jamesloper/lemontron/README.md

This is the official Lemontron website source code (lemontron.com). It is a static site generated with Jekyll and hosted on GitHub
Pages.
