jamesloper/lemontron/_bom/chassis-fans.md

---
layout: bom
title: 2510 Fan
qty: 2
orders: 1
total: 5.84
description: Chassis Fans
new: false
links: 
  - vendor: AliExpress
    url: https://www.aliexpress.us/item/2251832621295326.html
    note: "24V Ball XH2.54 (2pc)"
  - vendor: Amazon
    url: "https://www.amazon.com/dp/B0BB277V4F?&tag=lemontron-20"
    note: "Blue LED version"
kofi: true
optional: false
category: Electronics
---

Chassis fans cool the electronics.
