jamesloper/lemontron/_posts/2025-01-08-tools-needed.md

---
layout: post
title: Tools needed
description: Affiliate links!
categories: guide
kofi: true
thumbnail: /assets/guide/bed-holder---attach-spine.jpg
permalink: /lemontron/:title/
---

These tools are needed to build the Lemontron. You may already have some of them, but if not, you can buy them
through these Amazon affiliate links!

## Screw Drivers

The Lemontron benefits from deep integration and thus only M3 (2mm Hex Bit) and a few M2.5 are used. I
recommend having a dedicated high quality M3 screwdriver, plus a bit for your drill. Add a countersink bit to clean up
the printed countersinks and to add countersinks to the probe.

<div class="bom-list">
{% include tool-item.html
title = "Drill"
amazon = "B003BEE2LU"
image = "https://m.media-amazon.com/images/I/61DA7ZmQYSL._AC_SL1344_.jpg"
%}
{% include tool-item.html
title = "Driver Bit"
amazon = "B001553HD6"
image = "https://m.media-amazon.com/images/I/516vhCine0L._SS284_.jpg"
%}
{% include tool-item.html
title = "Screw Driver"
amazon = "B00365EYJO"
image = "https://c.media-amazon.com/images/I/41uY2ozOLLL._AC_SX679_.jpg"
%}
{% include tool-item.html
title = "Allen Keys"
amazon = "B083BGVMB8"
image = "https://m.media-amazon.com/images/I/61dimk22KQL._AC_SX679_.jpg"
%}
{% include tool-item.html
title = "Countersink"
amazon = "B00LLGSZGS"
image = "https://m.media-amazon.com/images/I/51H9zNxZ0kL._AC_SL1050_.jpg"
%}
</div>

## 3D Printing Tools

You will need a modern, enclosed 3D printer to print the Lemontron parts. Razors for scraping. A craft knife for tidying
blemishes. Supa glue for the Lemonstruder parts (the "liquid" one not the thick one). And tape for holding down the
pesky wires.

<div class="bom-list">
{% include tool-item.html
title = "Blade"
amazon = "B0BFHB3CXP"
image = "https://m.media-amazon.com/images/I/71CN21bxoXL._SL1500_.jpg"
%}
{% include tool-item.html
title = "Craft Knife"
amazon = "B001A42CTW"
image = "https://c.media-amazon.com/images/I/41fUo+wCOlL._AC_SX679_.jpg"
%}
{% include tool-item.html
title = "Supa Glue"
amazon = "B0D2RP4B82"
image = "https://c.media-amazon.com/images/I/41fqCAwgwsL._SY445_SX342_QL70_FMwebp_.jpg"
%}
{% include tool-item.html
title = "Tape"
amazon = "B07CB6F1BB"
image = "https://m.media-amazon.com/images/I/81uQsI8mtuL._AC_SL1500_.jpg"
%}
</div>

## Electrical Tools

A soldering iron is needed for soldering the edge connector and other wires. For the
motors, you'll need some wire cutters and a crimper. You may try your luck with a soldering iron.

<div class="bom-list">
{% include tool-item.html
title = "Crimper"
amazon = "B078WPT5M1"
image = "https://c.media-amazon.com/images/I/51dedm3GiLL._AC_SL1500_.jpg"
%}
{% include tool-item.html
title = "Wire Strippers"
amazon = "B000XEUPMQ"
image = "https://m.media-amazon.com/images/I/51maEt4e8LL._AC_SX679_.jpg"
%}
{% include tool-item.html
title = "Soldering Iron"
amazon = "B096X6SG13"
image = "/assets/content/pinecil.jpg"
%}
</div>

## Trimming Tools

The motor shafts and X-Axis rail must be shortened. A Dremel with a cutoff wheel is recommended. Flush cutters are also
required, but 3d printers tend to come with those.

<div class="bom-list">
{% include tool-item.html
title = "Dremel"
amazon = "B0D2D28FSV"
image = "https://c.media-amazon.com/images/I/81CnWmPqoML._AC_SX679_.jpg"
%}
{% include tool-item.html
title = "Flush Cutter"
amazon = "B00FZPDG1K"
image = "https://m.media-amazon.com/images/I/41W4+oUpeNL._SX522_.jpg"
%}

</div>
