jamesloper/lemontron/lemontron/index.md

---
layout: post
title: Build a Lemontron
header_title: Lemontron
kofi: true
permalink: /lemontron/
---

{% include youtube-video.html id="n6l3GvkE4QU" %}

Lemontron is a **DIY** project - there are no kits - you must buy the parts online and assemble them.

Watch the video, then follow the build guide below for the most up-to-date instructions.

<div class="paragraph btn-wrapper">
{% include button.html 
icon="looks_one"
title="Download Lemontron" 
link="/lemontron/download/" %}

{% include button.html
icon="looks_two"
title="Order the parts"
link="/lemontron/bom/" %}

{% include button.html
icon="looks_3"
title="Follow the build guide"
link="/lemontron/build-guide/" %}
</div>

## More Guides

{% include guides.html %}

<br/>
All Lemontron content is brand new, so it's subject to changes and fixes, which can be confusing if you are
referencing them. If you have any questions, please reach out to me on Discord.
