jamesloper/lemontron/_posts/2024-12-24-lemontron-open-source-annoucement.md

---
layout: post
title:  "Lemontron open source printer is ready to download"
categories: update
thumbnail: /assets/content/lemontron-printing-a-lemon.jpg
permalink: /news/:title
---

After a year of development, the affordable 3d printer for Australians is finally here, with a build plate that's upside
down, an ultra thin motion system mounted real low, and the flattest tool head you'll ever find.

{% include youtube-video.html id="n6l3GvkE4QU" %}

Lemontron is the newest Positron-style printer, which means it's able to fold up and fit in a box of filament. It is the
most cost-reduced and refined version yet, with a fully 3d printed chassis that you can now print at home, because the
3MF and Fusion 360 project is now available to download!

<div class="btn-wrapper">
{% include button.html title="Build yours" link="/lemontron/" %}
{% include kofi.html %}
</div>
