jamesloper/lemontron/_posts/2024-05-30-lemontron-video-update.md

---
layout: post
title:  "Progress Continues"
categories: update video
thumbnail: https://i.ytimg.com/vi/KzQWi5mGpFI/hqdefault.jpg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
permalink: /news/:title
---

With protective top plates, an integrated extruder and a filament holding solution!

The project is officially now called "Lemontron" to reflect my zest for 3d printing ON THE GO! Exciting times ahead
because the Positron space in general is heating up! Shout out to MihaiDesigns for his video that helped me make an
informed design decision.

{% include youtube-video.html id="KzQWi5mGpFI" %}
