jamesloper/lemontron/_posts/2024-11-11-3rd-prototype.md

---
layout: post
title:  "3rd Prototype"
categories: update video
thumbnail: /assets/posts/2024-11-11.jpg
permalink: /news/:title
---

Development of the Positron 3D printer unibody chassis continues with the 3rd prototype of the Lemontron. Now that it's printing, Lemontron delivers on previous promises and then some!

{% include youtube-video.html id="jw9OEQeSKPE" %}
