jamesloper/lemontron/_posts/2024-03-31-lemontron-intro-video.md

---
layout: post
blog: news
title:  "Lemontron Reveal"
categories: update video
thumbnail: https://i.ytimg.com/vi/JKpA4ocmRE0/hqdefault.jpg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
permalink: /news/:title
---

THE FUTURE IS NOW! @mcfazio4283's "JourneyMaker" design inspired me; Now I'm building a new base for the positron printer with a new UNIBODY design that cuts down on parts! HUGE!!!

{% include youtube-video.html id="JKpA4ocmRE0" %}
