jamesloper/lemontron/assets/about/body.jpg

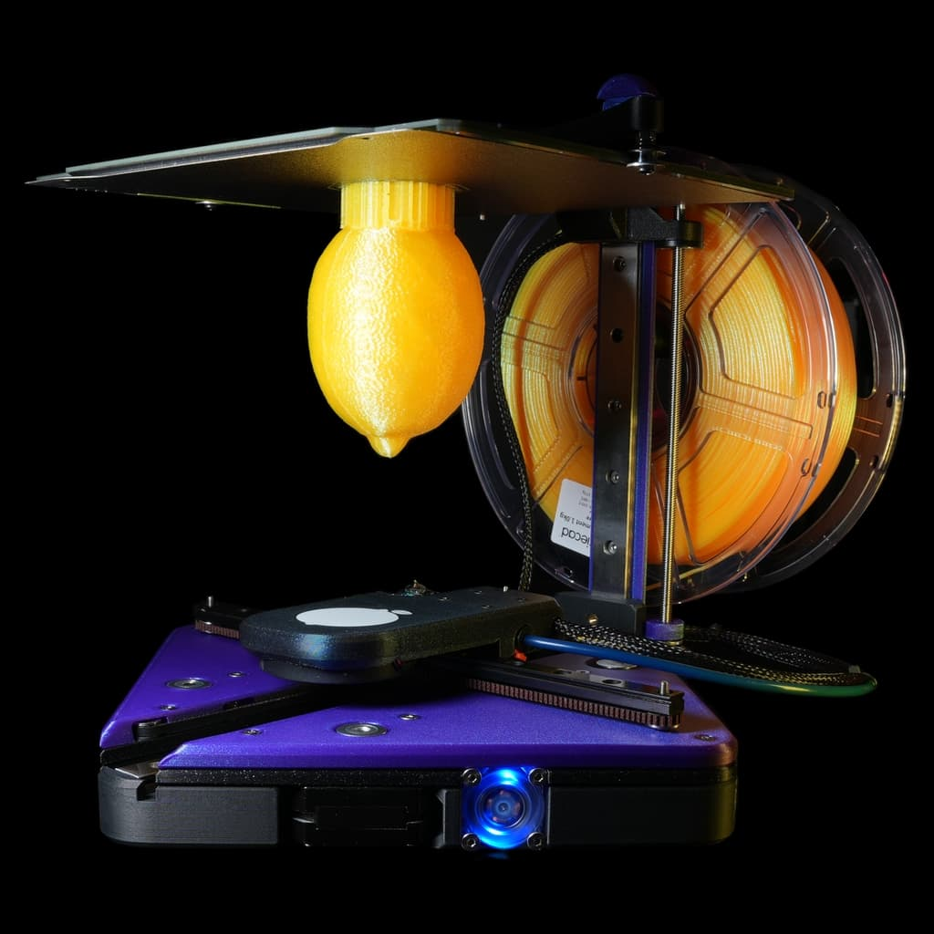
assets/about/body.jpg
