jamesloper/lemontron/assets/about/james.jpg

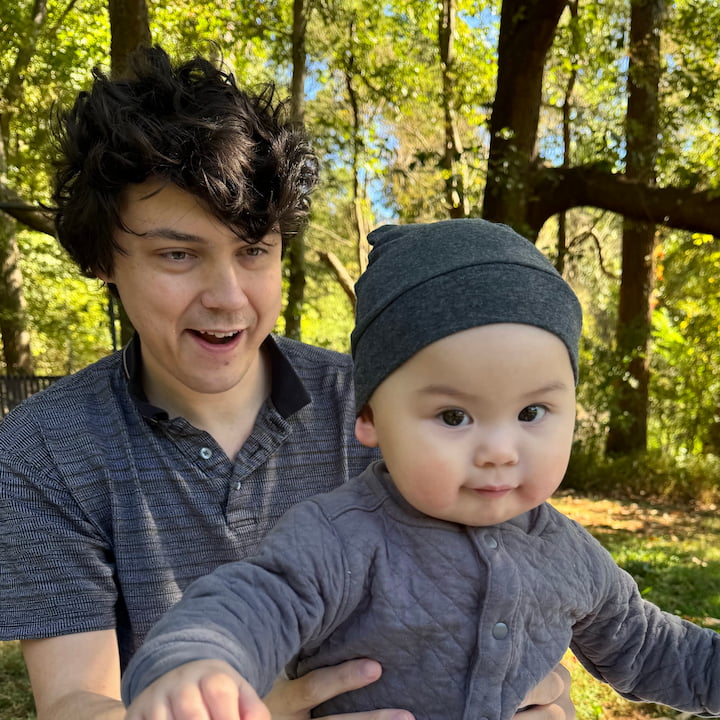
assets/about/james.jpg
