jamesloper/lemontron/assets/about/patreon.png

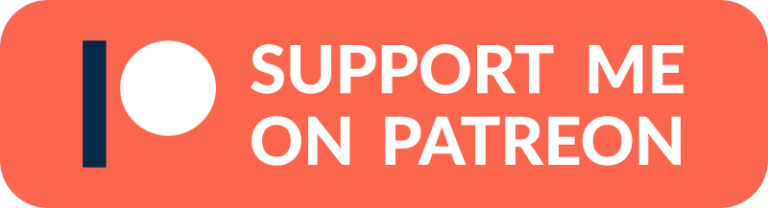
assets/about/patreon.png
