jamesloper/lemontron/assets/bom/chassis-fans.png

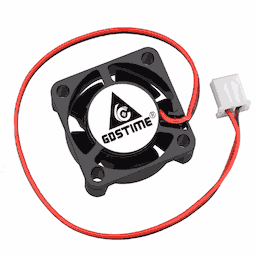
assets/bom/chassis-fans.png
