jamesloper/lemontron/assets/content/crimp.jpg

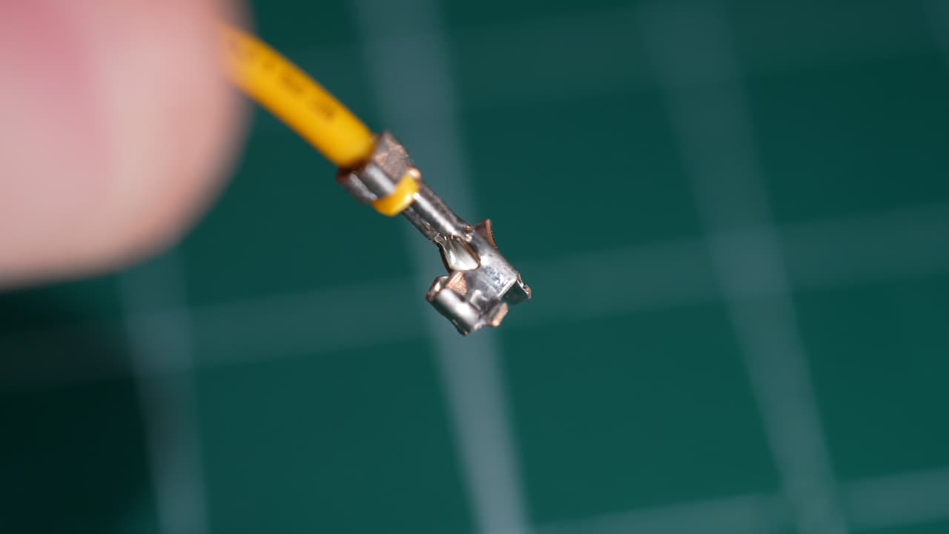
assets/content/crimp.jpg
