jamesloper/lemontron/assets/content/journeymaker.jpg

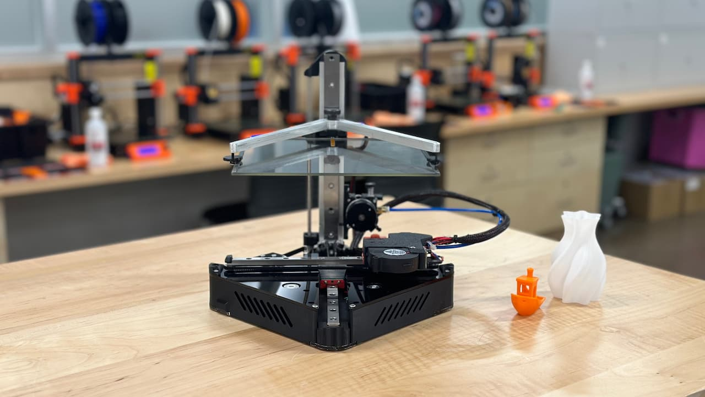
assets/content/journeymaker.jpg
