jamesloper/lemontron/assets/content/pinecil.jpg

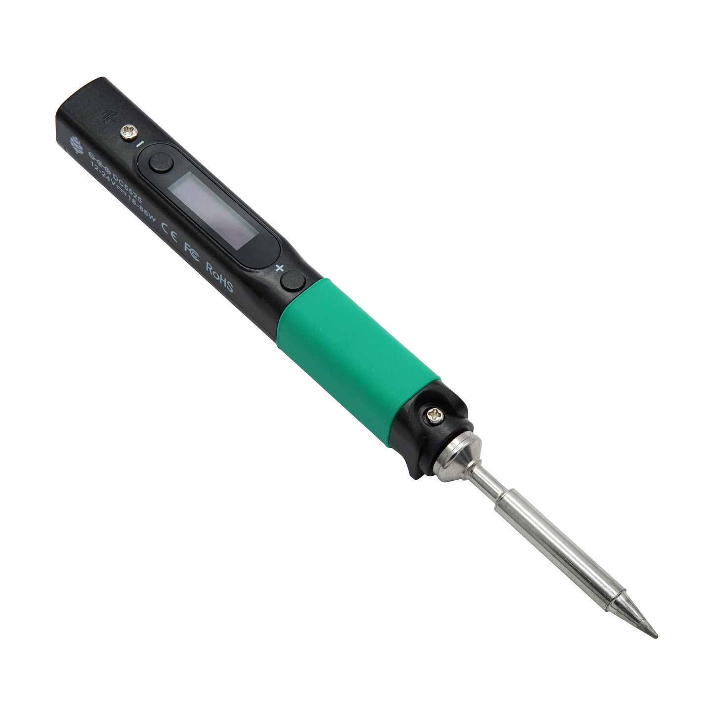
assets/content/pinecil.jpg
