jamesloper/lemontron/assets/guide/chassis---ac-input.jpg

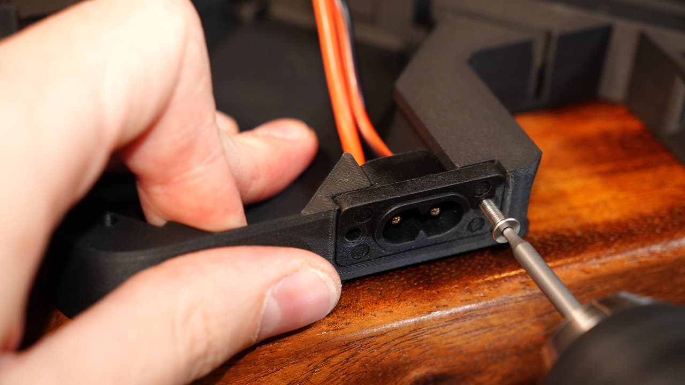
assets/guide/chassis---ac-input.jpg
