jamesloper/lemontron/assets/guide/chassis---attach-z-axis.jpg

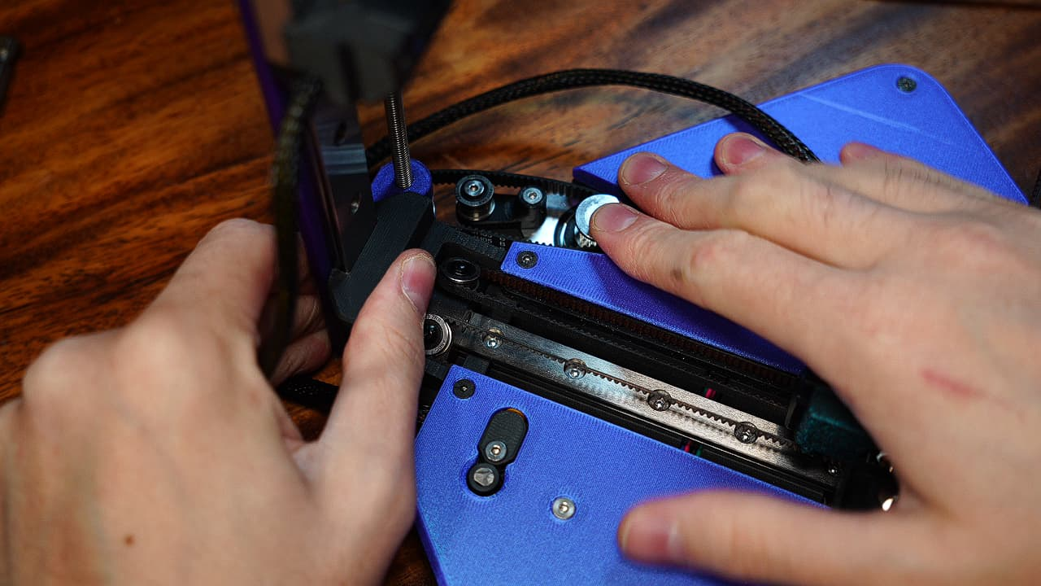
assets/guide/chassis---attach-z-axis.jpg
