jamesloper/lemontron/assets/guide/chassis---attach-z-idler.jpg

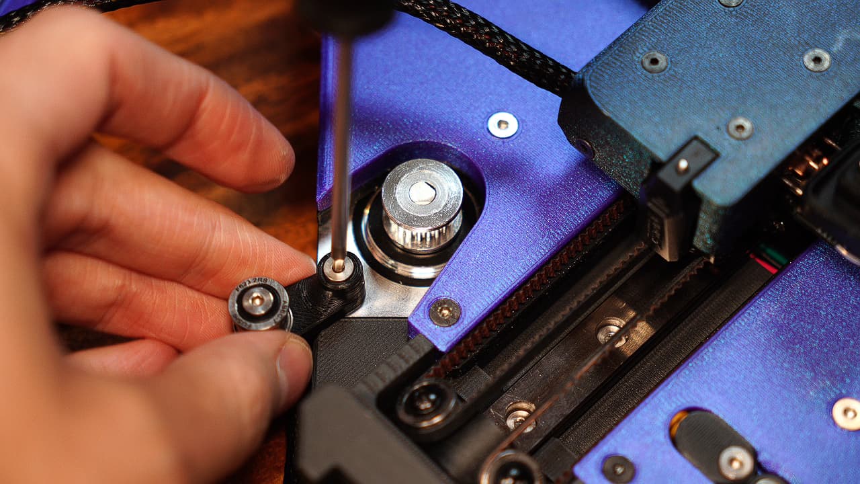
assets/guide/chassis---attach-z-idler.jpg
