jamesloper/lemontron/assets/guide/chassis---bonus-screw.jpg

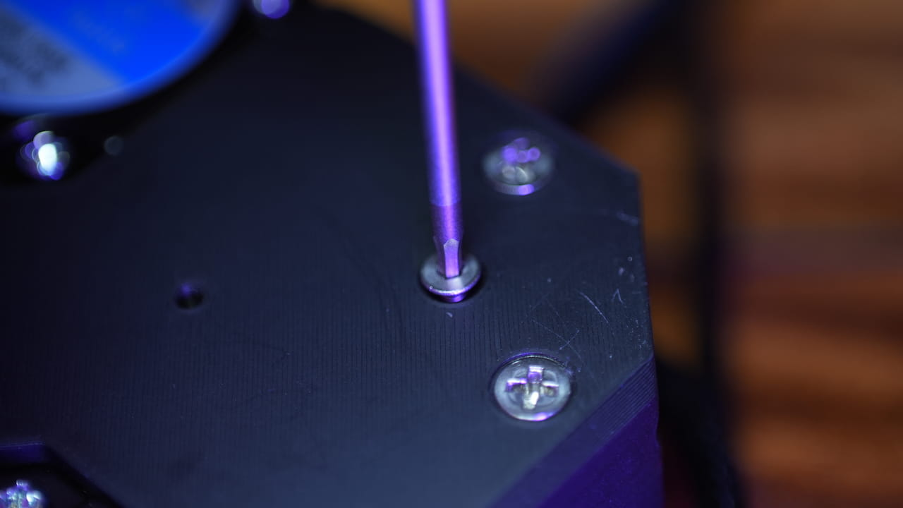
assets/guide/chassis---bonus-screw.jpg
