jamesloper/lemontron/assets/guide/chassis---clean-up-inserts.jpg

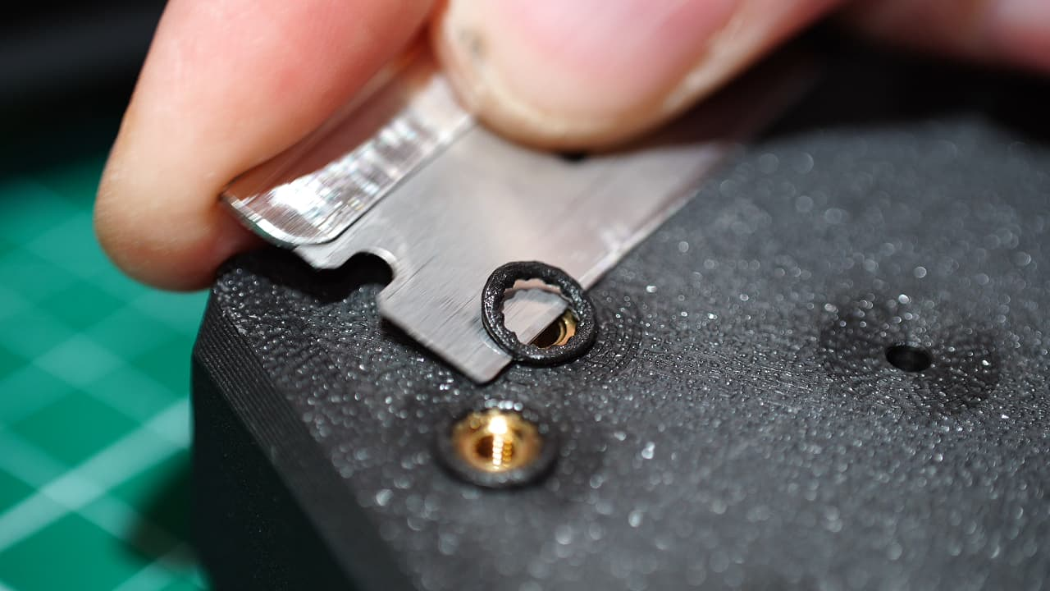
assets/guide/chassis---clean-up-inserts.jpg
