jamesloper/lemontron/assets/guide/chassis---connect-raspberry-pi.jpg

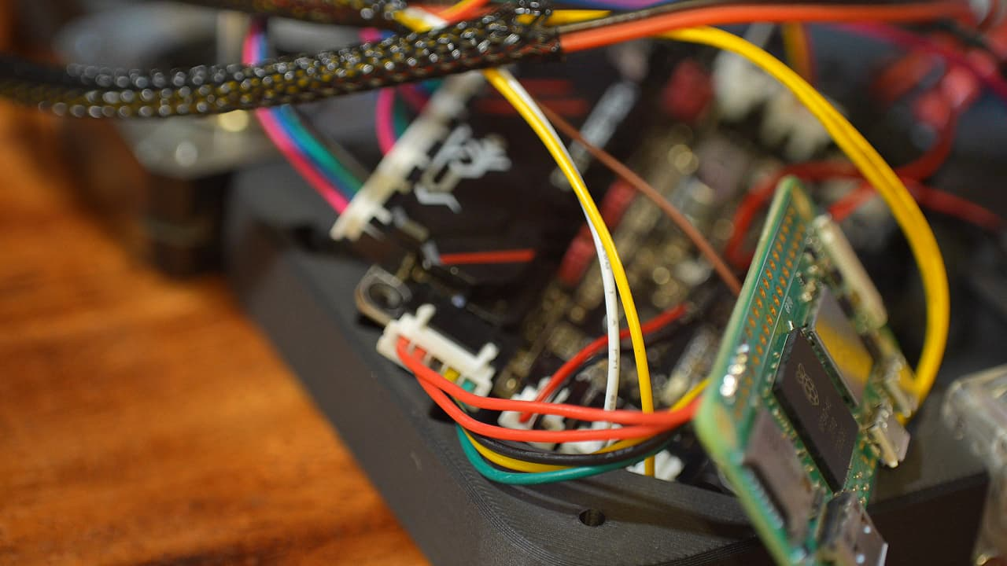
assets/guide/chassis---connect-raspberry-pi.jpg
