jamesloper/lemontron/assets/guide/chassis---fans.jpg

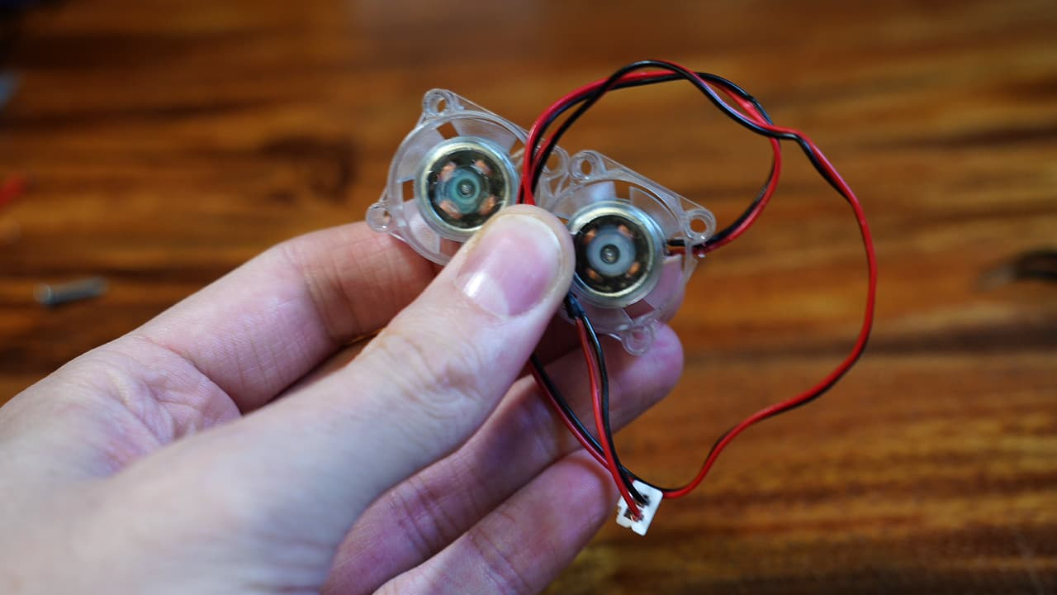
assets/guide/chassis---fans.jpg
