jamesloper/lemontron/assets/guide/chassis---fasten-rail.jpg

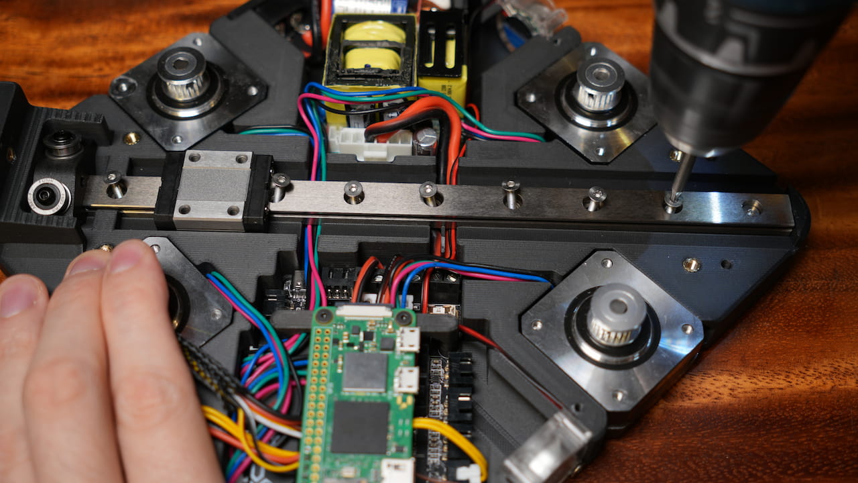
assets/guide/chassis---fasten-rail.jpg
