jamesloper/lemontron/assets/guide/chassis---insert-left-fan.jpg

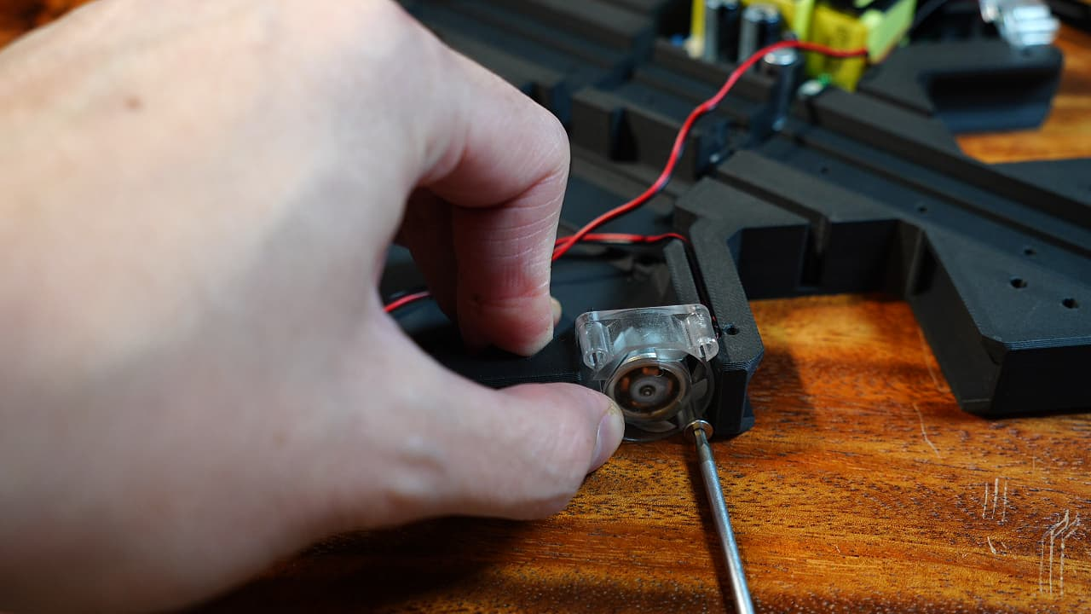
assets/guide/chassis---insert-left-fan.jpg
