jamesloper/lemontron/assets/guide/chassis---insert-motors.jpg

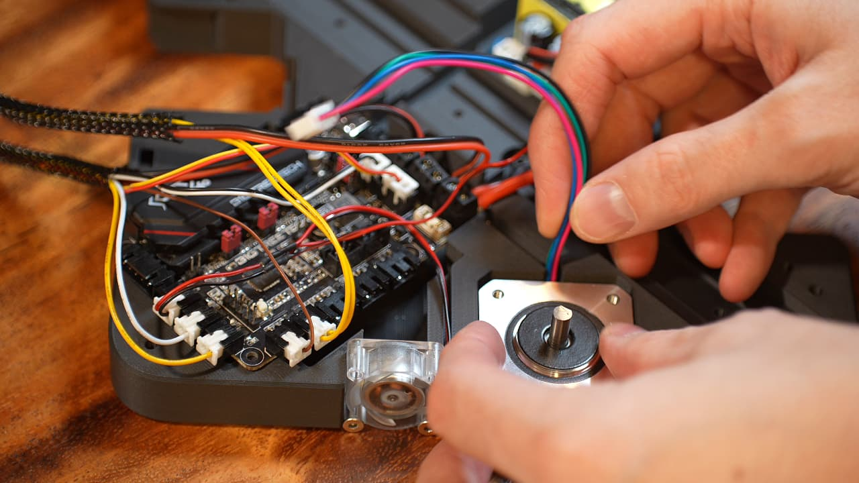
assets/guide/chassis---insert-motors.jpg
