jamesloper/lemontron/assets/guide/chassis---insert-right-fan.jpg

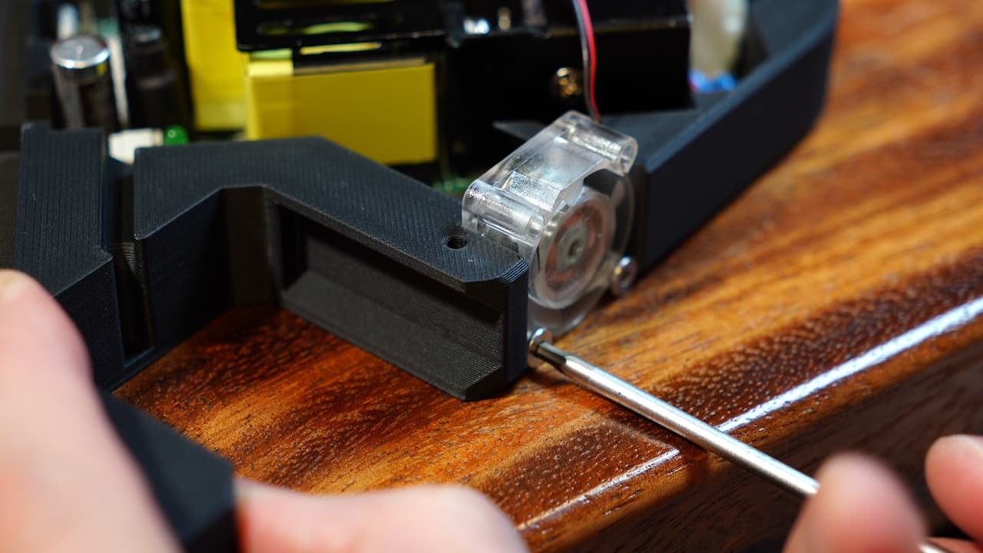
assets/guide/chassis---insert-right-fan.jpg
