jamesloper/lemontron/assets/guide/chassis---left---finish-fan-screws.jpg

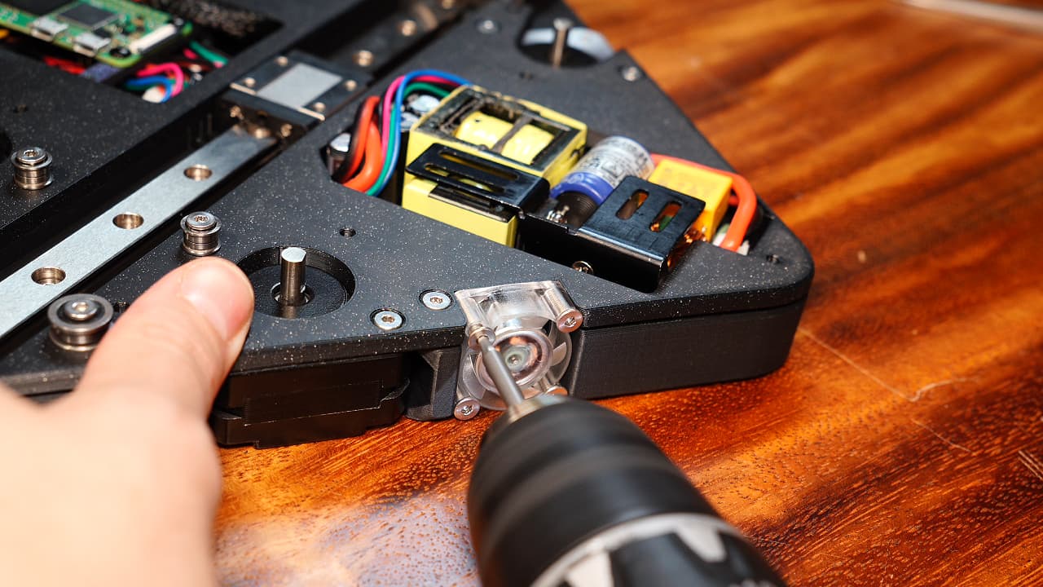
assets/guide/chassis---left---finish-fan-screws.jpg
