jamesloper/lemontron/assets/guide/chassis---plug-in-bed-heater.jpg

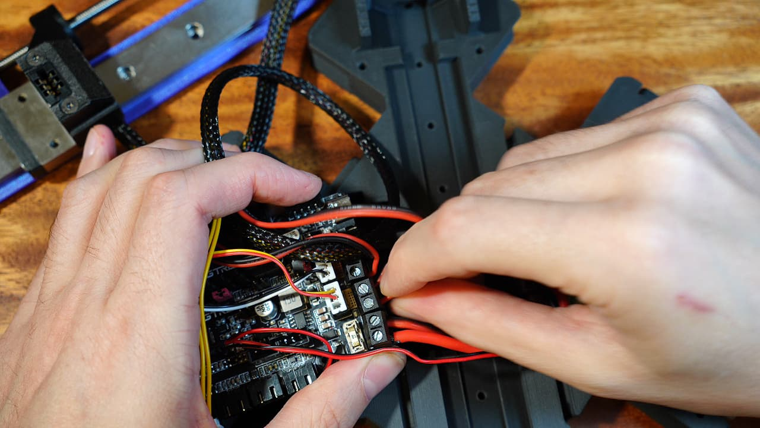
assets/guide/chassis---plug-in-bed-heater.jpg
