jamesloper/lemontron/assets/guide/chassis---plug-in-bed-thermistor.jpg

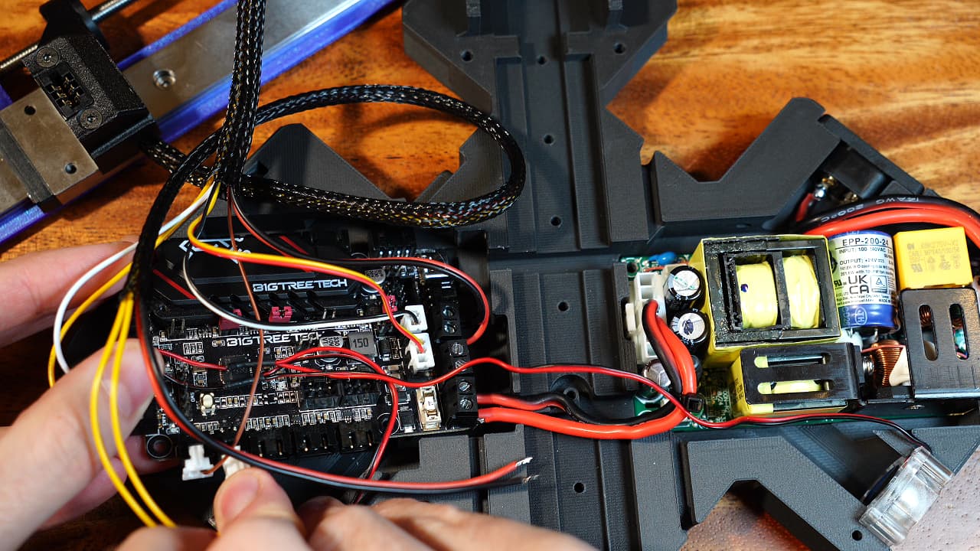
assets/guide/chassis---plug-in-bed-thermistor.jpg
