jamesloper/lemontron/assets/guide/chassis---plug-in-fans.jpg

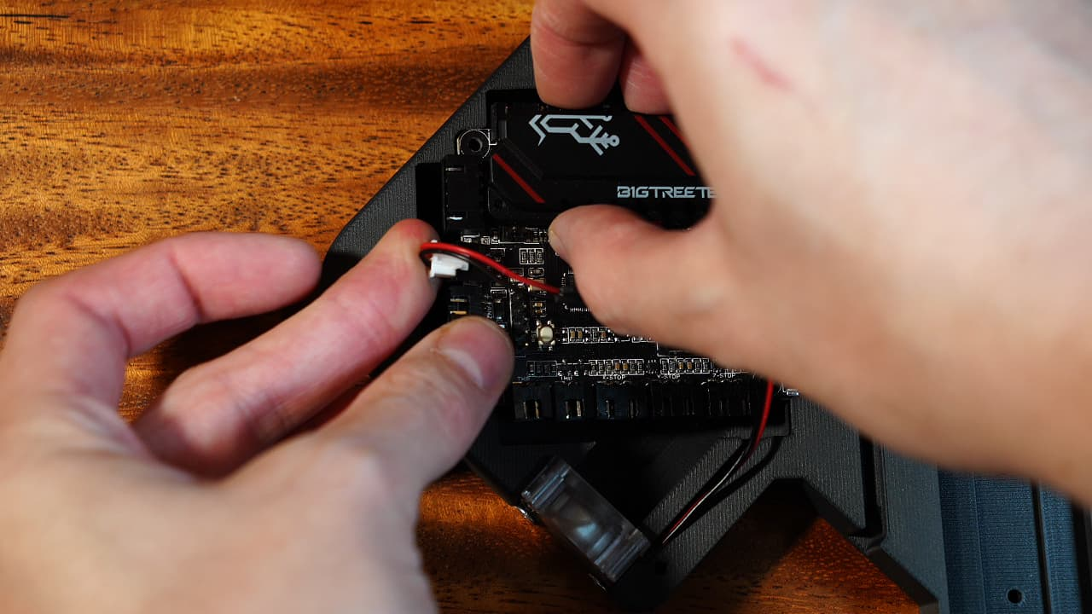
assets/guide/chassis---plug-in-fans.jpg
