jamesloper/lemontron/assets/guide/chassis---plug-in-hotend-fan.jpg

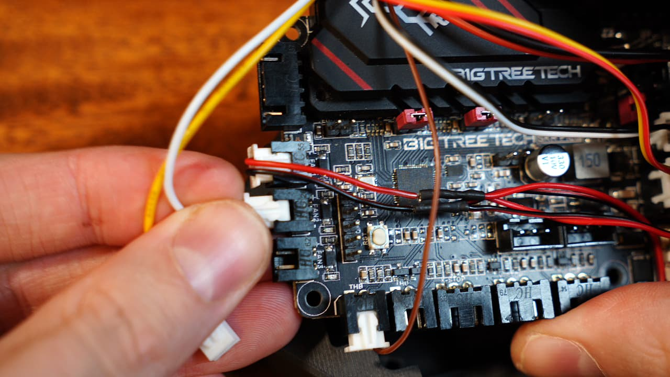
assets/guide/chassis---plug-in-hotend-fan.jpg
