jamesloper/lemontron/assets/guide/chassis---plug-in-hotend-power.jpg

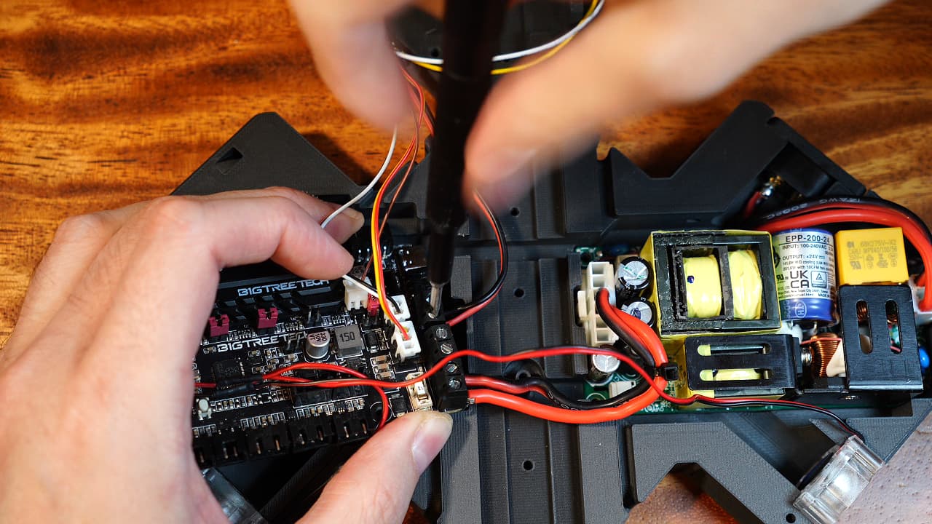
assets/guide/chassis---plug-in-hotend-power.jpg
