jamesloper/lemontron/assets/guide/chassis---plug-in-part-cooling-fan.jpg

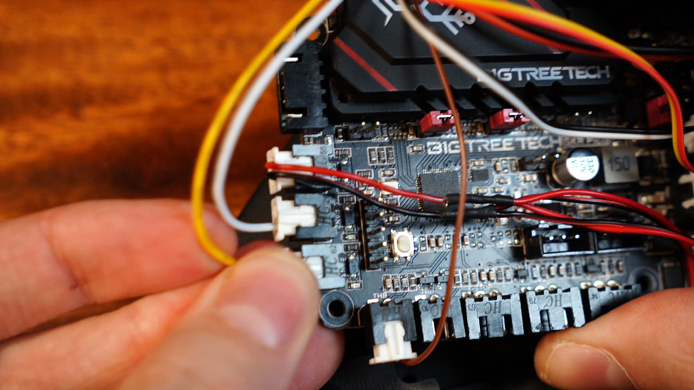
assets/guide/chassis---plug-in-part-cooling-fan.jpg
