jamesloper/lemontron/assets/guide/chassis---plug-in-power.jpg

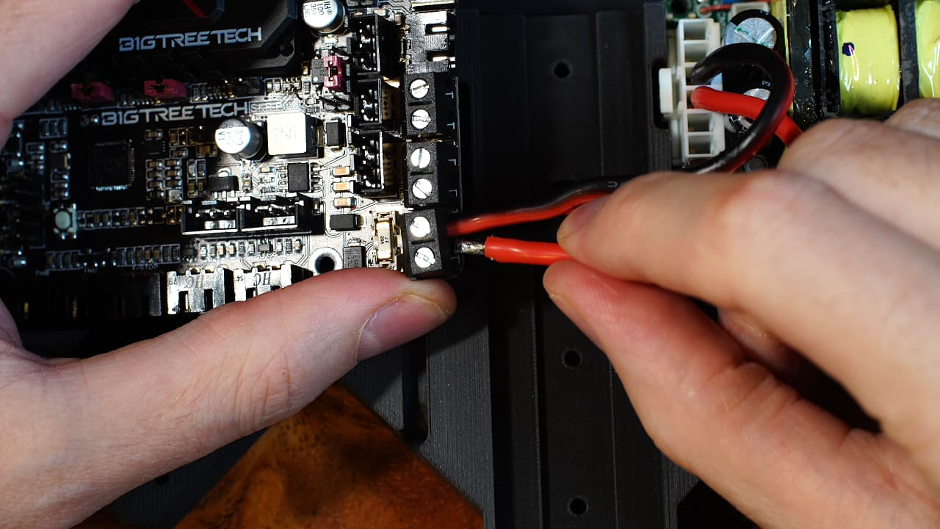
assets/guide/chassis---plug-in-power.jpg
