jamesloper/lemontron/assets/guide/chassis---plug-in-probe.jpg

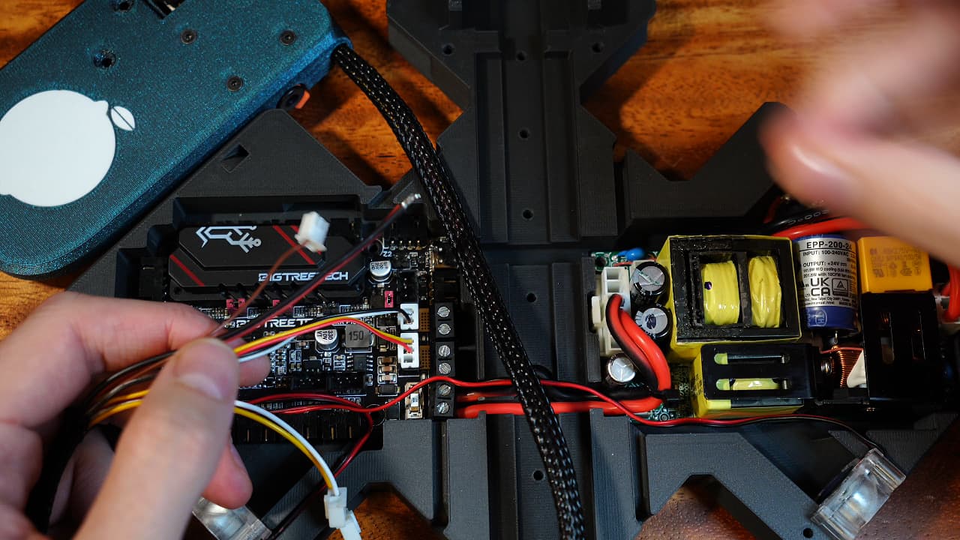
assets/guide/chassis---plug-in-probe.jpg
