jamesloper/lemontron/assets/guide/chassis---plug-in-thermistor.jpg

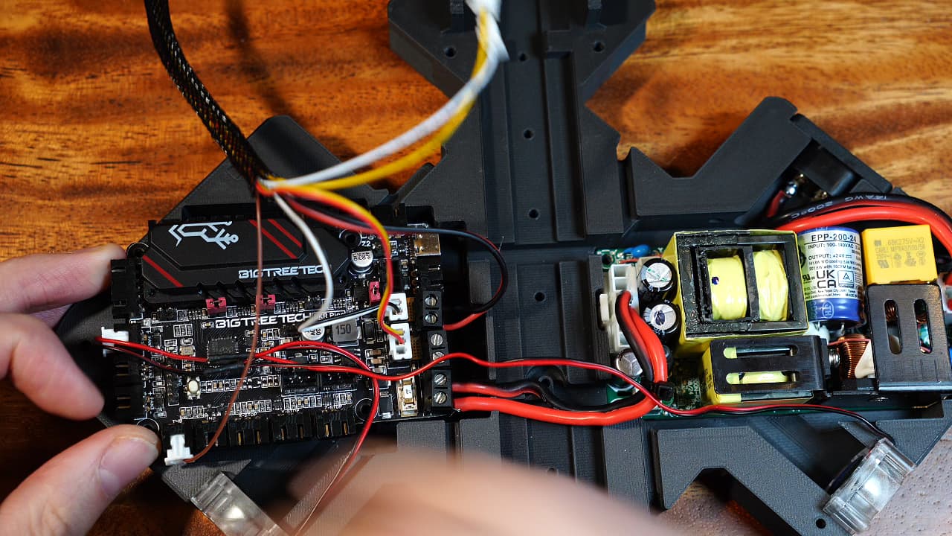
assets/guide/chassis---plug-in-thermistor.jpg
