jamesloper/lemontron/assets/guide/chassis---plug-motor-connectors.jpg

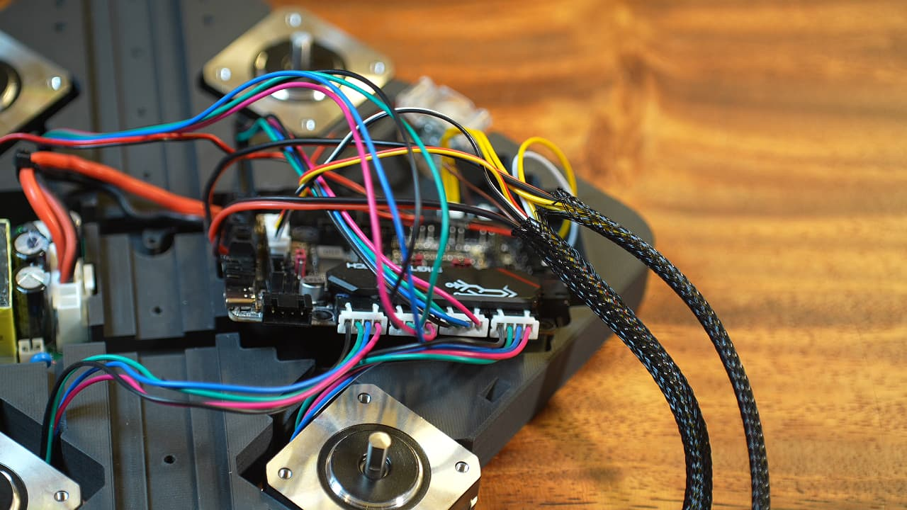
assets/guide/chassis---plug-motor-connectors.jpg
