jamesloper/lemontron/assets/guide/chassis---right---finish-fan-screws.jpg

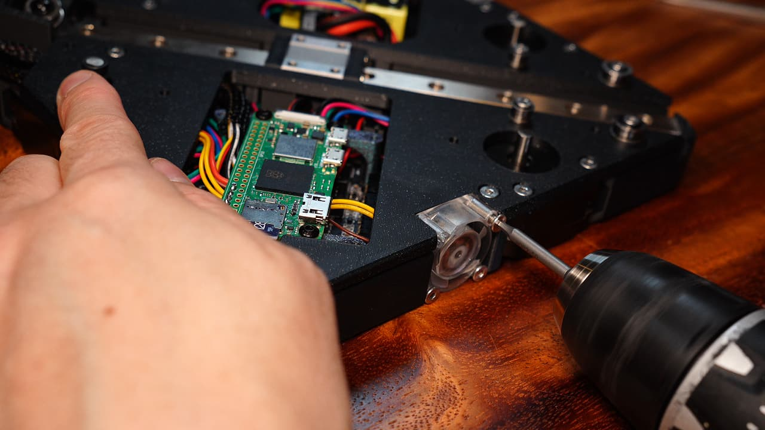
assets/guide/chassis---right---finish-fan-screws.jpg
