jamesloper/lemontron/assets/guide/chassis---risers---screws.jpg

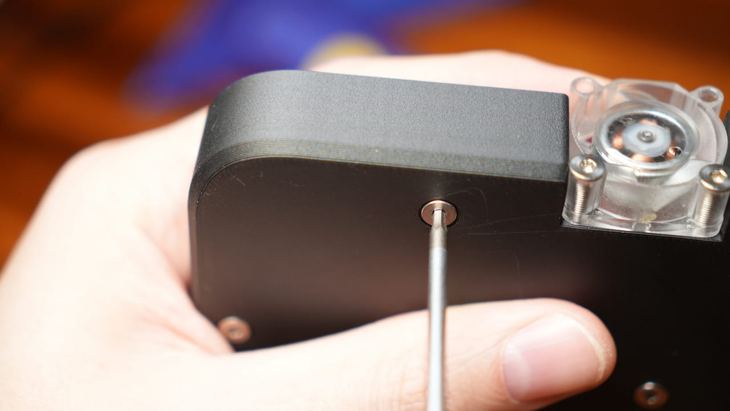
assets/guide/chassis---risers---screws.jpg
