jamesloper/lemontron/assets/guide/chassis---risers.jpg

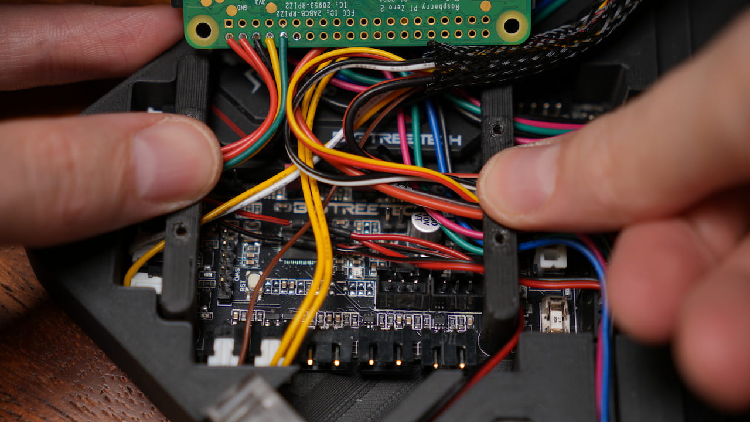
assets/guide/chassis---risers.jpg
