jamesloper/lemontron/assets/guide/chassis---screw-in-z-axis.jpg

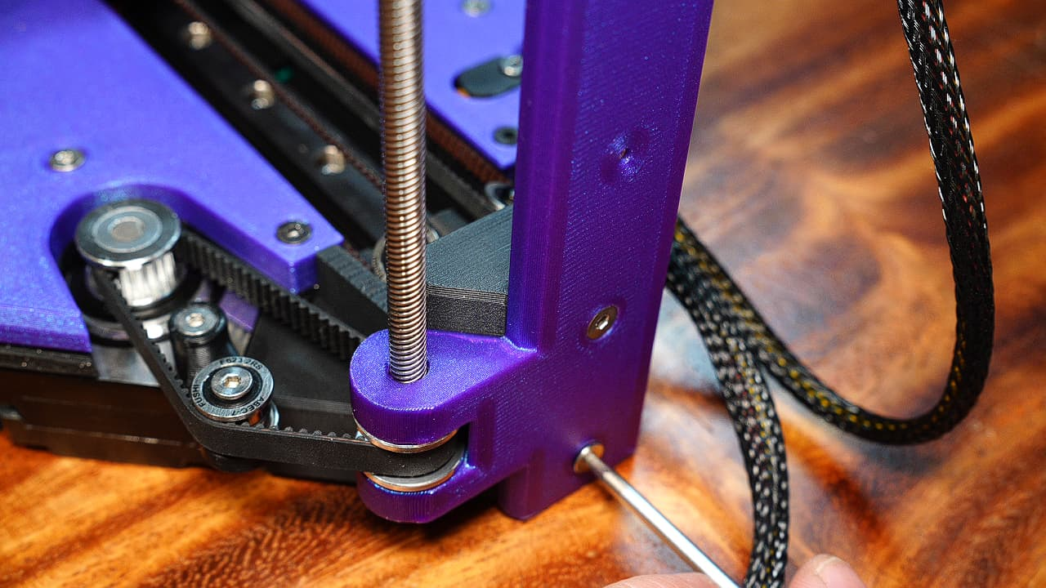
assets/guide/chassis---screw-in-z-axis.jpg
