jamesloper/lemontron/assets/guide/chassis---screw-raspberry-pi.jpg

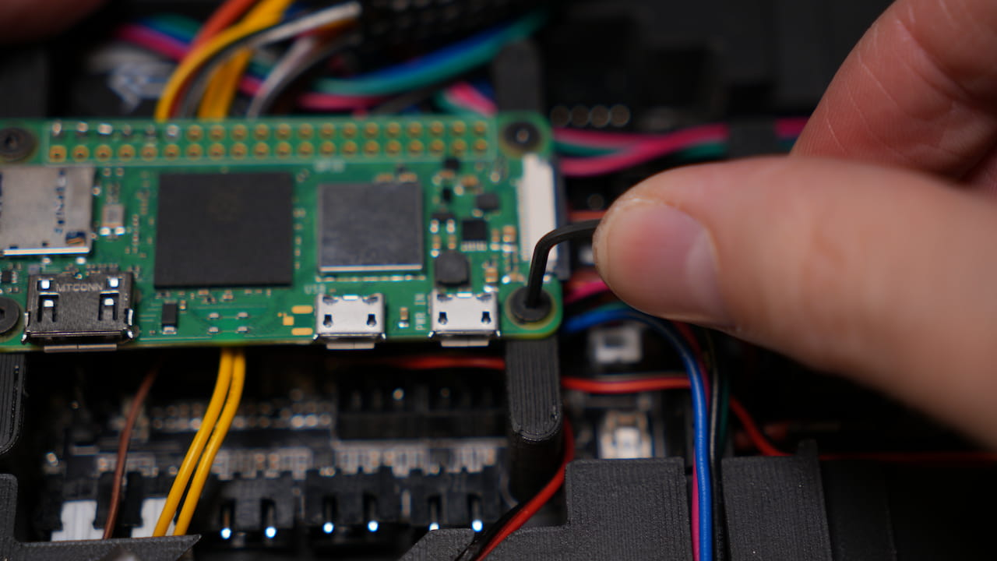
assets/guide/chassis---screw-raspberry-pi.jpg
