jamesloper/lemontron/assets/guide/chassis---smush-mcu.jpg

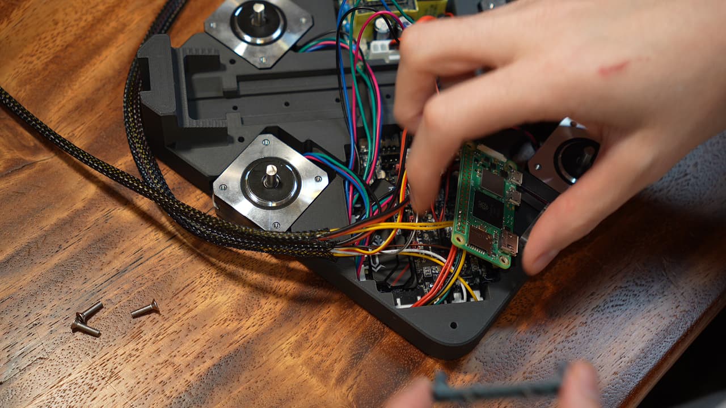
assets/guide/chassis---smush-mcu.jpg
