jamesloper/lemontron/assets/guide/chassis---stiffener-horizontal.jpg

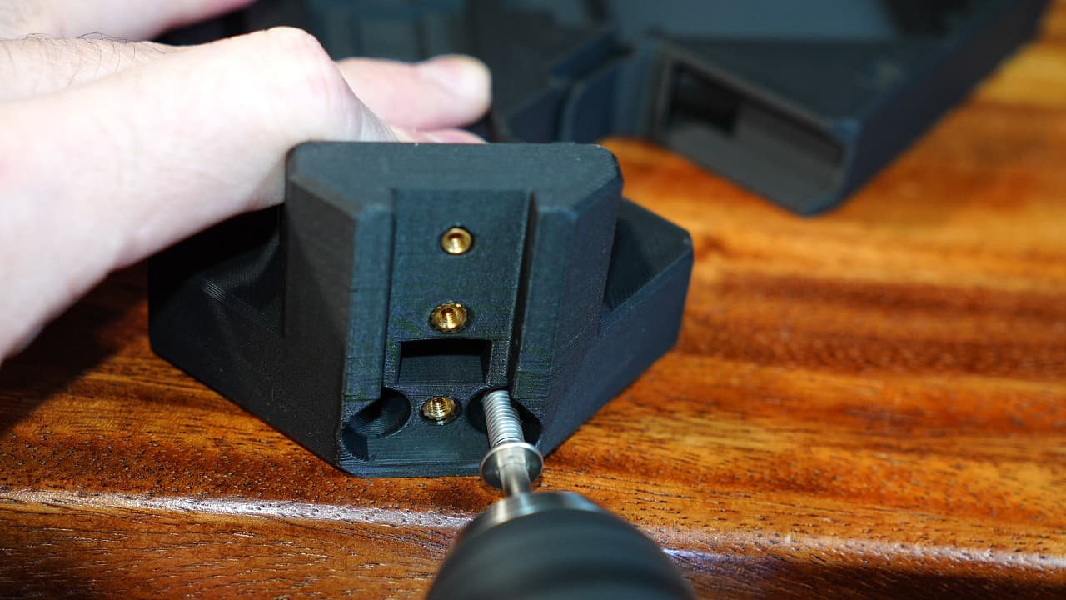
assets/guide/chassis---stiffener-horizontal.jpg
