jamesloper/lemontron/assets/guide/chassis---stiffener-vertical.jpg

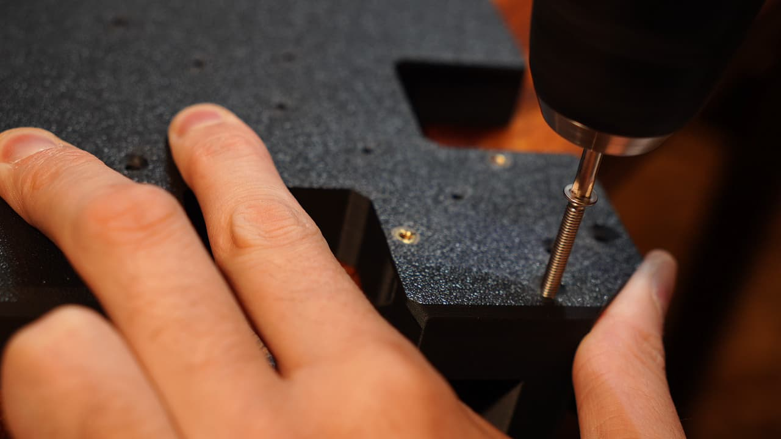
assets/guide/chassis---stiffener-vertical.jpg
