jamesloper/lemontron/assets/guide/chassis---tape.jpg

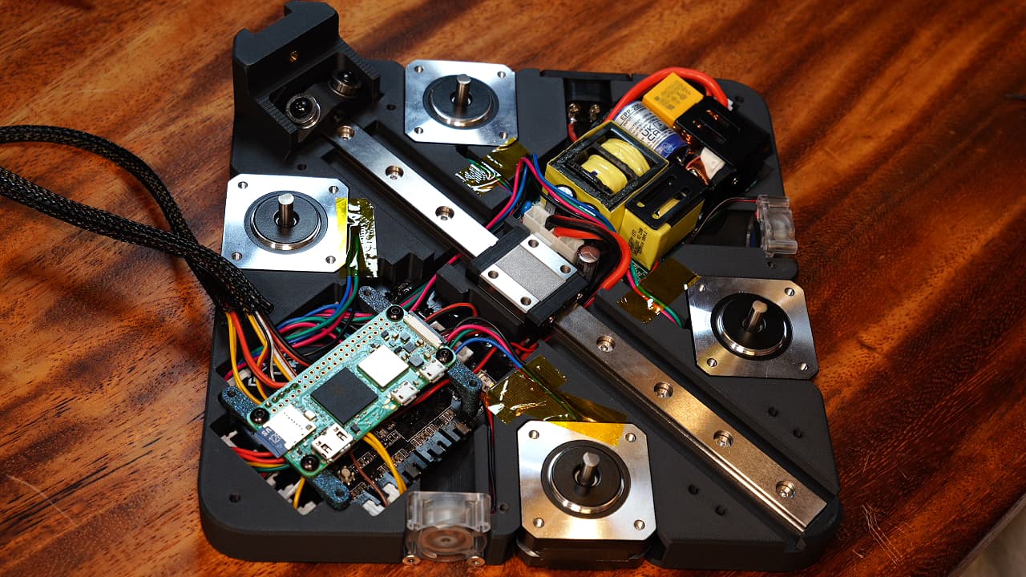
assets/guide/chassis---tape.jpg
