jamesloper/lemontron/assets/guide/chassis---threaded-inserts.jpg

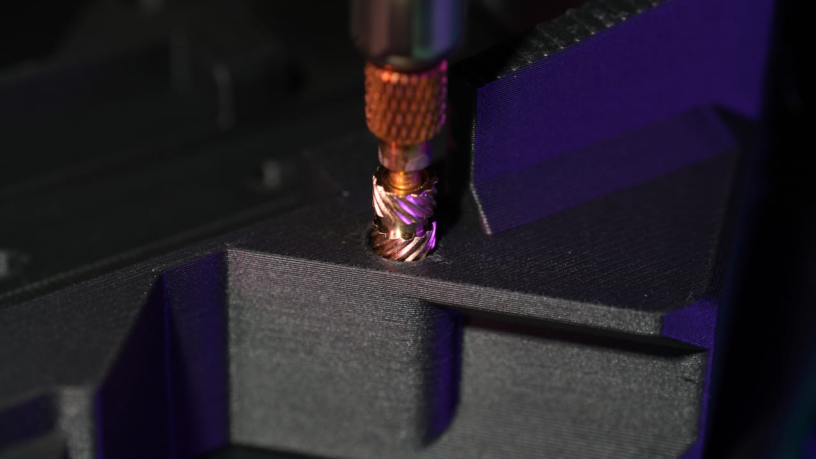
assets/guide/chassis---threaded-inserts.jpg
