jamesloper/lemontron/assets/guide/chassis---tool---attach-clip.jpg

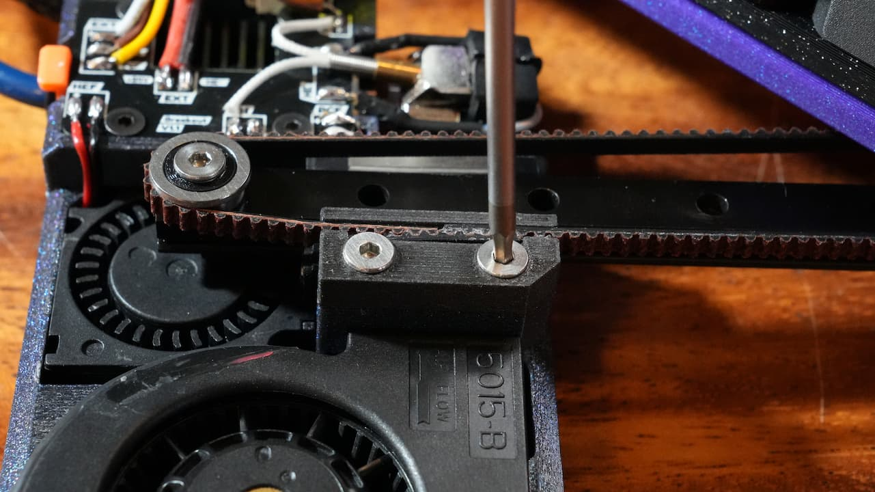
assets/guide/chassis---tool---attach-clip.jpg
