jamesloper/lemontron/assets/guide/chassis---tool---screws.jpg

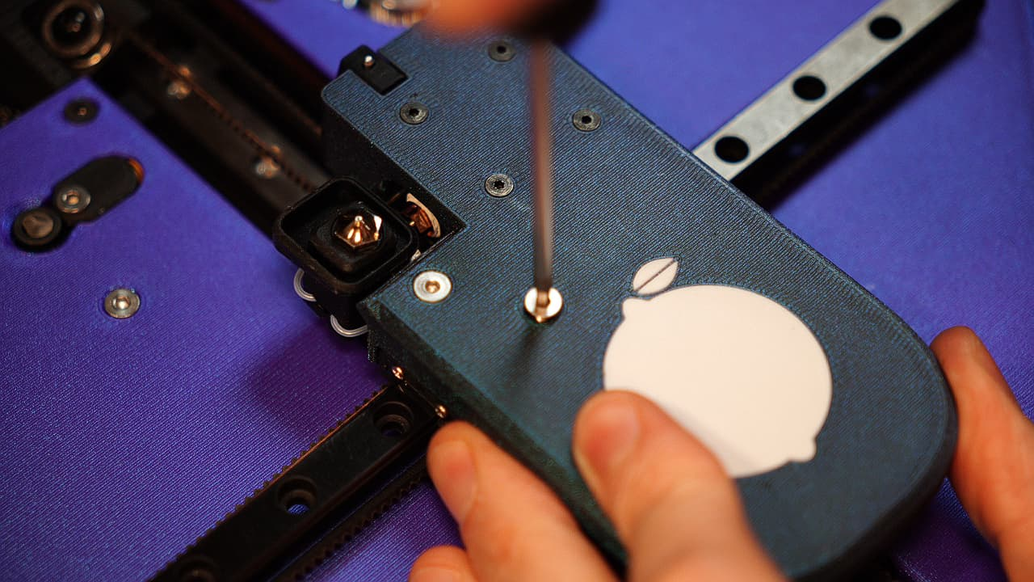
assets/guide/chassis---tool---screws.jpg
