jamesloper/lemontron/assets/guide/chassis---tug-cables.jpg

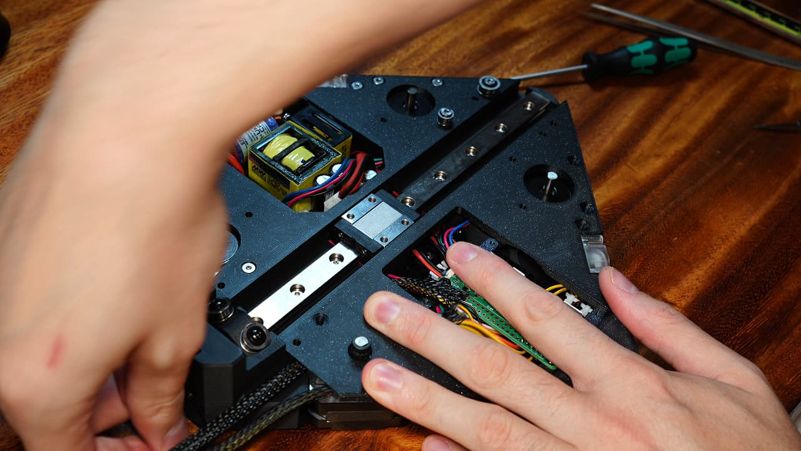
assets/guide/chassis---tug-cables.jpg
