jamesloper/lemontron/assets/guide/chassis---z-block-bottom-inserts.jpg

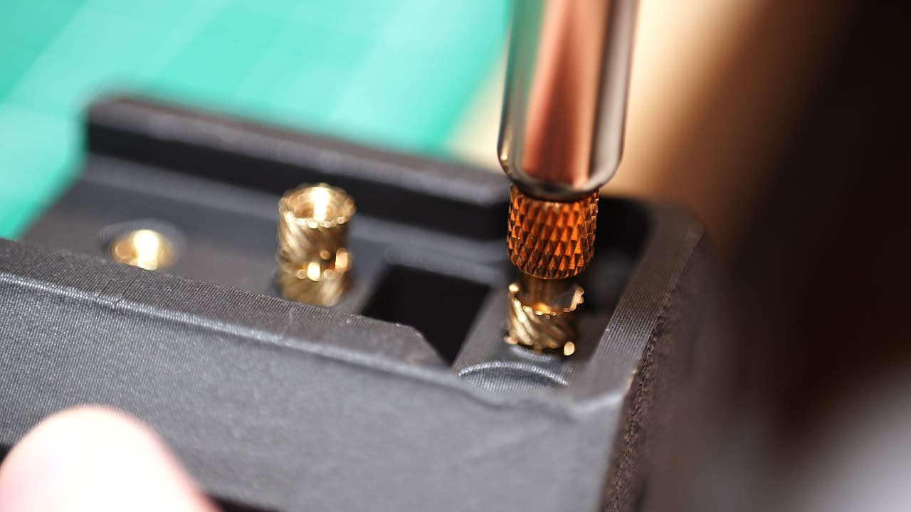
assets/guide/chassis---z-block-bottom-inserts.jpg
