jamesloper/lemontron/assets/guide/chassis---z-block-top-insert.jpg

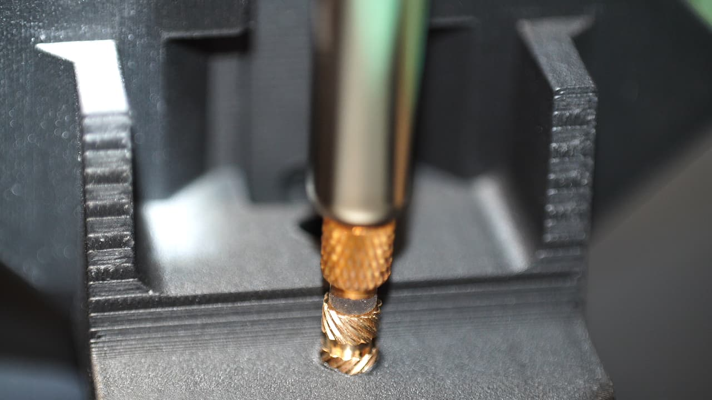
assets/guide/chassis---z-block-top-insert.jpg
