jamesloper/lemontron/assets/guide/chassis.jpg

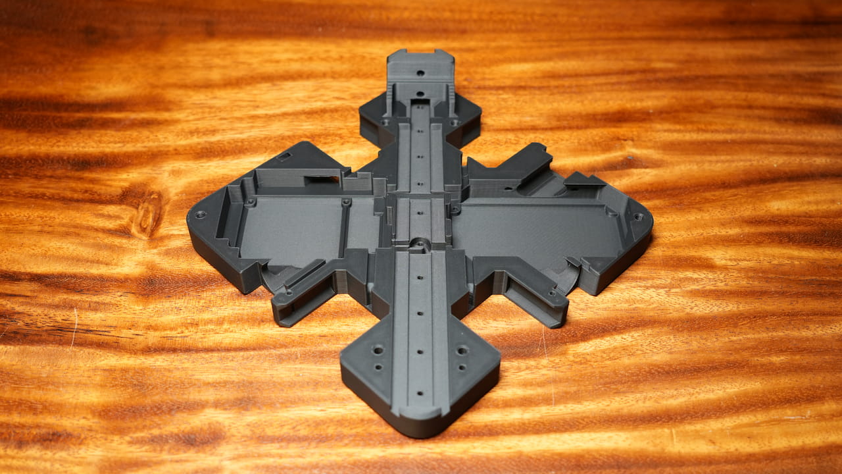
assets/guide/chassis.jpg
