jamesloper/lemontron/assets/home/thumbnail.png

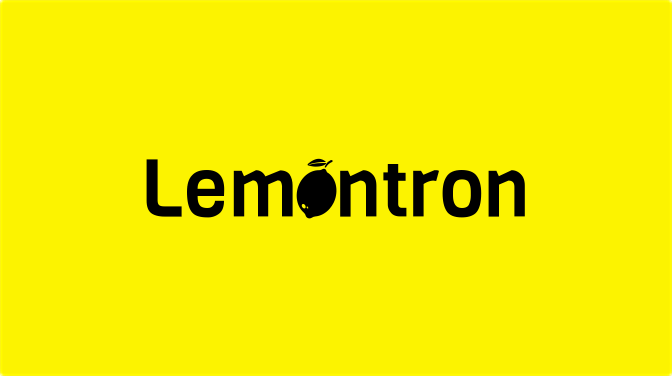
assets/home/thumbnail.png
