jamesloper/lemontron/assets/posts/2024-11-11.jpg

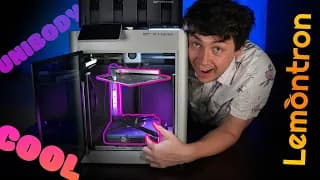
assets/posts/2024-11-11.jpg
