jamesloper/lemontron/assets/posts/2024-11-16.jpg

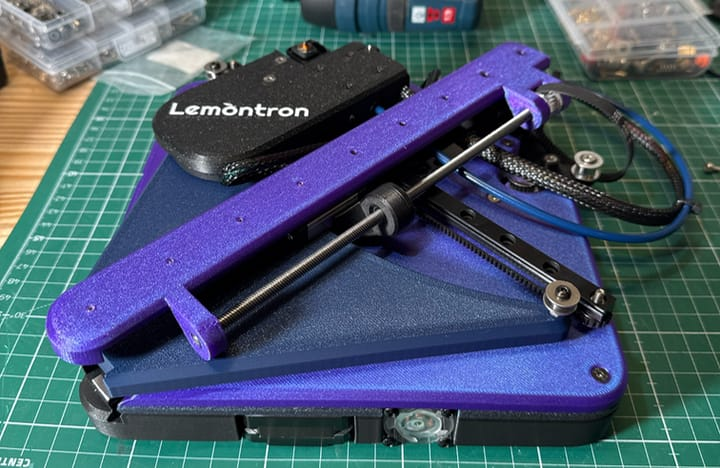
assets/posts/2024-11-16.jpg
