jamesloper/lemontron/assets/printed-parts/chassis.png

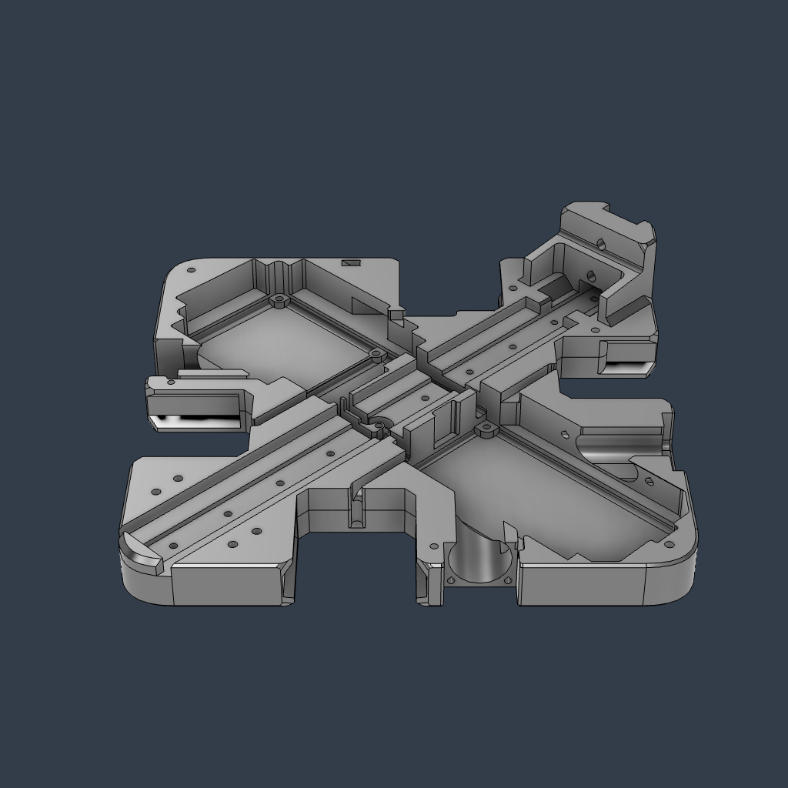
assets/printed-parts/chassis.png
