jamesloper/lemontron/_bom/toolhead-pcb.md

---
layout: bom
title: Toolhead PCB
qty: 1
orders: 1
total: 24.98
description: Breakout PCB v1.3
new: false
links: 
  - vendor: PCBWay
    url: "https://www.pcbway.com/project/shareproject/Lemontron_Tool_End_Breakout_Board_f0f9f248.html"
kofi: true
optional: true
category: Electronics
---

This simple little breakout board enhances the fun of assembling the Lemontron Tool Head. This board sits on the
aluminum heat sink and provides pads to solder each component to. You can always build a Lemontron Tool Head without it,
but manual wire management in such a small area can be frustrating.

Optimal thickness is 1mm, the thickness is definitely not critical.

Designed by Sample Name & Lemontron.

On the previous version (v1.2) the silkscreen had a mistake. The HEF and PCF labels are swapped. The EXT pads should
read (top to bottom) PCF, TH+, HEF. This is fixed in v1.3!
