jamesloper/lemontron/_bom/m3-medium-shims.md

---
layout: bom
title: M3 Medium Shims
qty: 10
orders: 1
total: 1.15
description: M3 x 7mm x 0.2mm
new: true
links:
  - vendor: AliExpress
    url: https://www.aliexpress.us/item/3256802114850018.html
    note: M3x7xThick 50pcs, 0.2mm thick
kofi: true
optional: false
category: Hardware
---

| Location | Quantity |
|---|---|
| [Lower Pulleys](/assets/guide/midplate---right---lower-pulley.jpg) | 2 |
| [X Idlers](/assets/guide/rail---x---install-bearings.jpg) | 2 |
| [Z Idler](/assets/guide/chassis---attach-z-idler.jpg) | 2 |
| [Belt Tensioner](/assets/guide/rail---tensioner---posts.jpg) | 2 |
| [Bearing Towers](/assets/guide/rail---bearing-towers.jpg) | 2 |
