jamesloper/lemontron/_bom/m3-shims.md

---
layout: bom
title: M3 Shims
qty: 10
orders: 1
total: 1.15
description: M3 x 5mm x 0.2mm
new: true
links:
  - vendor: AliExpress
    url: https://www.aliexpress.us/item/3256802114850018.html
    note: M3x5xThick 50pcs, 0.2mm thick
kofi: true
optional: false
category: Hardware
---

| Location | Quantity |
|---|---|
| [Upper Pullies](/assets/guide/midplate---right---upper-pulley.jpg) | 4 |
| [Bearing Towers](/assets/guide/rail---bearing-towers.jpg) | 6 |
