jamesloper/lemontron/_bom/hotend.md

---
layout: bom
title: Hotend
qty: 1
orders: 1
total: 75.99
description: 
new: false
links: 
  - vendor: KB3D
    url: https://kb-3d.com/store/positron/1553-ldo-90-hotend-kit-for-positron-v32-3d-printer-1725633746505.html
  - vendor: 3DJake
    url: https://www.3djake.com/ldo-motors/hotend-16
  - vendor: Fabreeko
    url: https://www.fabreeko.com/products/positron-v3-2-ldo-kit-90-degree-hot-end-kit
  - vendor: Levendigs
    url: https://levendigs.com/products/ldo-positron-90-hotend-kit
  - vendor: West3D
    url: https://west3d.com/products/positron-90-degree-hot-end
kofi: true
optional: false
category: Positron
---

90 Degree Hotend Kit for the Positron V3.2 3D Printer Kit. From the community trusted LDO Motors. Includes heater,
bimetallic heat break, and 0.4mm nozzle.

Before you get shocked by the price ($75), it’s in a its own class. It comes with a functional bimetal heat
break, has a killer design, and features an insane 75-watt heater. Plus, it’s from LDO.

That said, you can still use any tool head you want! If you have a JourneyMaker you can reuse that one.
