jamesloper/lemontron/_bom/drive-pulleys.md

---
layout: bom
title: Drive Pulleys
qty: 4
orders: 4
total: 4.16
description: 20T Bore 5mm
new: false
links:
  - vendor: AliExpress
    url: https://www.aliexpress.us/item/2251832727442477.html
    note: 20T Bore 5mm
kofi: true
optional: false
category: Hardware
---

A compact design that locates the grub screw inside of the teeth area, enabling this printer to be possible.

KB3D sales a Positron-specific pulley that separates the grub screw and teeth areas. These do not work with the Lemontron.
