jamesloper/lemontron/_bom/edge-connector.md

---
layout: bom
title: Edge Connector
qty: 1
orders: 1
total: 1.49
description: 2x3 (6 Pin)
new: false
links:
  - vendor: AliExpress
    url: https://www.aliexpress.us/item/2255801041975380.html
    note: 2x3 6 Pin, Straight Connector
  - vendor: LCSC
    url: https://www.lcsc.com/product-detail/Card-Edge-Connectors_WingTAT-ED06BGFBK_C5173287.html
    note: Better consistency and quality
kofi: true
optional: false
category: Electronics
---

The edge connector is a 2x3 6 pin, straight connector. It is used to electrically connect the edge of the heat bed to
the SKR PICO.

The LCSC one is used by Voxolite and LDO, but I've not had any issues with the AliExpress one. Parts other than these are known to be less wide
and require filing the PCB edge to fit.
