jamesloper/lemontron/_bom/insert.md

---
layout: bom
title: M3 Brass Insert
qty: 9
orders: 1
total: 3.14
description: 
new: true
links:
  - vendor: AliExpress
    url: https://www.aliexpress.us/item/3256805590685220.html
    note: M3 (OD 5mm)50pcs, Length 10mm
kofi: true
optional: false
category: Hardware
---

These brass inserts are extra long and go in straight. The Lemontron has the inserts going in from the rear for the
maximum strength.

2 hold on the top plates, 2 hold on the idler pulley, 2 hold on the z axis, 1 holds the XY belt tensioner.
