jamesloper/lemontron/_bom/MGN9C.md

---
layout: bom
title: MGN9C X-Axis Rail
qty: 1
orders: 1
total: 9.41
description: 250mm
new: false
modification: true
links:
  - vendor: AliExpress
    url: https://www.aliexpress.us/item/2255800077919268.html
    note: 250mm
kofi: true
optional: false
category: Hardware
---

The smallest rail in the BOM allows the tool head to travel left and right.

## Required Modification

Trim off one hole! Suggested to use a [Dremel](https://www.amazon.com/dp/B0D2D28FSV?&tag=lemontron-20) & cutoff wheel or
a hacksaw. The rail will wind up around 230mm.

{% include tips/rails.html %}
