jamesloper/lemontron/_bom/JST-SXH.md

---
layout: bom
title: JST SXH-001T-P0.6
qty: 100
total: 5.32
new: true
links:
  - vendor: Digikey
    url: https://www.digikey.com/en/products/detail/jst-sales-america-inc/SXH-001T-P0-6N/7041446
kofi: true
optional: false
category: Electronics
---

For Motors, Z-Probe, Sensor Wires, etc. Approximately 27 are used in the build.
