jamesloper/lemontron/_bom/spring.md

---
layout: bom
title: Spring
qty: 2
orders: 1
total: 1.37
description: 6x3x10 Yellow
new: true
links:
  - vendor: AliExpress
    url: https://www.aliexpress.us/item/3256806731381312.html
    note: 6x3x10, Yellow, 5pcs
  - vendor: Amazon
    url: https://www.amazon.com/dp/B0C33CBKFY?&tag=lemontron-20
kofi: true
optional: false
category: Hardware
---

Boing! Used in the extruder!
