jamesloper/lemontron/_bom/stiffeners.md

---
layout: bom
title: Stiffeners
qty: 4
orders: 2
total: 6.96
description: 
new: true
links:
  - vendor: AliExpress
    url: https://www.aliexpress.us/item/2251832837611476.html
kofi: true
optional: true
category: Hardware
---

You can insert two **M4 45mm** and two **M5 80mm** screws to stiffen the frame. These aren't required but they help chassis rigidity!
