jamesloper/lemontron/_bom/thermistor.md

---
layout: bom
title: Thermistor
description: NTC 3950
qty: 1
orders: 1
total: 0.82
new: false
links:
  - vendor: AliExpress
    url: https://www.aliexpress.us/item/2251832640624478.html
    note: 1pc with DuPont
kofi: true
optional: false
category: Electronics
---

We do not actually need the thermistor at all but it's a cheap way to get some good wire for the two fans in the tool
head.
