jamesloper/lemontron/_bom/wire-sleeve.md

---
layout: bom
title: Wire Sleeve
qty: 1
orders: 1
total: 1.89
description: 4mm
new: true
links:
- vendor: AliExpress
  url: https://www.aliexpress.us/item/3256804114652291.html
  note: 4mm
kofi: true
optional: false
category: Electronics
---
