jamesloper/lemontron/_bom/fan5015.md

---
layout: bom
title: 5015 Fan
qty: 1
orders: 1
total: 3.42
new: false
links:
  - vendor: AliExpress
    url: https://www.aliexpress.us/item/3256806807237268.html
    note: 24V
  - vendor: West3D
    url: "https://west3d.com/products/berserker-vindr-ulta-performance-5015-blower-fan-24v-5015b-24v-a-50x15mm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"
    note: PWM
modification: true
kofi: true
optional: false
category: Electronics
---

A 5015 fan is used as a part cooling fan. The designation 5015 refers to the fan’s overall dimensions; 50mm wide and
15mm thick. It's a blower fan, meaning it directs air perpendicular to the intake. Different from an axial fan, which
pushes air straight through the fan. The blower design allows the 5015 fan to provide high static pressure, making it
effective at pushing air through confined spaces or over specific components, such as the hot end in the Lemontron.

Importantly, West3D sales a much faster and stronger version of the 5015 fan, the _Berserker Vindr Ultra-Performance
5015 Blower Fan 24V 5015B-24V-A 50x15mm_. If this will ship to your country, it's strongly recommended!

## Required Modifications

<ol class="steps">
    {% include step.html
    title = "Clip off the tabs"
    image = "fan---modify.jpg"
    content = "Delete the two mounting tabs and the wire clip by sanding them down flush with the fan body." %}
</ol>

## Technical Drawing

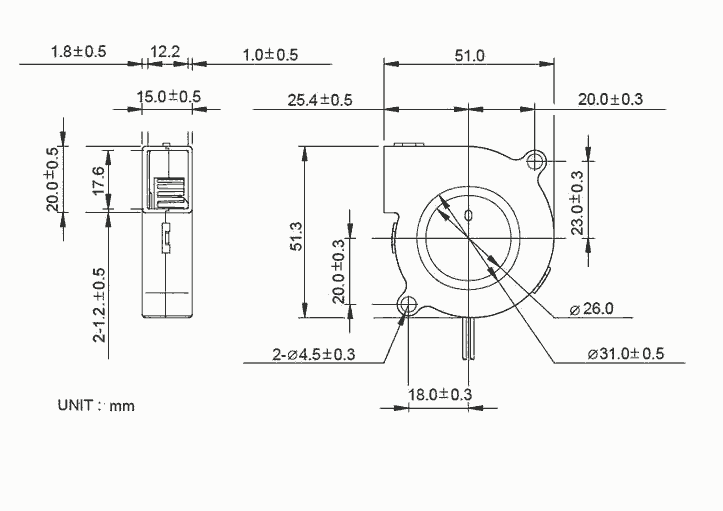
[picture p51: assets/content/5015-fan-technical.png]
