jamesloper/lemontron/_bom/F623RS.md

---
layout: bom
title: Big Bearings
qty: 10
orders: 1
total: 5.75
description: F623RS
new: true
links:
  - vendor: AliExpress
    url: https://www.aliexpress.us/item/2255801040808949.html
  - vendor: Amazon
    url: https://www.amazon.com/gp/product/B08ZS8SKMK/?tag=lemontron-20
kofi: true
optional: false
category: Hardware
---

F623RS bearings are used to route belts, 4 on the Midplate, 2 on the Tensioner, 2 on the Bearing Tower, and 2 on the
Z-Idler.

Used in conjunction with the [M3 Washers](/lemontron/bom/m3-washers/) on the bearing tower and on the Midplate.

| Dimension | Measurement |
|---|---|
| Inner Diameter  | 3 mm |
| Outer Diameter  | 10 mm | 
| Width | 4 mm |
| Flange Width | 1 mm |
| Flange Diameter | 11.5 mm |
