jamesloper/lemontron/_bom/small-bearing.md

---
layout: bom
title: Small Bearing
qty: 3
orders: 1
total: 2.32
description: 683ZZ
new: true
links:
  - vendor: AliExpress
    url: https://www.aliexpress.us/item/3256806541874652.html
    note: 683ZZ
kofi: true
optional: false
category: Hardware
---

A single 683ZZ bearing is used in the Lemonstruder. It exerts pressure on the filament to help the extruder drive gear
to sufficiently grip the filament. Dimensions are 3x7x3.

This bearing is also used in the bearing tower to guide the lower belt path.
