jamesloper/lemontron/_bom/ac-socket.md

---
layout: bom
title: AC Socket
qty: 1
orders: 1
total: 1.30
description: IEC320 C7
new: true
links:
  - vendor: AliExpress
    url: https://www.aliexpress.us/item/2251832621937815.html
kofi: true
optional: false
category: Electronics
---

Also known as a "Figure 8" socket, it is commonly found in laptop power supplies.
