jamesloper/lemontron/_bom/belt.md

---
layout: bom
title: Belt
qty: 1
orders: 1
total: 3.49
description: GT2 3mm
new: false
links:
  - vendor: KB3D
    url: https://kb-3d.com/store/positron/1558-ldo-2gt-belt-3mm-175-meters-for-positron-v32-3d-printer-1725634929631.html
    note: 1.75m
  - vendor: Voxolite
    url: https://voxolite.myshopify.com/products/gt2-timing-belt-3mm-width
    note: 1.9m
  - vendor: AliExpress
    url: https://www.aliexpress.us/item/2251832594573112.html
    note: 2m
kofi: true
optional: false
category: Hardware
---

GT2 refers to the type of tooth profile on the belt. GT2 belts have a rounded tooth profile. This type of profile
minimizes backlash (the slight movement in a system when the direction is reversed). The 3mm width is uncommon, which is
why you'll typically see these 3mm belts from small manufacturers.

The 1.9m length is a little more than needed.

## Technical Drawing

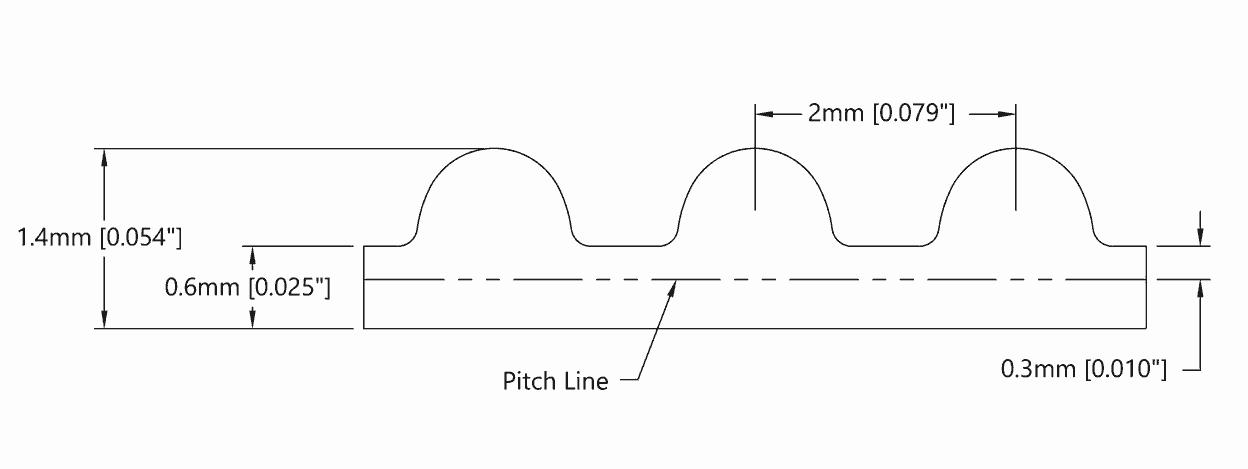
[picture p52: assets/content/belt-diagram.png]
Belt Diagram
