jamesloper/lemontron/_bom/extruder-drive-gear.md

---
layout: bom
title: Extruder Drive Gear
qty: 1
orders: 1
total: 2.07
new: true
links:
  - vendor: AliExpress
    url: https://www.aliexpress.us/item/2251832783805221.html
    note: 5mm bore, 7mm OD, 1.5mm pitch
kofi: true
optional: false
category: Hardware
modification: true
---

This is a generic BondTech style extruder drive gear, the primary component of the Lemonstruder. It is a 5mm bore gear
with a 7mm outer diameter. It is made of stainless steel and has a 1.5mm pitch.

## Required Modifications

Shorten the extruder gear by cutting off the gears on the bottom, not too high - retain use of the grub screw.
