jamesloper/lemontron/_bom/F683.md

---
layout: bom
title: Small Flanged Bearing
description: F683
qty: 6
orders: 1
total: 3.23
new: false
links:
  - vendor: AliExpress
    url: https://www.aliexpress.us/item/2251832782776530.html
    note: F683 3x7x2.5 open
kofi: true
optional: false
category: Hardware
---

This is used in the bearing tower, and as idlers on the midplate.

### Dimensions

| **Dimension** | **Measurement** |
|---|---|
| Inner Diameter  | 3 mm |
| Outer Diameter  | 7 mm |
| Width | 2.5 mm |
| Flange Diameter | 8 mm |
