jamesloper/lemontron/_bom/fan3010.md

---
layout: bom
title: 3010 Fan
qty: 1
orders: 1
total: 1.93
description: 
new: false
modification: true
links: 
  - vendor: AliExpress
    url: https://www.aliexpress.us/item/3256802382278079.html
    note: "24V HX2.54 2pin"
  - vendor: KB3D
    url: "https://kb-3d.com/store/fans/3-3010-ball-bearing-blower-fan-24v.html"
kofi: true
optional: false
category: Electronics
---

The 3010 fan in the Lemontron sits in the tool head and is responsible for cooling the aluminum heat break radiator.

## Required Modification

Cut off the top left corner, the one next to the wire, so that the fan fits in the tool head.
