jamesloper/lemontron/_bom/JST-SVH.md

---
layout: bom
title: JST SVH-21T-P1.1
qty: 4
orders: 1
total: 6.50
description: PSU Connector Terminals
new: true
links:
  - vendor: Digikey
    url: https://www.digikey.com/en/products/detail/jst-sales-america-inc/SVH-21T-P1-1/527368
  - vendor: AliExpress
    url: https://www.aliexpress.com/item/3256807500115364.html
kofi: true
optional: true
category: Electronics
---

Used on the connectors that plug into the PSU. 2 for the AC Input, 2 for the 24V DC Output.
