jamesloper/lemontron/_bom/JST-VHR-3N.md

---
layout: bom
title: JST VHR-3N
qty: 1
orders: 1
total: 1.00
description: PSU Connector Housing (AC Input)
new: true
links:
  - vendor: Digikey
    url: https://www.digikey.com/en/products/detail/jst-sales-america-inc/VHR-3N/608625
kofi: true
optional: true
category: Electronics
---
1 is used on the AC Input connector that plugs into the PSU.
