jamesloper/lemontron/_bom/JST-VHR-6N.md

---
layout: bom
title: JST VHR-6N
qty: 1
orders: 1
total: 1.00
description: PSU Connector Housing (24V DC)
new: true
links:
  - vendor: Digikey
    url: https://www.digikey.com/en/products/detail/jst-sales-america-inc/VHR-6N/608628
kofi: true
optional: true
category: Electronics
---
1 is used on the 24V DC Output connector that plugs into the PSU.
