jamesloper/lemontron/_bom/JST-XHP-2.md

---
layout: bom
title: JST XHP-2
qty: 4
orders: 10
total: 0.80
description: For Z-Probe, Temp Sensor & Fans
new: true
links:
  - vendor: Digikey
    url: https://www.digikey.com/en/products/detail/jst-sales-america-inc/XHP-2/555485
kofi: true
optional: false
category: Electronics
---

Used for the Z-Probe (On the black & white wire), Temp Sensor and Fans.
