jamesloper/lemontron/_bom/JST-XHP-3.md

---
layout: bom
title: JST XHP-3
qty: 1
orders: 1
total: 0.14
description: For Z-Probe
new: true
links:
  - vendor: Digikey
    url: https://www.digikey.com/en/products/detail/jst-sales-america-inc/XHP-3/1651017
kofi: true
optional: false
category: Electronics
---

Used to connect the Z-Probe to the mainboard. 1 is used.
