jamesloper/lemontron/_bom/JST-XHP-4.md

---
layout: bom
title: JST XHP-4
qty: 4
orders: 10
total: 0.81
description: For Motors
new: true
links:
  - vendor: Digikey
    url: https://www.digikey.com/en/products/detail/jst-sales-america-inc/XHP-4/683353
kofi: true
optional: false
category: Electronics
---
4 are used to connect the motors to the mainboard.
