jamesloper/lemontron/_bom/lead-screw.md

---
layout: bom
title: Lead Screw
qty: 1
orders: 1
total: 8.33
description: Pitch 1mm Lead 4mm, 250mm, includes nut
new: false
links:
  - vendor: AliExpress
    url: https://www.aliexpress.us/item/3256804397445121.html
modification: true
kofi: true
optional: false
category: Hardware
---

This compact and inexpensive lead screw is used to move the Z-axis up and down. It is 250mm long with a 4mm lead and 1mm
pitch. It comes with a matching nut.

## Required Modifications

1. Cut the lead screw flush with the Z Axis Assembly.
2. Countersink the 3 holes on the bottom of the nut.
