jamesloper/lemontron/_bom/m3-washers.md

---
layout: bom
title: M3 Big Washers
qty: 12
orders: 1
total: 1.39
description: M3 x 12mm x 1mm
new: true
links:
  - vendor: AliExpress
    url: https://www.aliexpress.us/item/3256803873360290.html
kofi: true
optional: false
category: Hardware
---

4 for the Bed Holder, 6 for the Mid Plate Idlers. 2 for the Belt Tensioner
