jamesloper/lemontron/_bom/m5-shims.md

---
layout: bom
title: M5 Shims
qty: 2
orders: 1
total: 0.99
description: M5 x 8mm x 0.2mm
new: true
links:
  - vendor: AliExpress
    url: https://www.aliexpress.us/item/3256801859874107.html
    note: M5x8xThick, 0.2mm thick
kofi: true
optional: false
category: Hardware
---

The OD can also be 9mm and still work. We only need two of these for the lead screw drive pulley.
