jamesloper/lemontron/_bom/MGN12C.md

---
layout: bom
title: MGN12C Y-Axis Rail
qty: 1
orders: 1
total: 12.19
description: 250mm
new: false
links:
  - vendor: AliExpress
    url: https://www.aliexpress.us/item/2255800077919268.html
    note: 250mm
kofi: true
optional: false
category: Hardware
---

This is the medium sized rail in the BOM, which allows the tool head to move forward and backward.

{% include tips/rails.html %}
