jamesloper/lemontron/_bom/MGW9C.md

---
layout: bom
title: MGW9C Z-Axis Rail
qty: 1
orders: 1
total: 21.00
description: 250mm
new: false
links:
  - vendor: AliExpress
    url: https://www.aliexpress.us/item/2255801011964264.html
    note: 250mm
kofi: true
optional: false
category: Hardware
---

{% include tips/rails.html %}
