jamesloper/lemontron/_bom/MR115.md

---
layout: bom
title: MR115 Bearing
qty: 3
orders: 1
total: 0.99
description: Lead Screw Bearings
new: false
links:
  - vendor: AliExpress
    url: https://www.aliexpress.us/item/3256806950683603.html
    note: MR115
kofi: true
optional: false
category: Hardware
---

These bearings constrain the lead screw.

On the lemontron Z Axis, the bottom seats two bearings, one on each side of the drive pulley, flanked by shims.
The top seats one bearing on the top of the lead screw.

| Dimension | Measurement |
|---|---|
| Inner Diameter | 5 mm |
| Outer Diameter | 11 mm | 
| Width | 4 mm |
