jamesloper/lemontron/_bom/nuts.md

---
layout: bom
title: Nuts
description: M3
qty: 3
orders: 1
total: 1.40
new: false
links:
  - vendor: AliExpress
    url: https://www.aliexpress.us/item/3256801453044560.html
kofi: true
optional: false
category: Hardware
---

These nuts are pressed into the rails to hold the screws in from behind.
