jamesloper/lemontron/_bom/raspberry-pi.md

---
layout: bom
title: Rasberry Pi Zero 2 W
qty: 1
orders: 1
total: 20.00
description: Computer
new: false
links:
  - vendor: Amazon
    url: https://www.amazon.com/dp/B09LH5SBPS?&tag=lemontron-20
  - vendor: AliExpress
    url: https://www.aliexpress.us/item/3256805294994013.html
kofi: true
optional: false
category: Electronics
---
