jamesloper/lemontron/_bom/wire.md

---
layout: bom
title: 18 AWG Silicone Wire
qty: 1
orders: 1
total: 1.22
description: 2m (2 Pin Black-Red)
new: false
links:
  - vendor: AliExpress
    url: https://www.aliexpress.us/item/3256804564602643.html
    note: 18AWG
kofi: true
optional: false
category: Electronics
---

18 AWG silicone wire is a medium-gauge, highly flexible, and heat-resistant wire with a diameter of approximately 1.02
mm (0.0403 inches). 18 AWG wire can safely carry up to 16 amps.
