jamesloper/lemontron/_bom/z-belt.md

---
layout: bom
title: Z-Axis Drive Belt
qty: 1
orders: 1
total: 0.99
description: 160mm
new: true
links:
  - vendor: AliExpress
    url: https://www.aliexpress.us/item/3256804498756709.html
    note: 160mm
kofi: true
optional: false
category: Hardware
---
