jamesloper/lemontron/_bom/MR117ZZ.md

---
layout: bom
title: MR117ZZ Bearing
qty: 1
orders: 1
total: 2.12
link: https://www.aliexpress.us/item/2255800705483445.html
description: MR117ZZ 7x11x3mm (5pcs)
new: No
---

A single MR117ZZ bearing is used in the Lemontron in the Lemonstruder tensioner arm. It exerts pressure on the filament to help the extruder drive gear to sufficiently grip the filament.
