jamesloper/lemontron/assets/bom/ac-socket.png

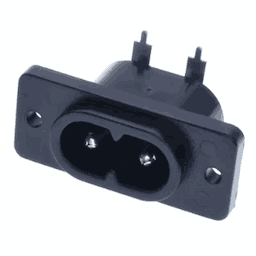
assets/bom/ac-socket.png
