jamesloper/lemontron/assets/bom/bed.png

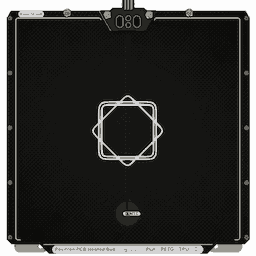
assets/bom/bed.png
