jamesloper/lemontron/assets/bom/belt.png

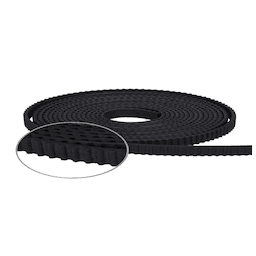
assets/bom/belt.png
