jamesloper/lemontron/assets/bom/bowden.png

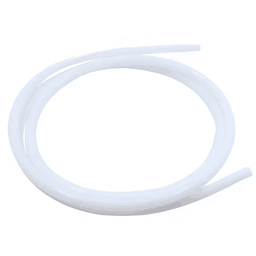
assets/bom/bowden.png
