jamesloper/lemontron/assets/bom/drive-pulleys.png

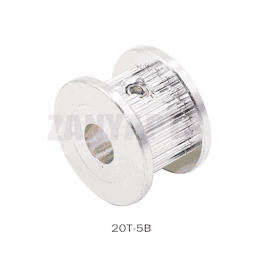
assets/bom/drive-pulleys.png
