jamesloper/lemontron/assets/bom/edge-connector.png

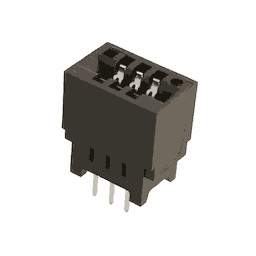
assets/bom/edge-connector.png
