jamesloper/lemontron/assets/bom/extruder-drive-gear.png

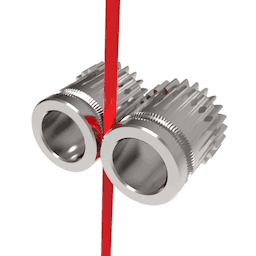
assets/bom/extruder-drive-gear.png
