jamesloper/lemontron/assets/bom/F623RS.png

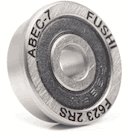
assets/bom/F623RS.png
