jamesloper/lemontron/assets/bom/F683.png

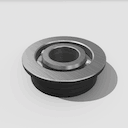
assets/bom/F683.png
