jamesloper/lemontron/assets/bom/fan3010.png

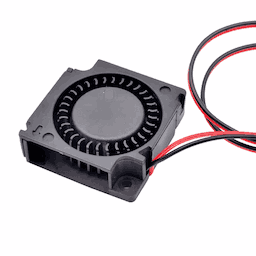
assets/bom/fan3010.png
