jamesloper/lemontron/assets/bom/fan5015.png

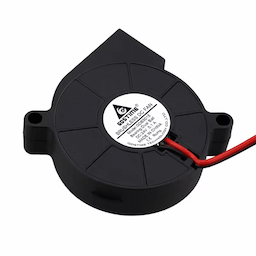
assets/bom/fan5015.png
