jamesloper/lemontron/assets/bom/hotend.png

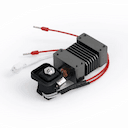
assets/bom/hotend.png
