jamesloper/lemontron/assets/bom/insert.png

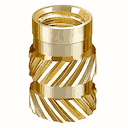
assets/bom/insert.png
