jamesloper/lemontron/assets/bom/JST-SVH.png

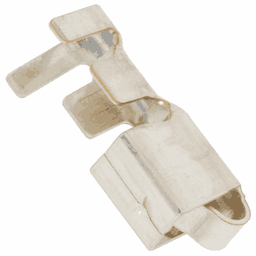
assets/bom/JST-SVH.png
