jamesloper/lemontron/assets/bom/JST-SXH.png

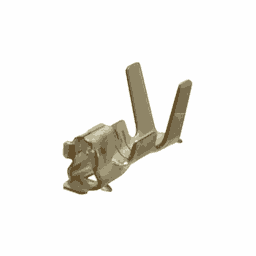
assets/bom/JST-SXH.png
