jamesloper/lemontron/assets/bom/JST-VHR-3N.png

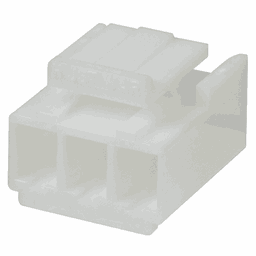
assets/bom/JST-VHR-3N.png
