jamesloper/lemontron/assets/bom/JST-VHR-6N.png

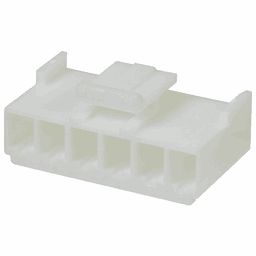
assets/bom/JST-VHR-6N.png
