jamesloper/lemontron/assets/bom/JST-XHP-2.png

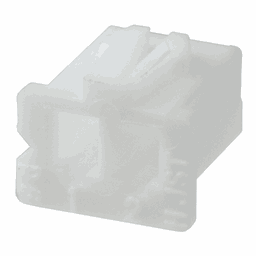
assets/bom/JST-XHP-2.png
