jamesloper/lemontron/assets/bom/JST-XHP-3.png

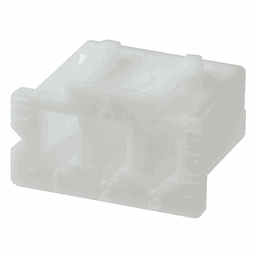
assets/bom/JST-XHP-3.png
