jamesloper/lemontron/assets/bom/JST-XHP-4.png

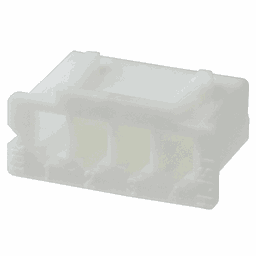
assets/bom/JST-XHP-4.png
