jamesloper/lemontron/assets/bom/lead-screw.png

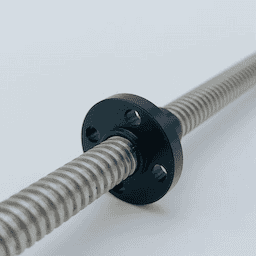
assets/bom/lead-screw.png
