jamesloper/lemontron/assets/bom/m3-medium-shims.png

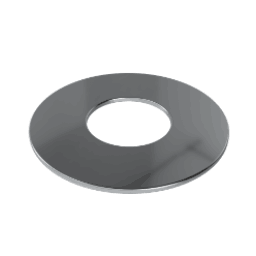
assets/bom/m3-medium-shims.png
