jamesloper/lemontron/assets/bom/m3-shims.png

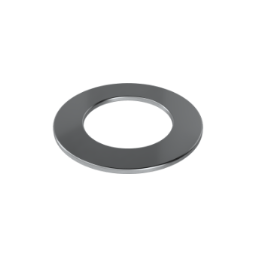
assets/bom/m3-shims.png
