jamesloper/lemontron/assets/bom/m3-washers.png

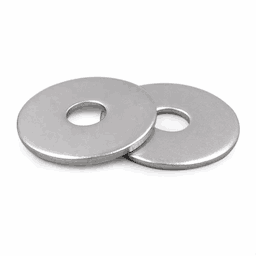
assets/bom/m3-washers.png
