jamesloper/lemontron/assets/bom/m5-shims.png

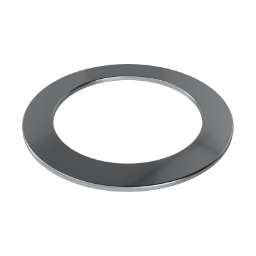
assets/bom/m5-shims.png
