jamesloper/lemontron/assets/bom/MGN9C.png

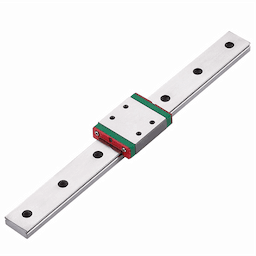
assets/bom/MGN9C.png
