jamesloper/lemontron/assets/bom/MR115.png

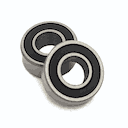
assets/bom/MR115.png
