jamesloper/lemontron/assets/bom/nuts.png

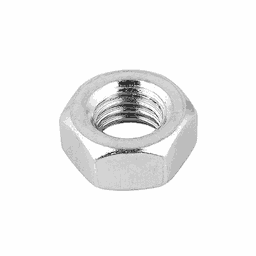
assets/bom/nuts.png
