jamesloper/lemontron/assets/bom/probe.png

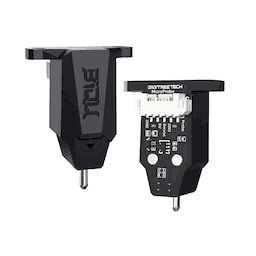
assets/bom/probe.png
