jamesloper/lemontron/assets/bom/psu.png

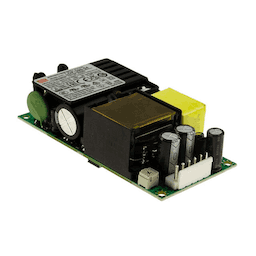
assets/bom/psu.png
