jamesloper/lemontron/assets/bom/raspberry-pi.png

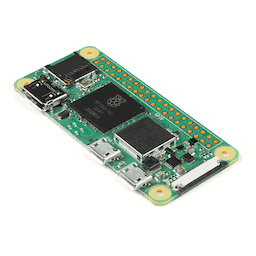
assets/bom/raspberry-pi.png
