jamesloper/lemontron/assets/bom/skr.png

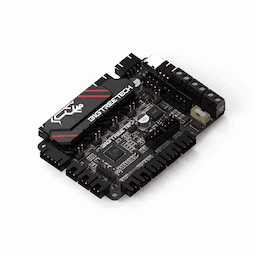
assets/bom/skr.png
