jamesloper/lemontron/assets/bom/small-bearing.png

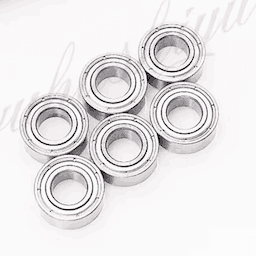
assets/bom/small-bearing.png
