jamesloper/lemontron/assets/bom/spring.png

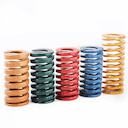
assets/bom/spring.png
