jamesloper/lemontron/assets/bom/stepper.png

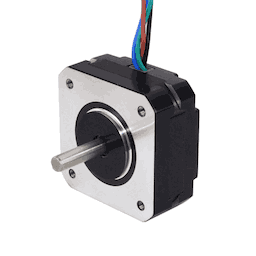
assets/bom/stepper.png
