jamesloper/lemontron/assets/bom/thermistor.png

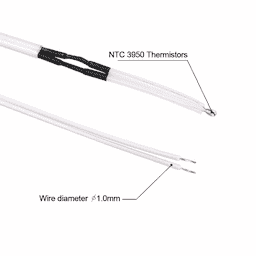
assets/bom/thermistor.png
