jamesloper/lemontron/assets/bom/timing-belt.png

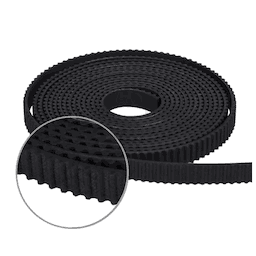
assets/bom/timing-belt.png
