jamesloper/lemontron/assets/bom/toolhead-pcb.png

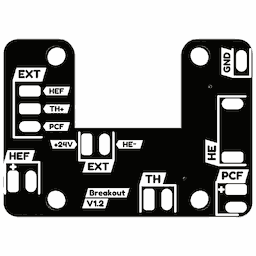
assets/bom/toolhead-pcb.png
