jamesloper/lemontron/assets/bom/wire-sleeve.png

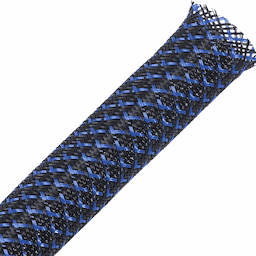
assets/bom/wire-sleeve.png
