jamesloper/lemontron/assets/bom/wire.png

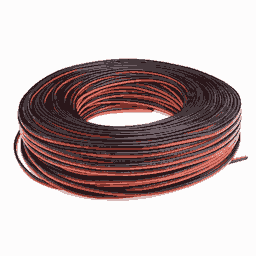
assets/bom/wire.png
