jamesloper/lemontron/assets/bom/z-belt.png

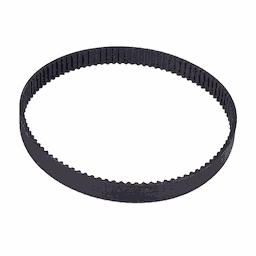
assets/bom/z-belt.png
