jamesloper/lemontron/assets/content/printed-parts.jpg

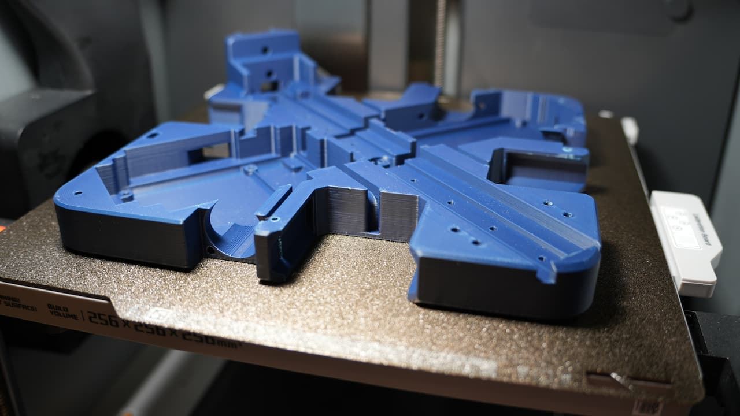
assets/content/printed-parts.jpg
