jamesloper/lemontron/assets/guide/intro---print-the-parts.jpg

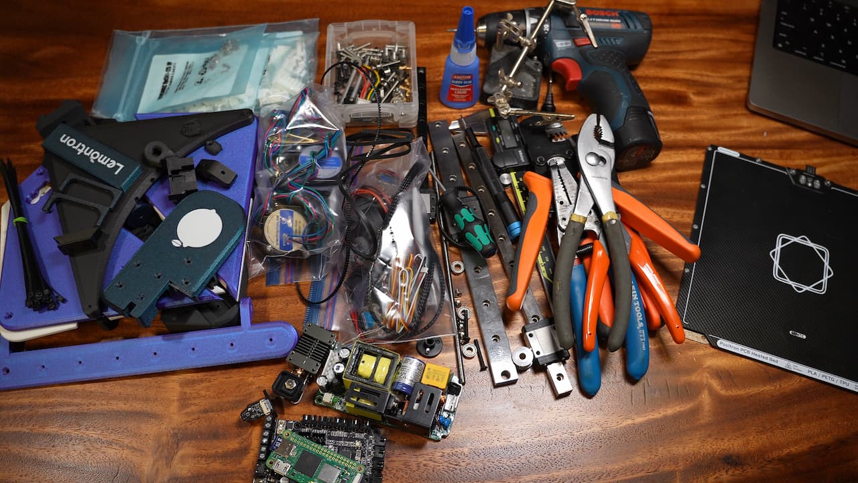
assets/guide/intro---print-the-parts.jpg
