jamesloper/lemontron/assets/guide/lemonstruder---parts.jpg

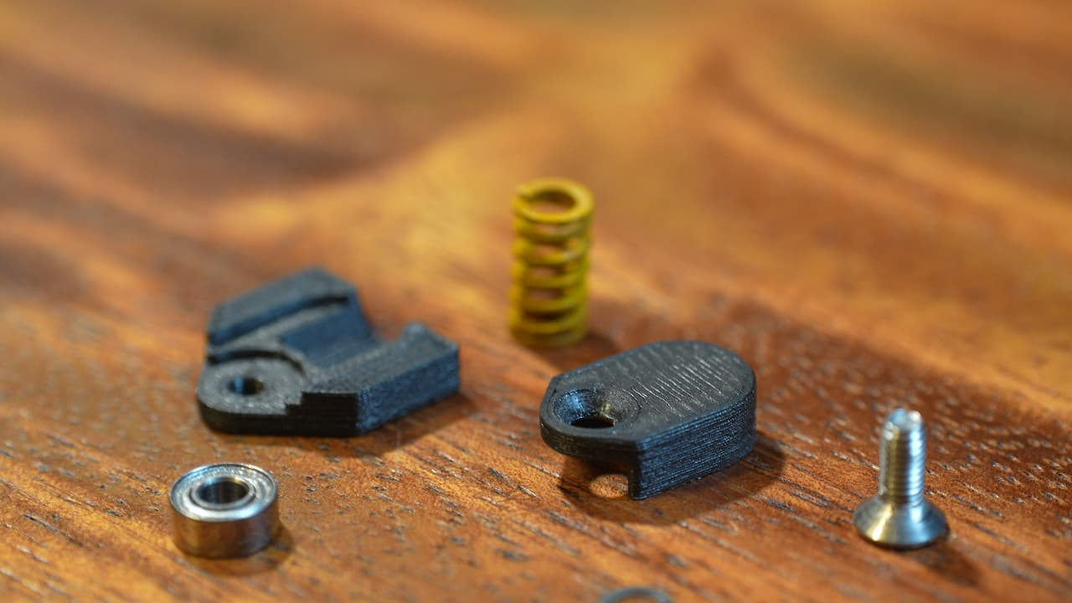
assets/guide/lemonstruder---parts.jpg
