jamesloper/lemontron/assets/guide/z-axis---gather-parts.jpg

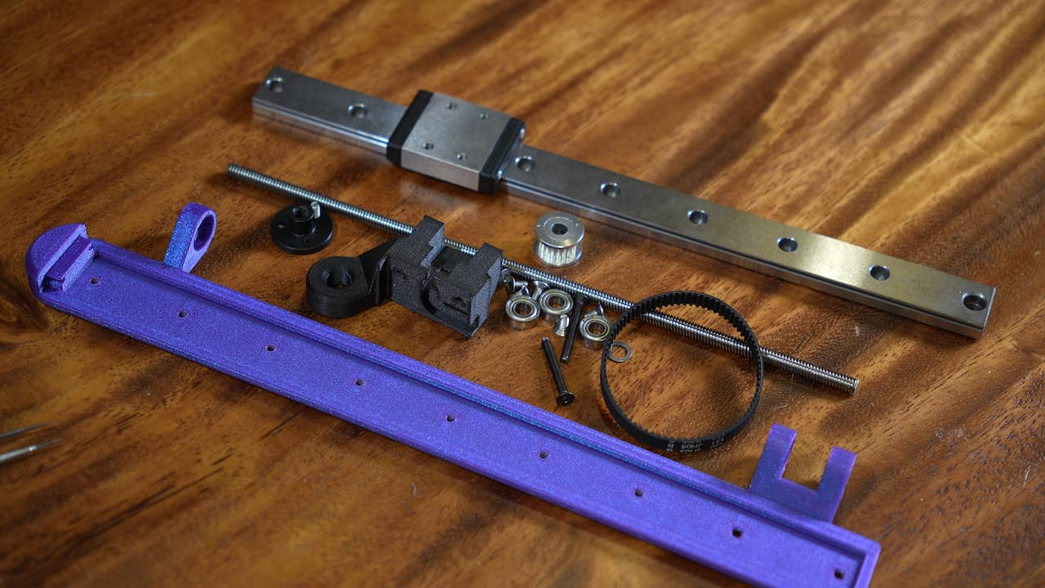
assets/guide/z-axis---gather-parts.jpg
