jamesloper/lemontron/assets/printed-parts/bed-holder.png

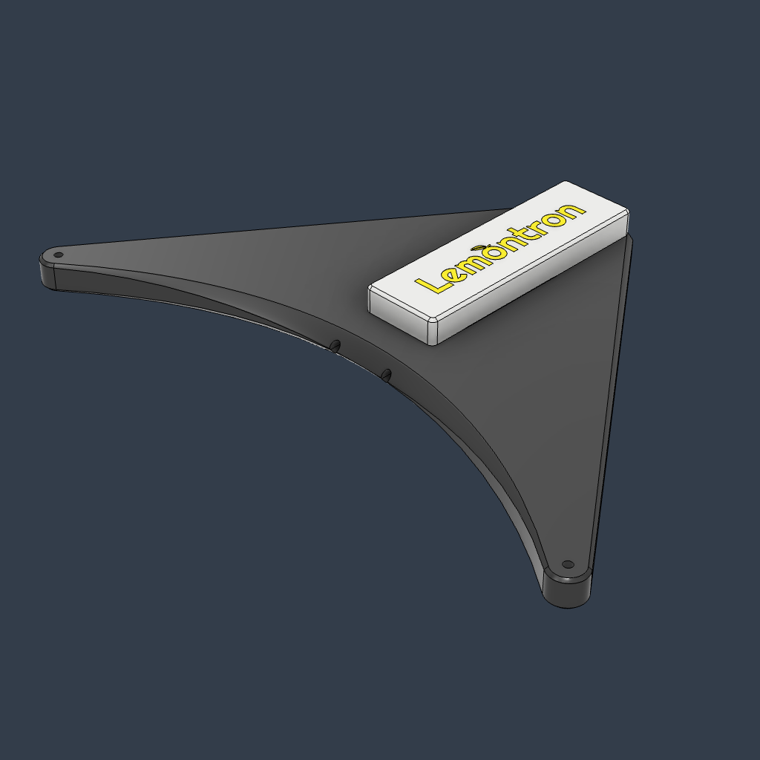
assets/printed-parts/bed-holder.png
