jamesloper/lemontron/assets/printed-parts/bracket.png

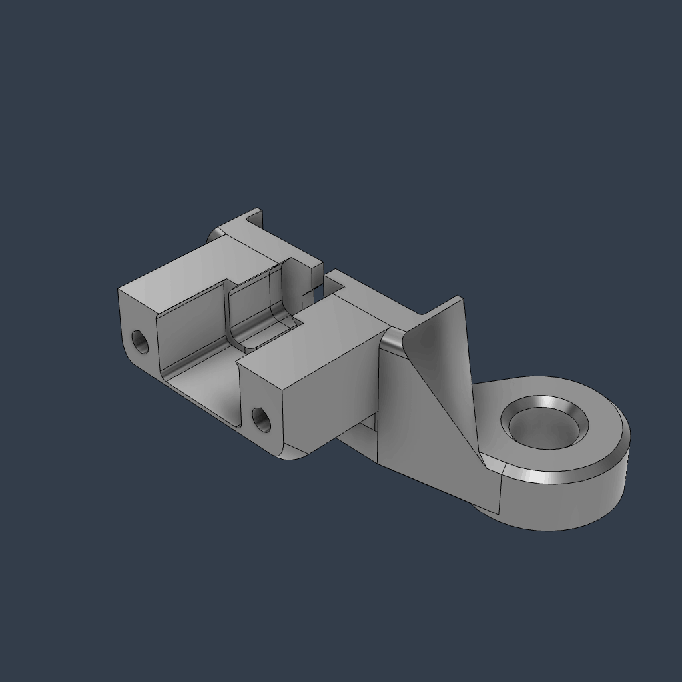
assets/printed-parts/bracket.png
