jamesloper/lemontron/assets/printed-parts/clip.png

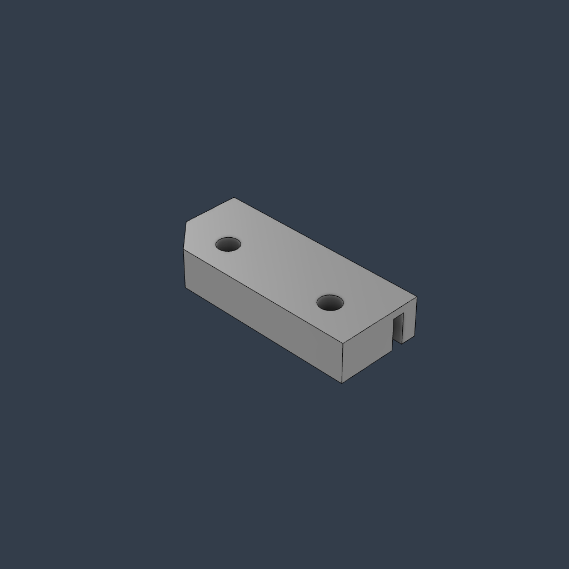
assets/printed-parts/clip.png
