jamesloper/lemontron/assets/printed-parts/lemonstruder.png

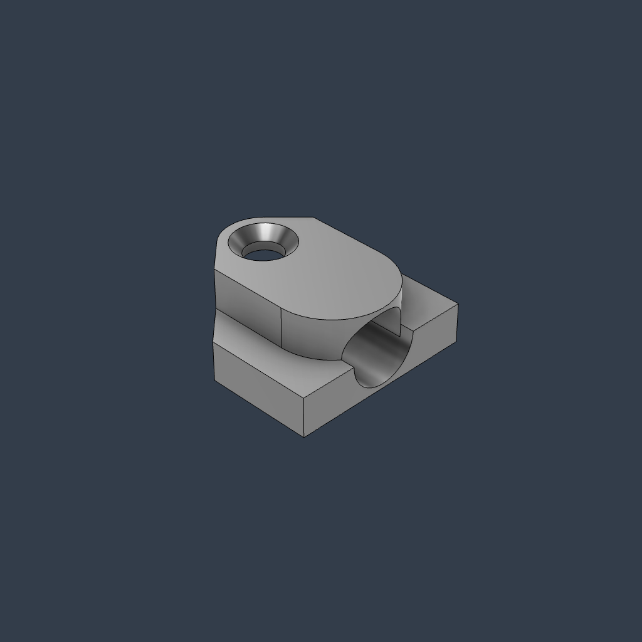
assets/printed-parts/lemonstruder.png
