jamesloper/lemontron/assets/printed-parts/mid-plates.png

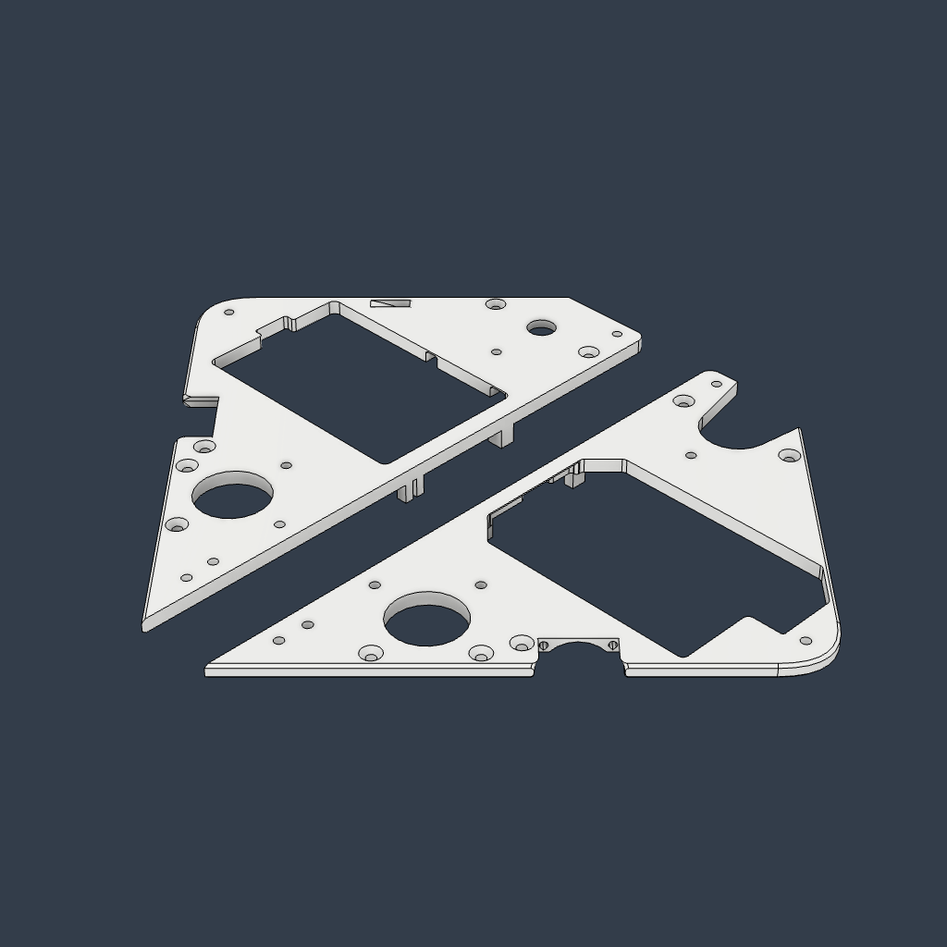
assets/printed-parts/mid-plates.png
