jamesloper/lemontron/assets/printed-parts/risers.png

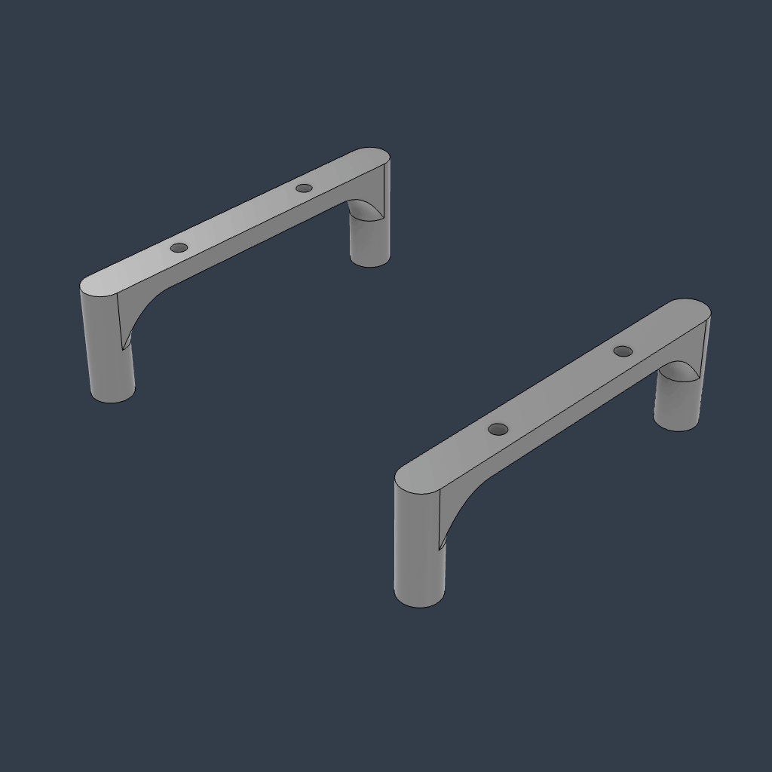
assets/printed-parts/risers.png
