jamesloper/lemontron/assets/printed-parts/spool-holder.png

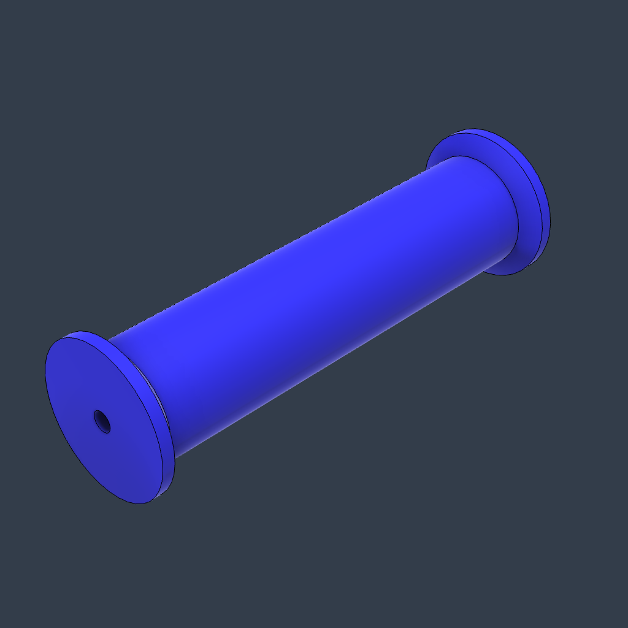
assets/printed-parts/spool-holder.png
