jamesloper/lemontron/assets/printed-parts/tensioner.png

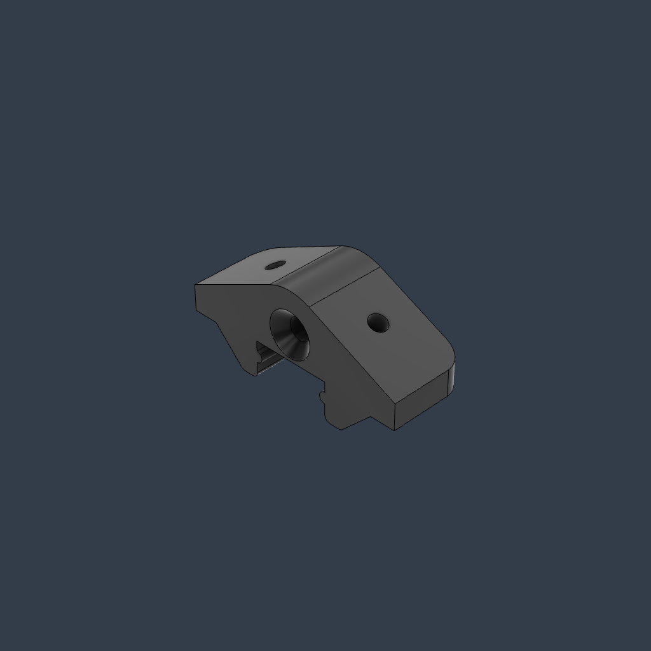
assets/printed-parts/tensioner.png
