jamesloper/lemontron/assets/printed-parts/tool.png

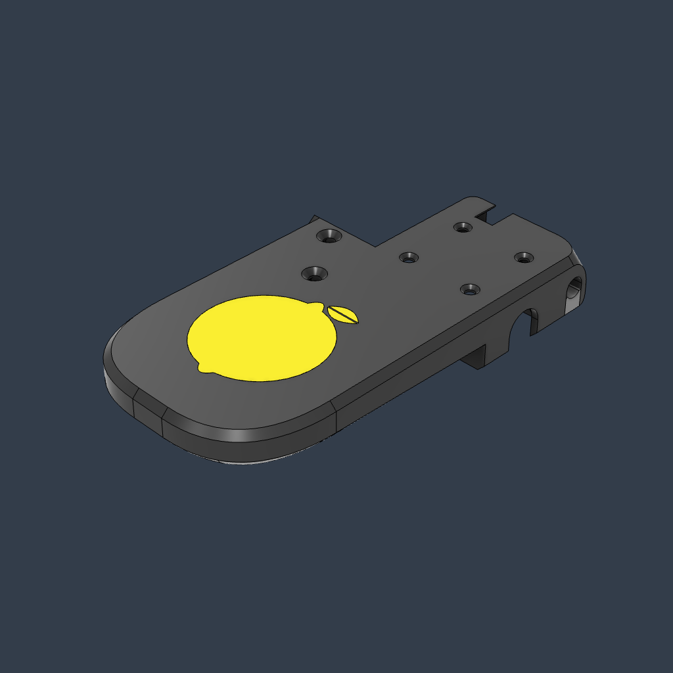
assets/printed-parts/tool.png
