jamesloper/lemontron/assets/printed-parts/top-plates.png

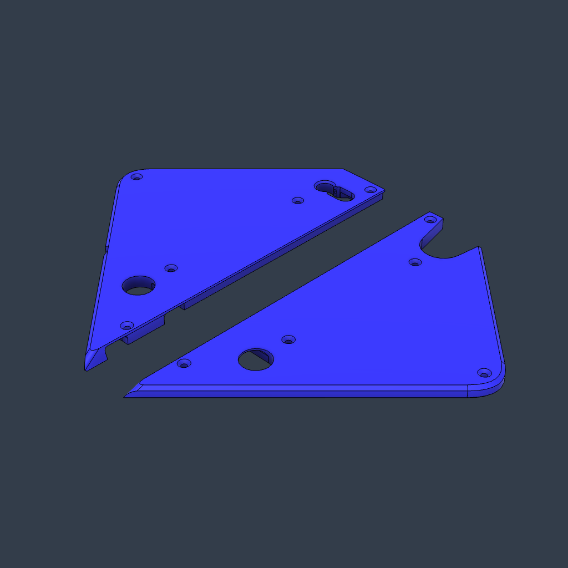
assets/printed-parts/top-plates.png
