jamesloper/lemontron/assets/printed-parts/z-axis.png

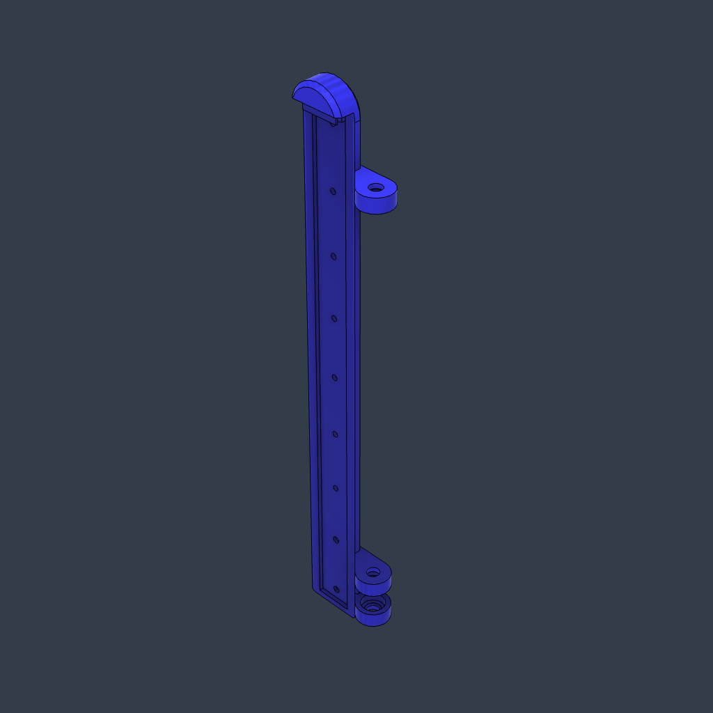
assets/printed-parts/z-axis.png
