jamesloper/lemontron/assets/printed-parts/z-tensioner.png

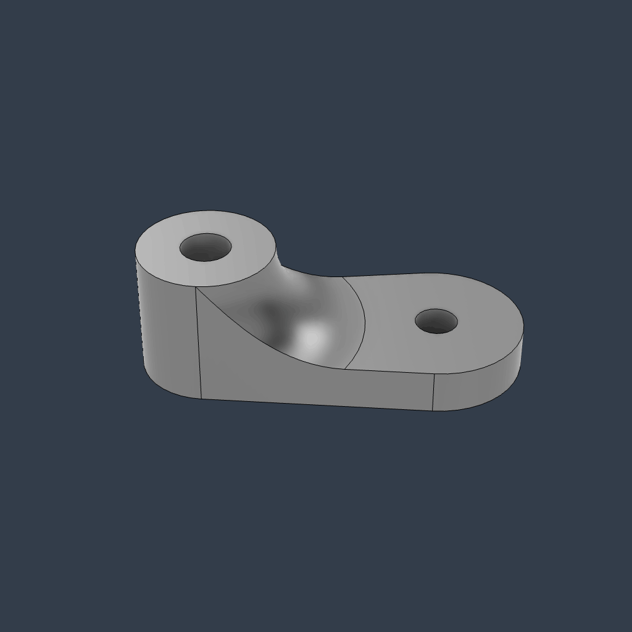
assets/printed-parts/z-tensioner.png
