jamesloper/lemontron/assets/downloads/stepper-cutting-guide.stl

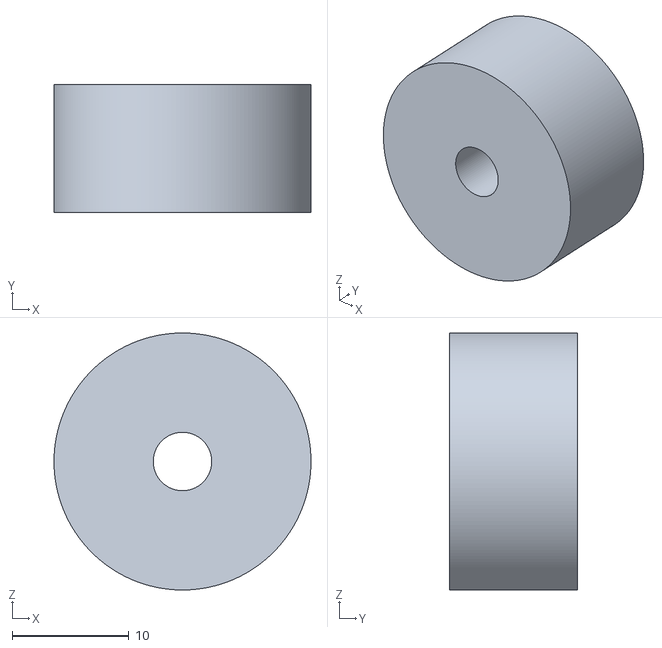
[picture p111: CAD file, 2024-10-21]
assets/downloads/stepper-cutting-guide.stl
22.0 x 11.0 x 22.0
