jamesloper/lemontron/assets/downloads/washer-dishing-tool.step

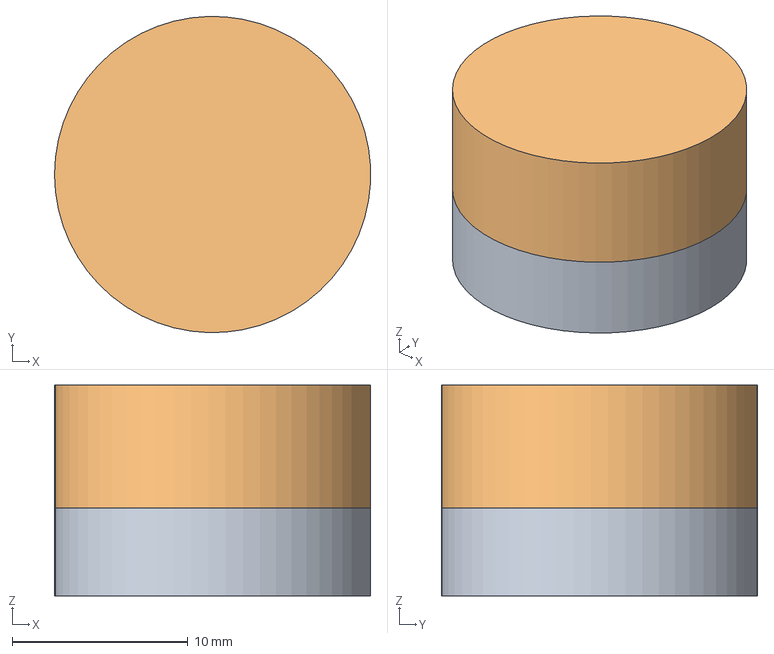
[picture p112: CAD file, 2024-04-03]
assets/downloads/washer-dishing-tool.step
18.0 x 18.0 x 12.0 mm
