jamesloper/lemontron/_layouts/guide.html

--- layout: default --- {% include breadcrumbs.html %}

# {{ page.title | escape }}

{% if page.date %} {%- assign date_format = site.minima.date_format | default: "%b %-d, %Y" -%} {{page.date | date: date_format}} {% endif %} history (https://github.com/jamesloper/lemontron/commits/main/{{page.path}})

{{content}}

{%- if site.disqus.shortname -%} {%- include disqus_comments.html -%} {%- endif -%}
