jamesloper/lemontron/assets/content/lemontron-printing-a-lemon.jpg

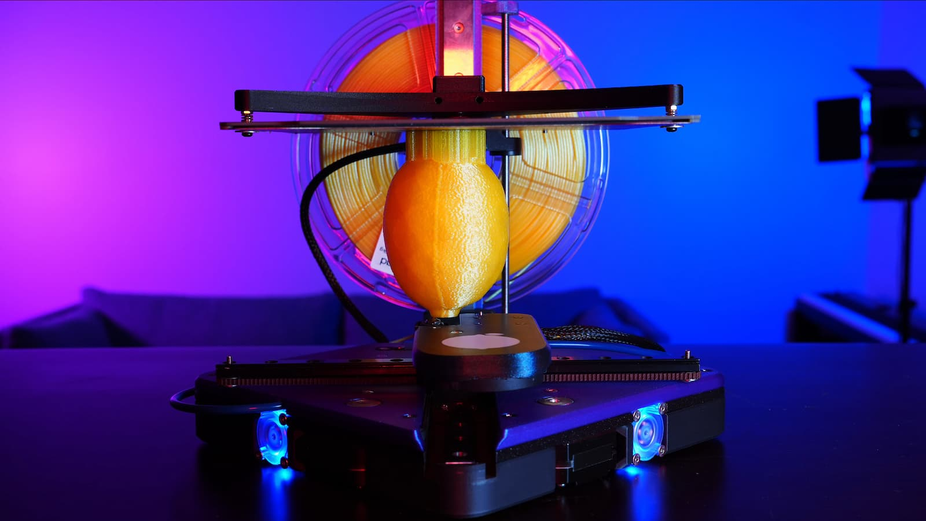
assets/content/lemontron-printing-a-lemon.jpg
