jamesloper/lemontron/assets/content/printables.png

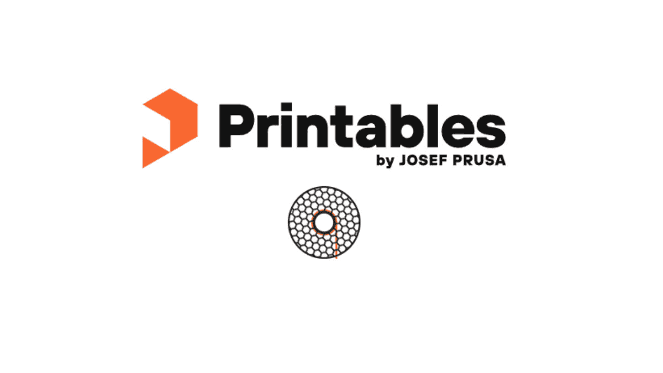
assets/content/printables.png
