jamesloper/lemontron/assets/content/upside-down-printing.jpg

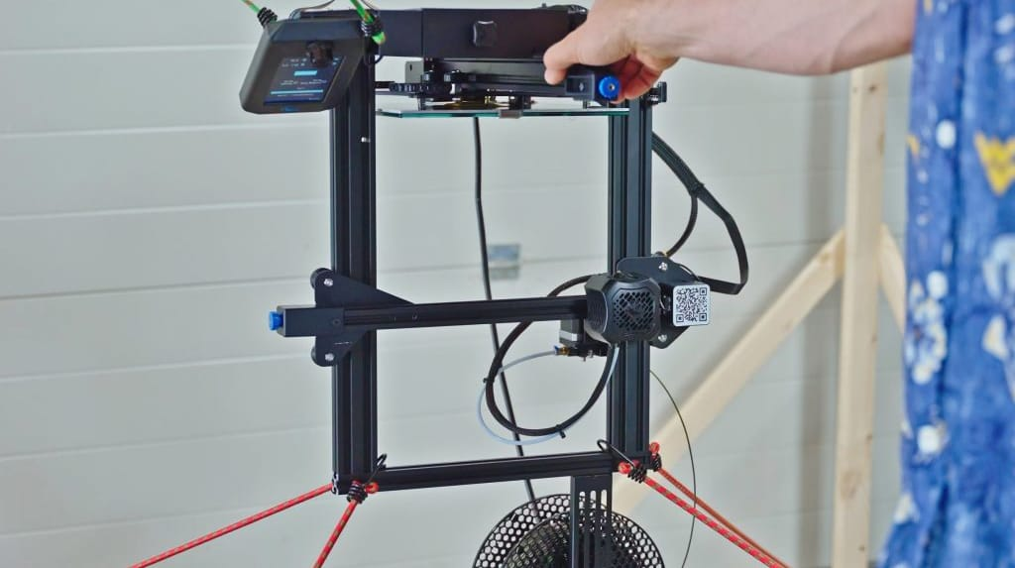
assets/content/upside-down-printing.jpg
