jamesloper/lemontron/assets/guide/bed-holder---attach-spine.jpg

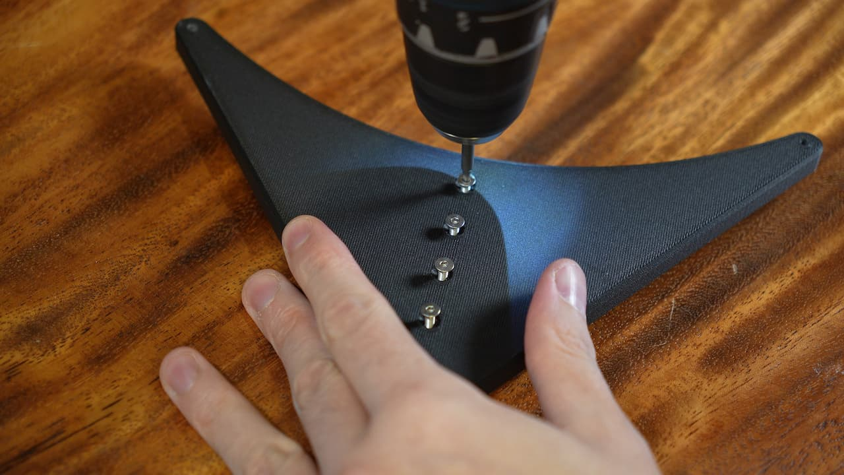
assets/guide/bed-holder---attach-spine.jpg
