jamesloper/lemontron/assets/guide/bed-holder---insert-screws.jpg

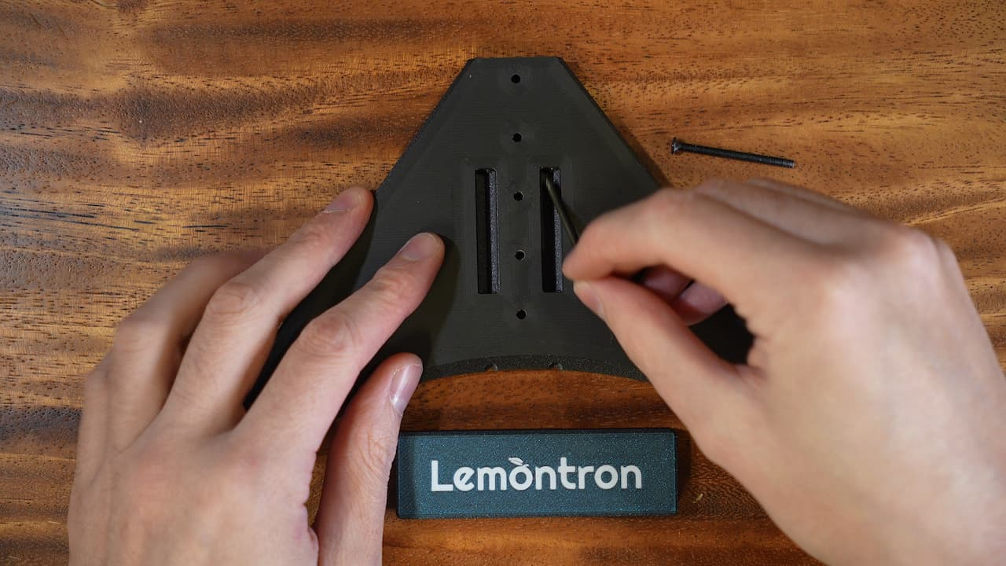
assets/guide/bed-holder---insert-screws.jpg
