jamesloper/lemontron/assets/guide/bed-holder---posts.jpg

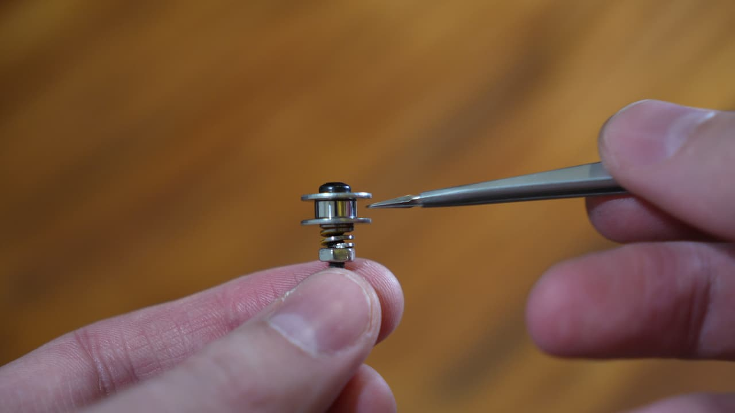
assets/guide/bed-holder---posts.jpg
