jamesloper/lemontron/assets/guide/bed-holder---scrape.jpg

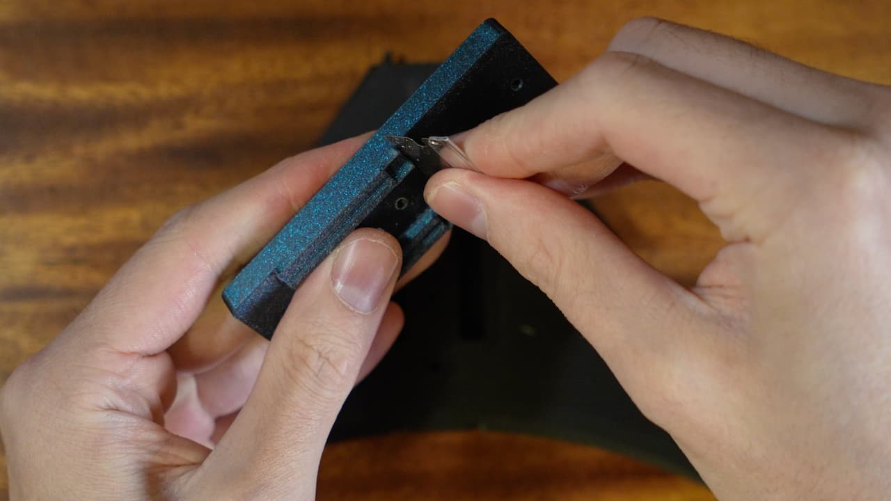
assets/guide/bed-holder---scrape.jpg
