jamesloper/lemontron/assets/guide/belt-route---lower-bearings.jpg

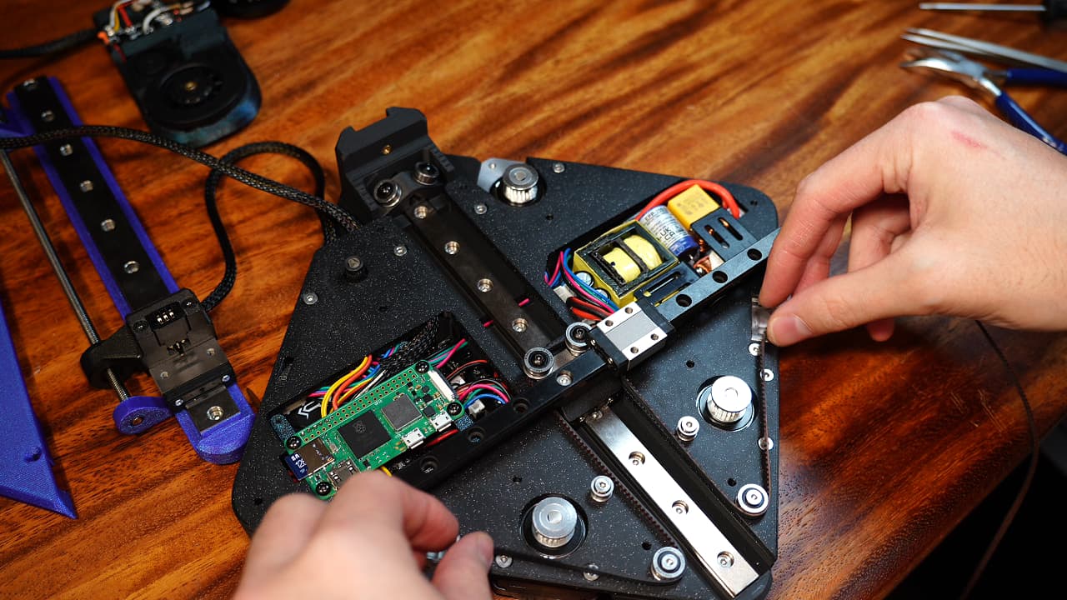
assets/guide/belt-route---lower-bearings.jpg
