jamesloper/lemontron/assets/guide/belt-route---lubrication.jpg

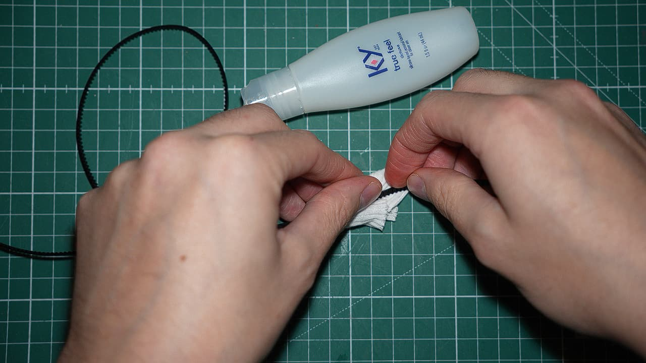
assets/guide/belt-route---lubrication.jpg
