jamesloper/lemontron/assets/guide/belt-route---tensioner.jpg

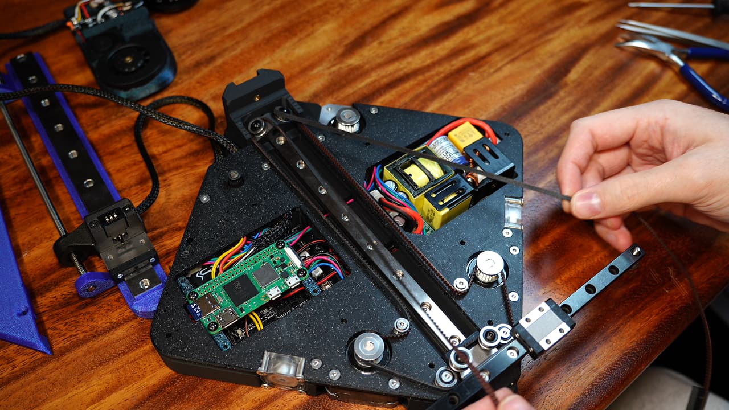
assets/guide/belt-route---tensioner.jpg
