jamesloper/lemontron/assets/guide/belt-route---tower---lower-bearings.jpg

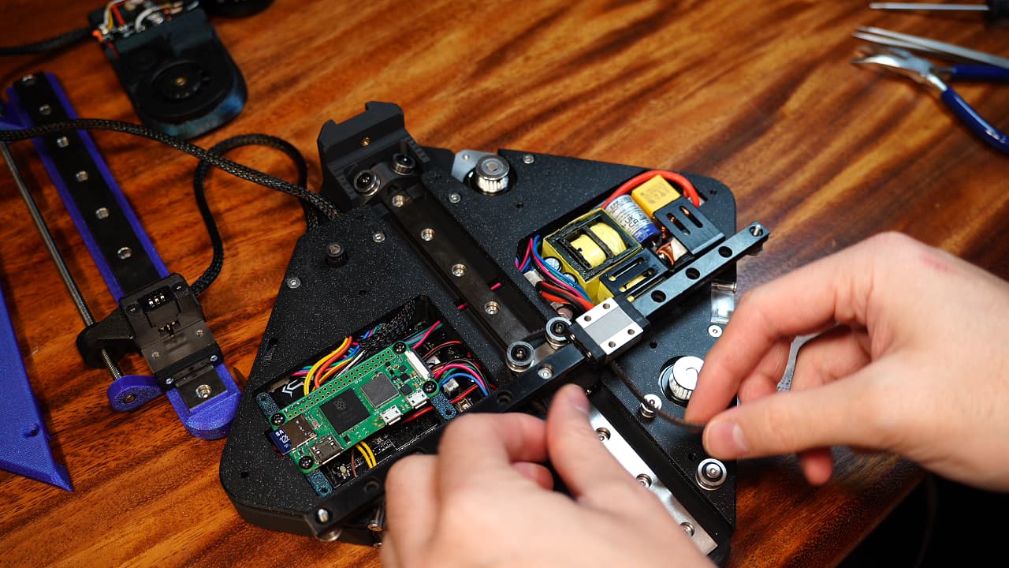
assets/guide/belt-route---tower---lower-bearings.jpg
