jamesloper/lemontron/assets/guide/belt-route---tower---upper-bearings.jpg

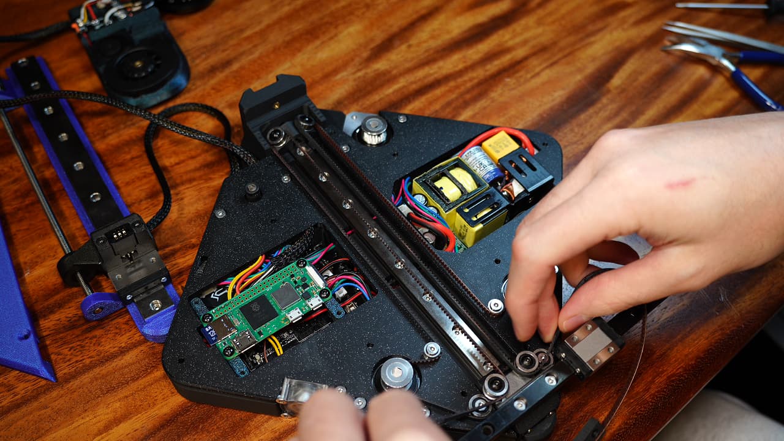
assets/guide/belt-route---tower---upper-bearings.jpg
