jamesloper/lemontron/assets/guide/belt-route---upper-bearings.jpg

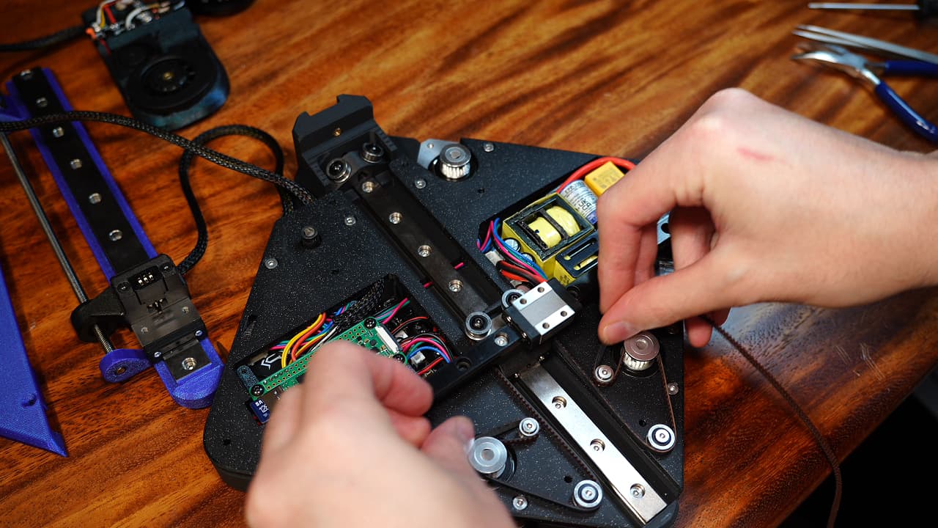
assets/guide/belt-route---upper-bearings.jpg
