jamesloper/lemontron/assets/guide/belt-route---x-rail.jpg

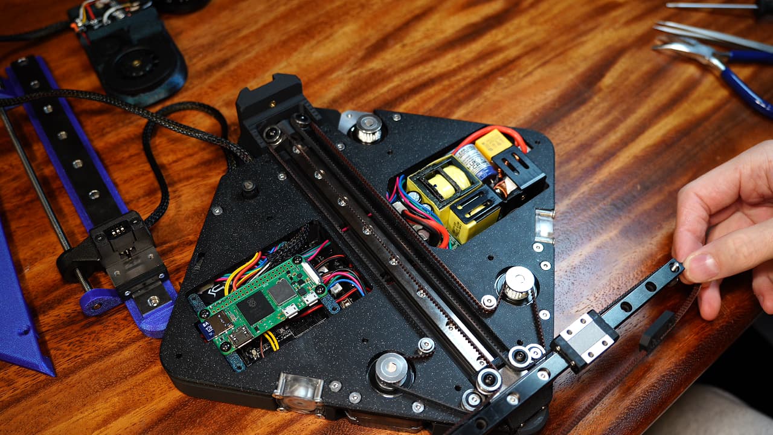
assets/guide/belt-route---x-rail.jpg
