jamesloper/lemontron/assets/guide/bowden---cut.jpg

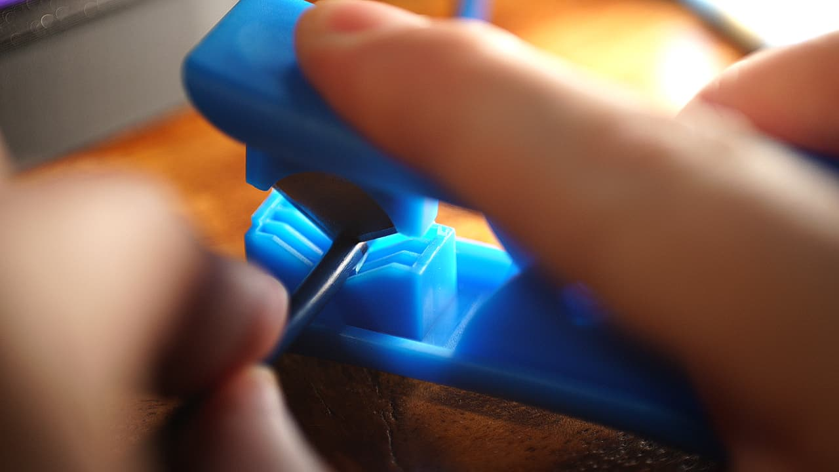
assets/guide/bowden---cut.jpg
