jamesloper/lemontron/assets/guide/bowden---glue.jpg

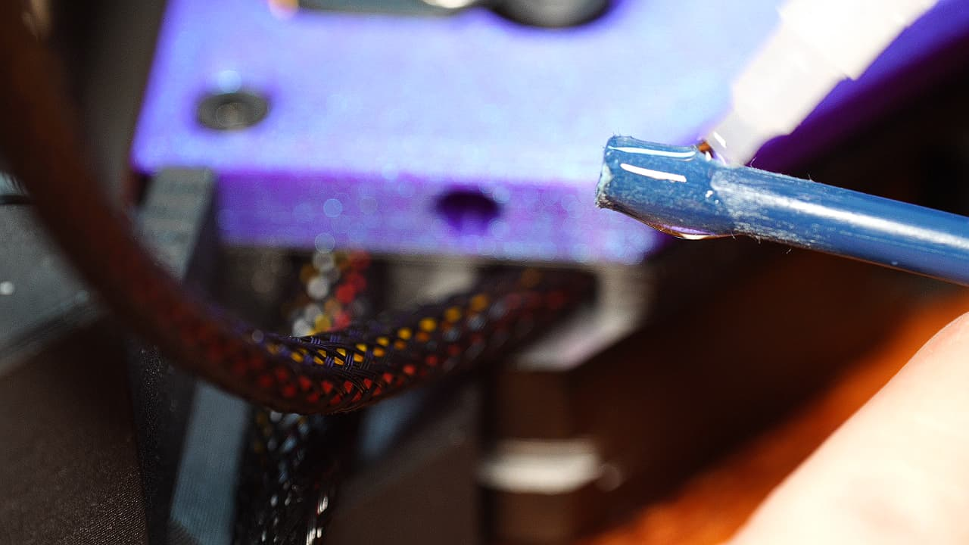
assets/guide/bowden---glue.jpg
