jamesloper/lemontron/assets/guide/bowden---insert-clip.jpg

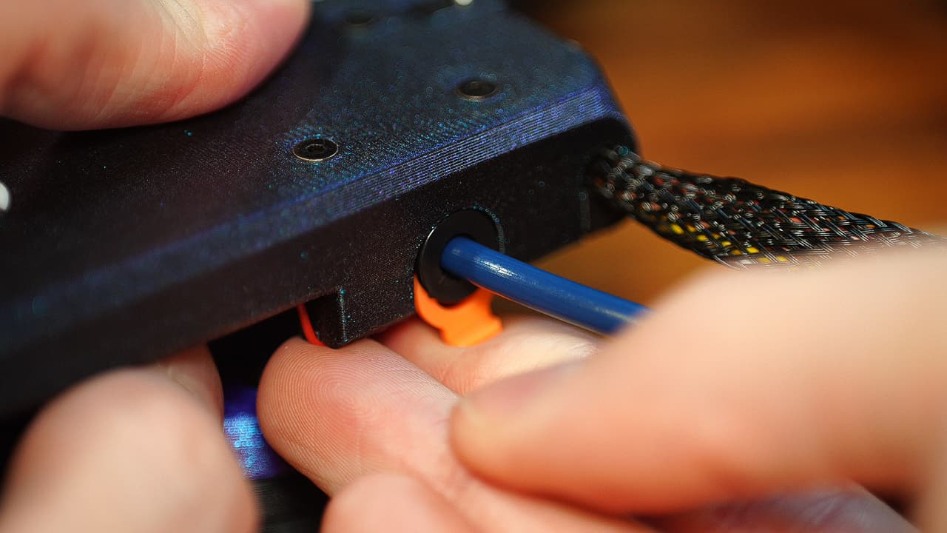
assets/guide/bowden---insert-clip.jpg
