jamesloper/lemontron/assets/guide/bowden---insert-inlet.jpg

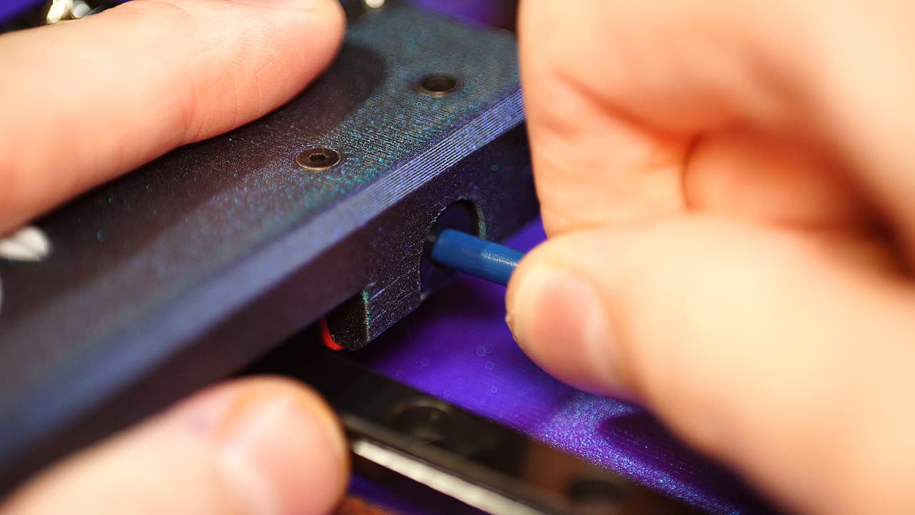
assets/guide/bowden---insert-inlet.jpg
