jamesloper/lemontron/assets/guide/bowden---insert-outlet.jpg

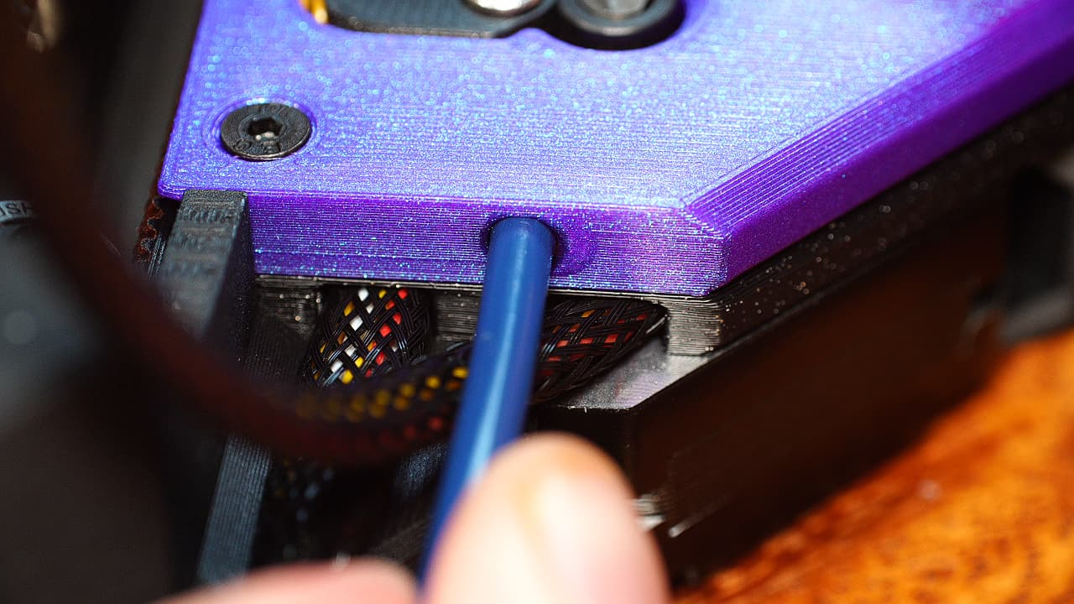
assets/guide/bowden---insert-outlet.jpg
