jamesloper/lemontron/assets/guide/bowden---mark.jpg

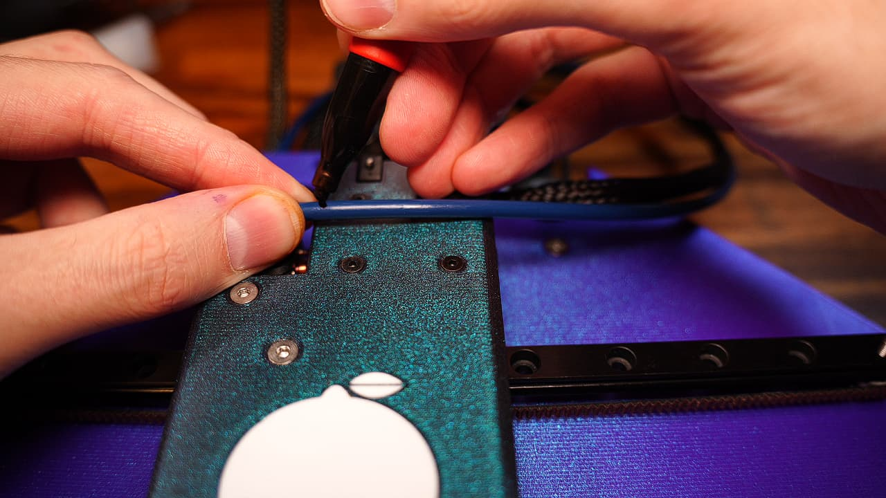
assets/guide/bowden---mark.jpg
