jamesloper/lemontron/assets/guide/bowden---rough-up.jpg

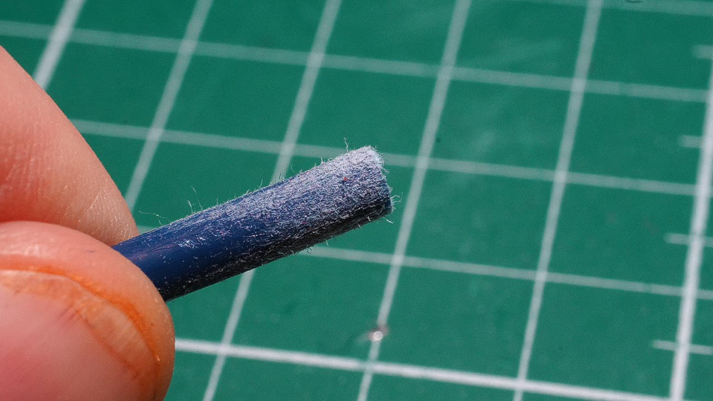
assets/guide/bowden---rough-up.jpg
