jamesloper/lemontron/assets/guide/bowden---zip.jpg

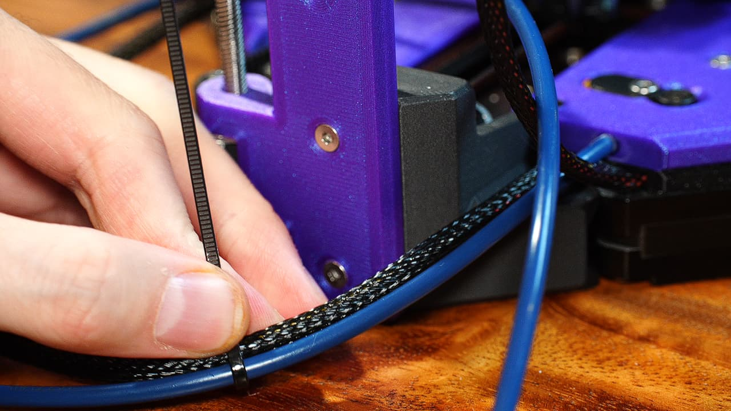
assets/guide/bowden---zip.jpg
