jamesloper/lemontron/assets/guide/chassis---install-extruder-gear.jpg

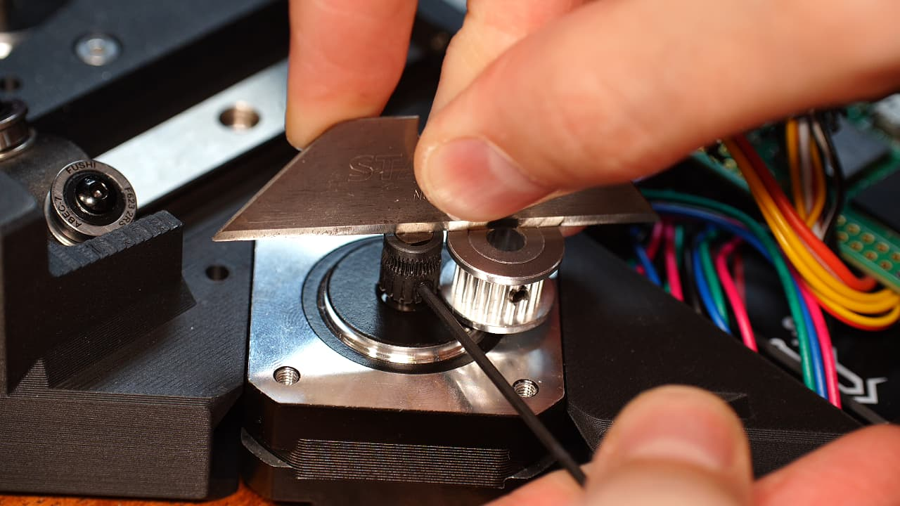
assets/guide/chassis---install-extruder-gear.jpg
