jamesloper/lemontron/assets/guide/chassis---install-left-midplate.jpg

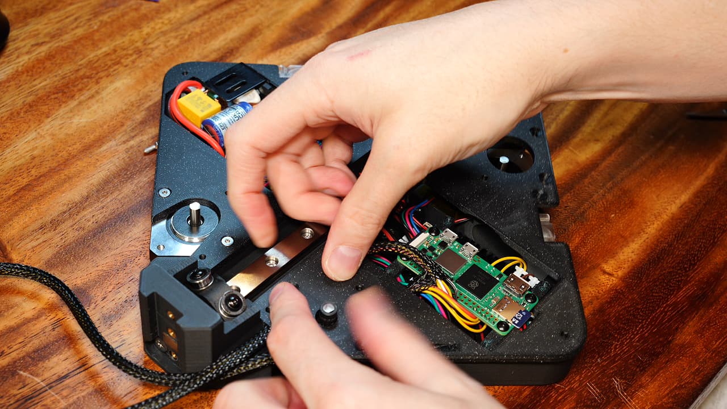
assets/guide/chassis---install-left-midplate.jpg
