jamesloper/lemontron/assets/guide/chassis---install-rail.jpg

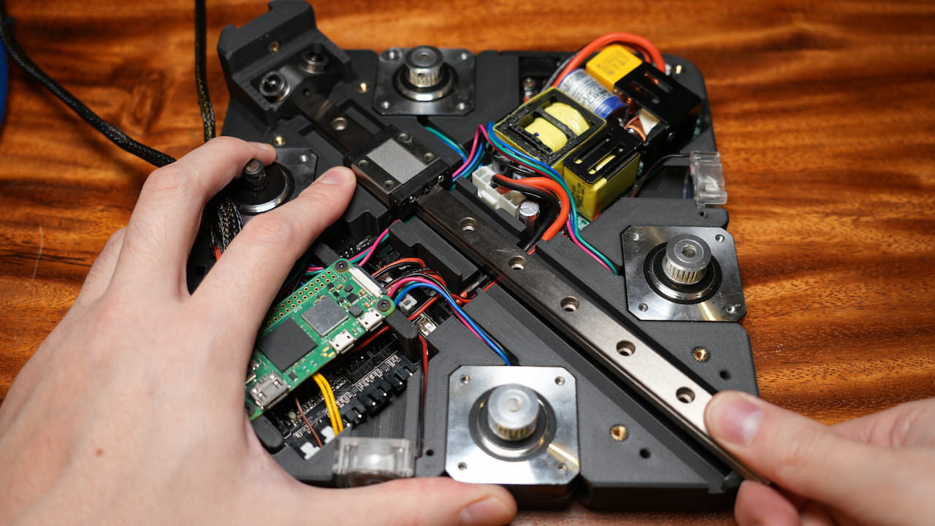
assets/guide/chassis---install-rail.jpg
