jamesloper/lemontron/assets/guide/chassis---install-right-midplate.jpg

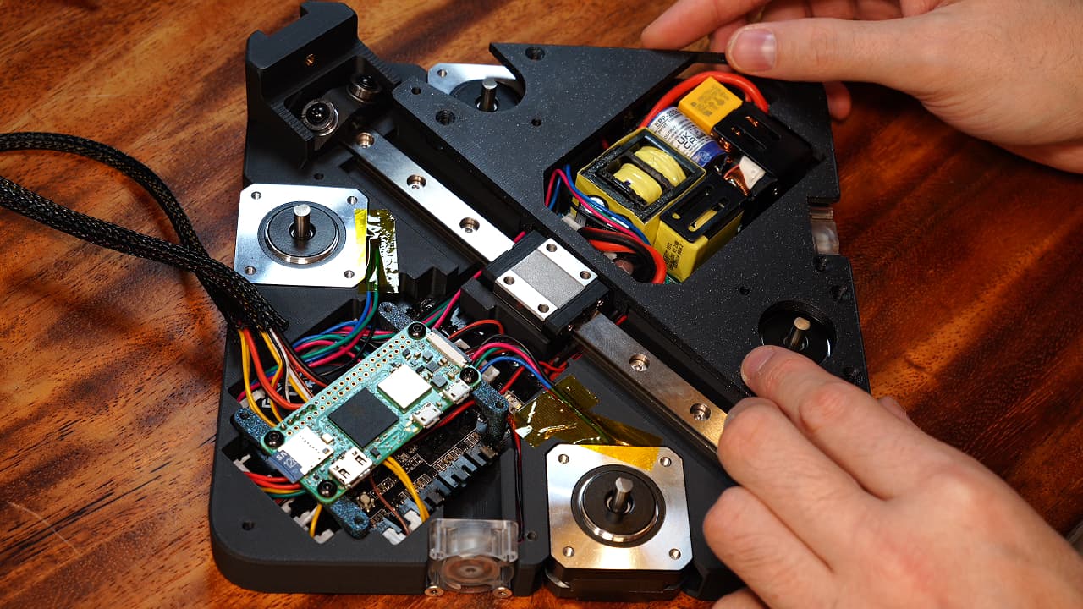
assets/guide/chassis---install-right-midplate.jpg
