jamesloper/lemontron/assets/guide/chassis---tool---install.jpg

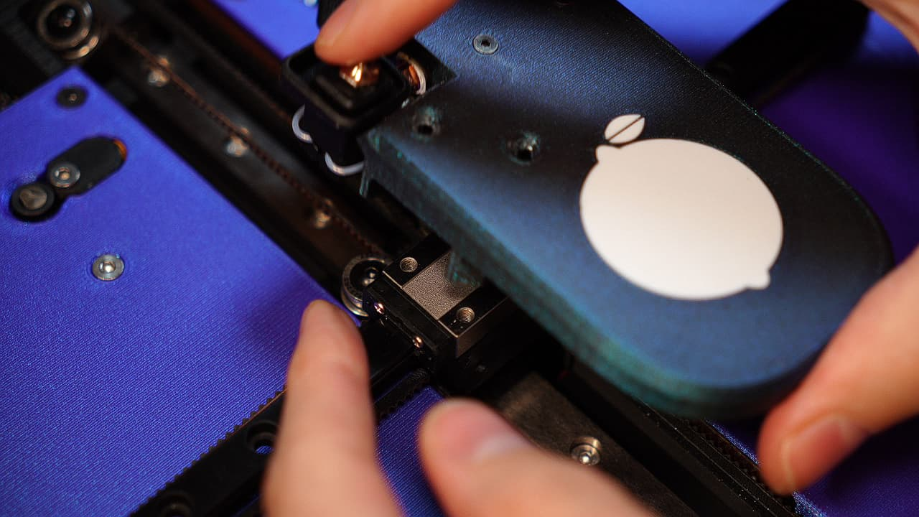
assets/guide/chassis---tool---install.jpg
