jamesloper/lemontron/assets/guide/clip---cut-belt.jpg

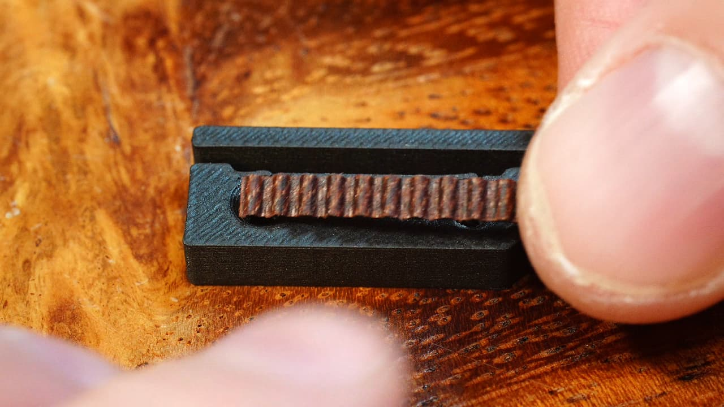
assets/guide/clip---cut-belt.jpg
