jamesloper/lemontron/assets/guide/clip---glue-belts.jpg

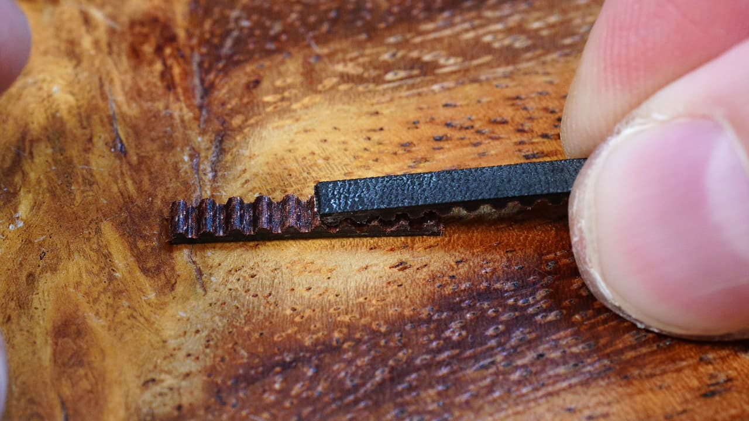
assets/guide/clip---glue-belts.jpg
