jamesloper/lemontron/assets/guide/clip---insert-belt.jpg

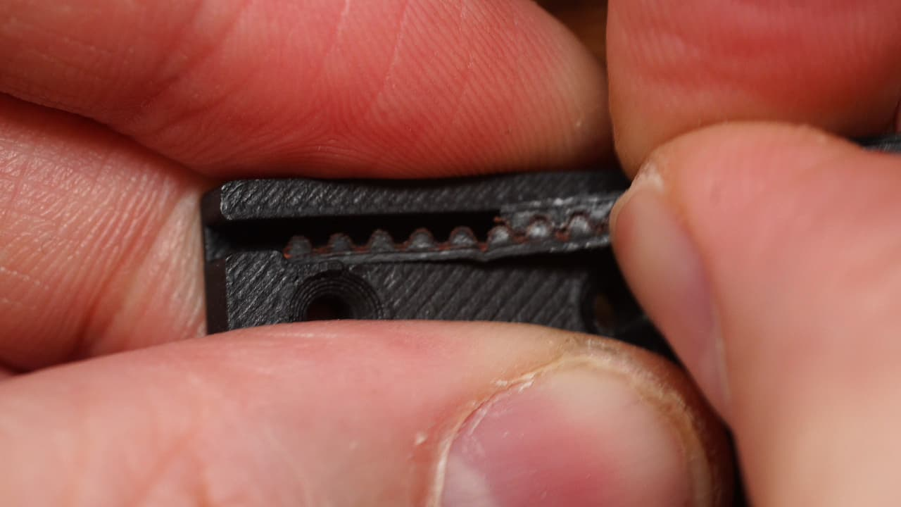
assets/guide/clip---insert-belt.jpg
