jamesloper/lemontron/assets/guide/clip---insert-other-side-belt.jpg

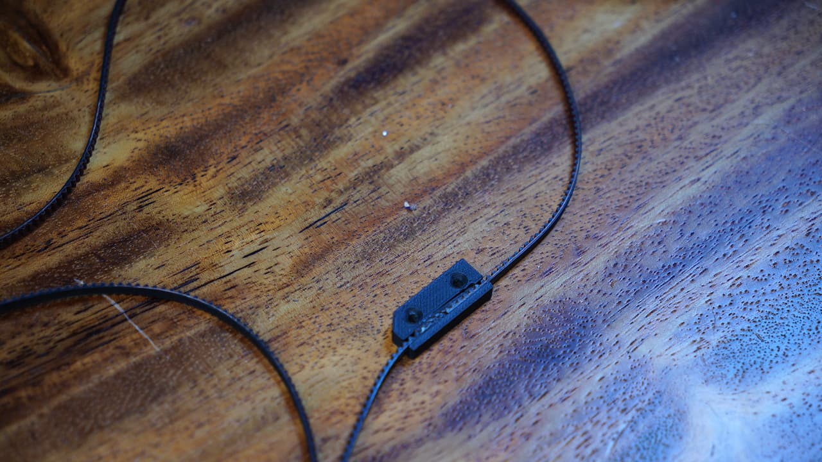
assets/guide/clip---insert-other-side-belt.jpg
