jamesloper/lemontron/assets/guide/clip---super-glue.jpg

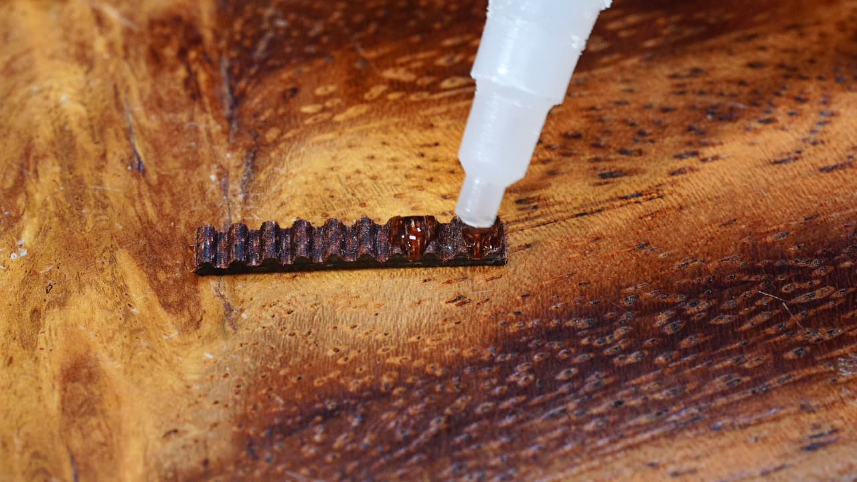
assets/guide/clip---super-glue.jpg
