jamesloper/lemontron/assets/guide/fan---modify.jpg

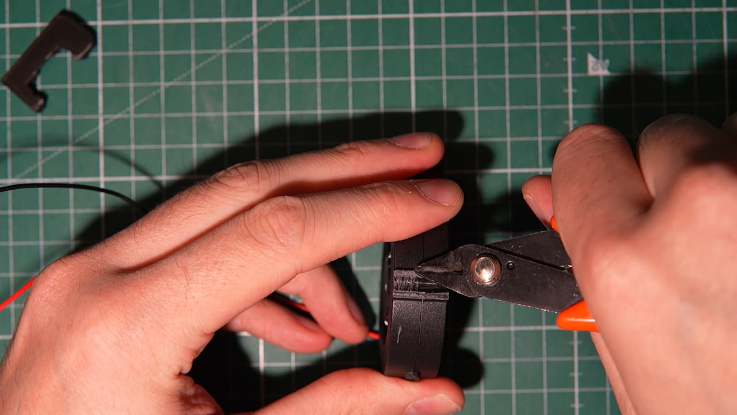
assets/guide/fan---modify.jpg
