jamesloper/lemontron/assets/guide/final---attach-bed.jpg

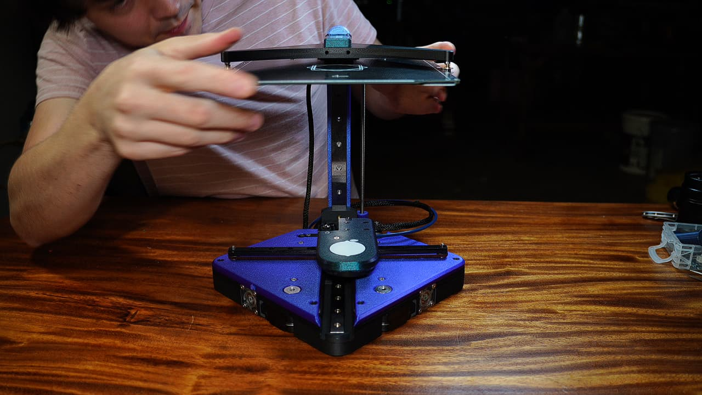
assets/guide/final---attach-bed.jpg
