jamesloper/lemontron/assets/guide/final---bed-holder.jpg

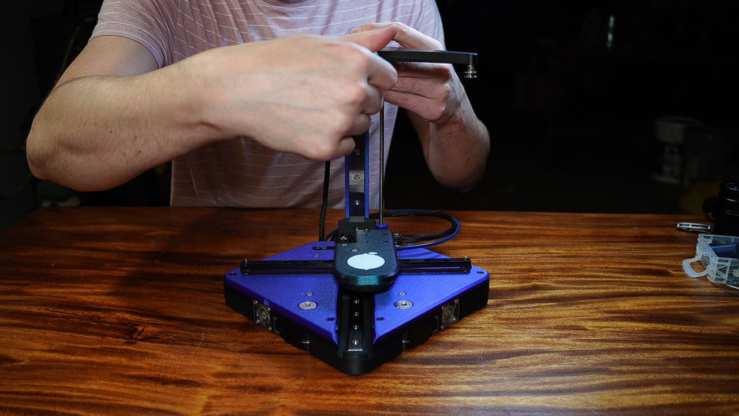
assets/guide/final---bed-holder.jpg
