jamesloper/lemontron/assets/guide/hotend---apply-boron-nitride-to-heat-break.jpg

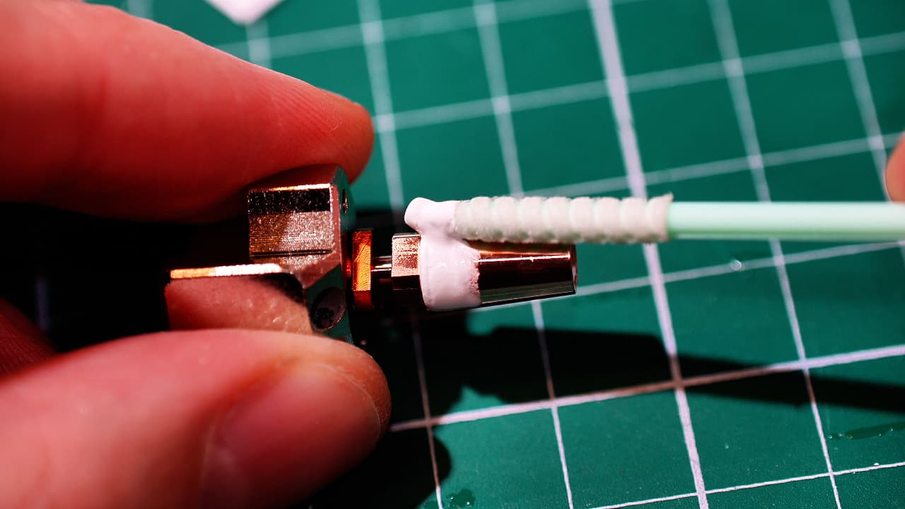
assets/guide/hotend---apply-boron-nitride-to-heat-break.jpg
