jamesloper/lemontron/assets/guide/hotend---apply-boron-nitride-to-heater.jpg

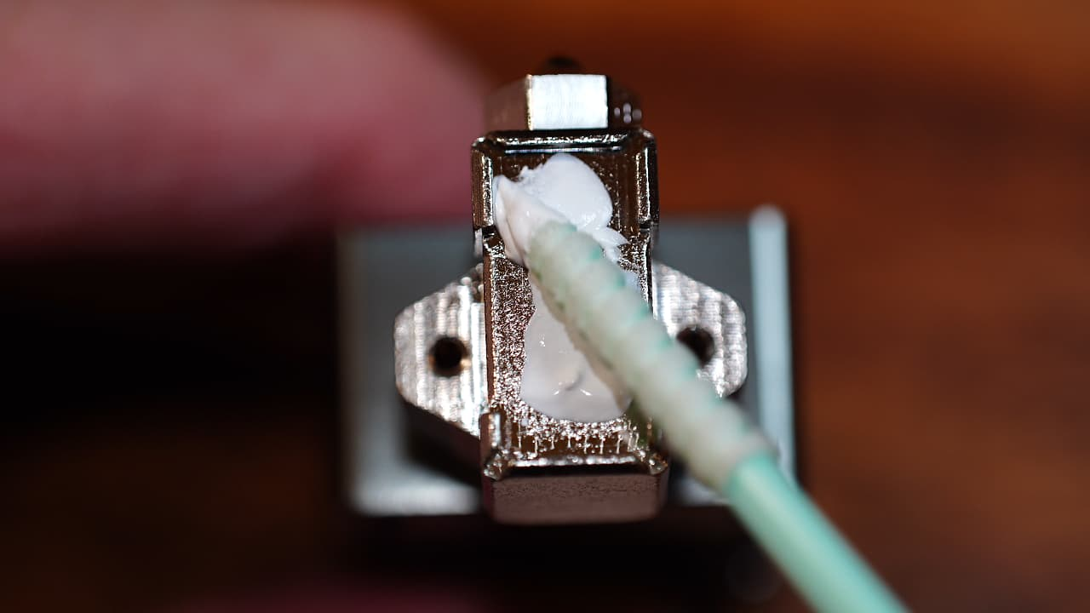
assets/guide/hotend---apply-boron-nitride-to-heater.jpg
