jamesloper/lemontron/assets/guide/hotend---insert-heat-break.jpg

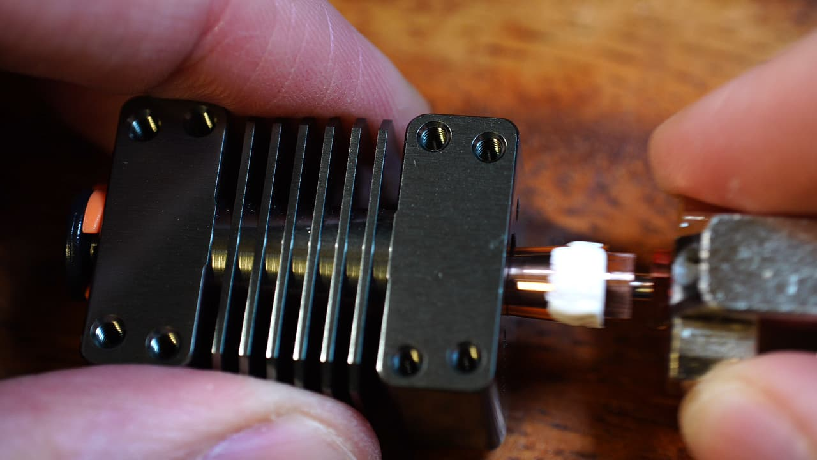
assets/guide/hotend---insert-heat-break.jpg
