jamesloper/lemontron/assets/guide/hotend---insert-thermistor.jpg

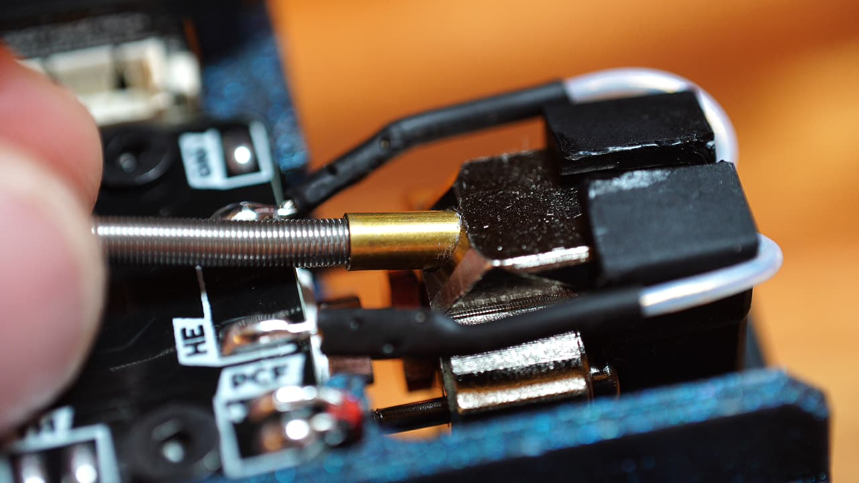
assets/guide/hotend---insert-thermistor.jpg
