jamesloper/lemontron/assets/guide/hotend---reattach-heater-and-clip.jpg

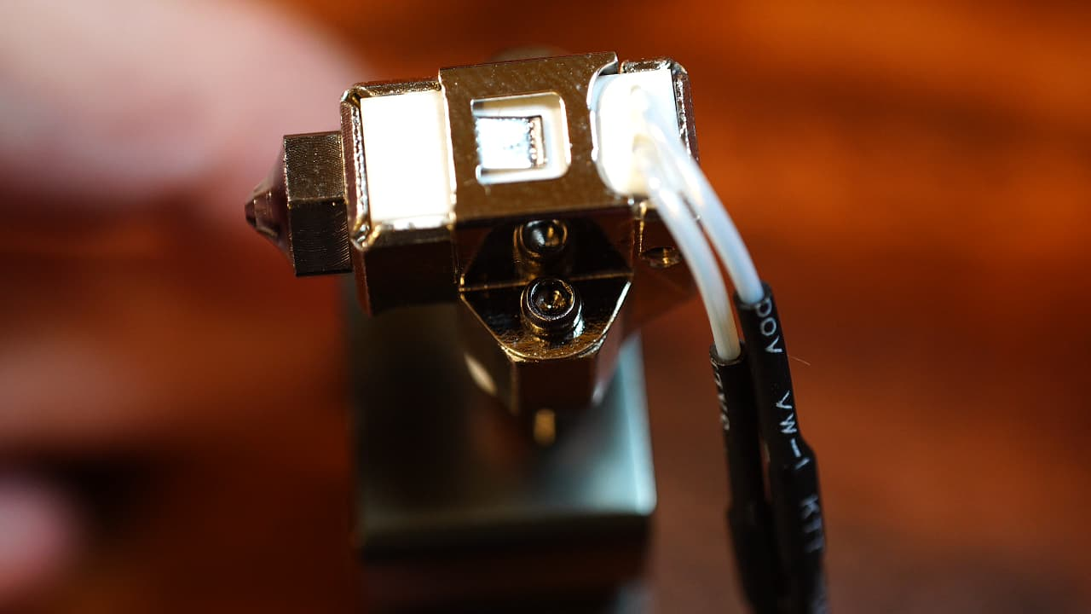
assets/guide/hotend---reattach-heater-and-clip.jpg
