jamesloper/lemontron/assets/guide/hotend---remove-clip.jpg

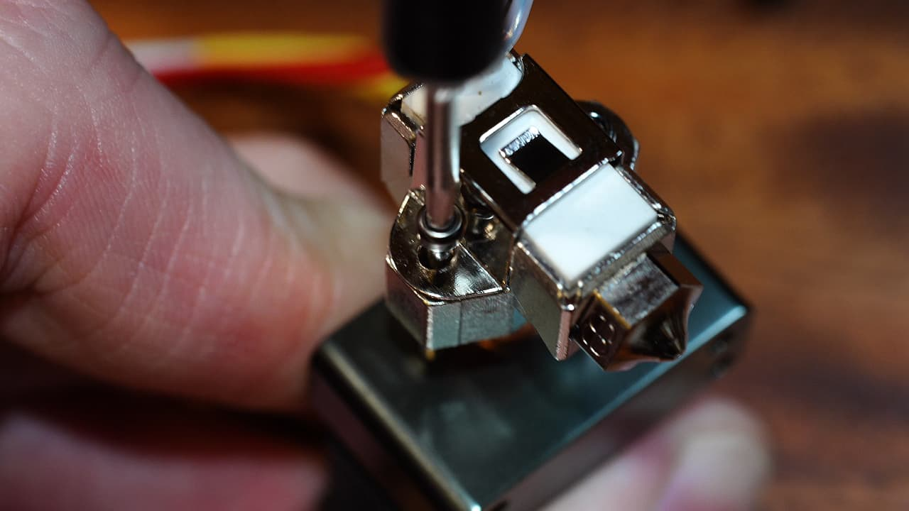
assets/guide/hotend---remove-clip.jpg
