jamesloper/lemontron/assets/guide/hotend---remove-heat-break.jpg

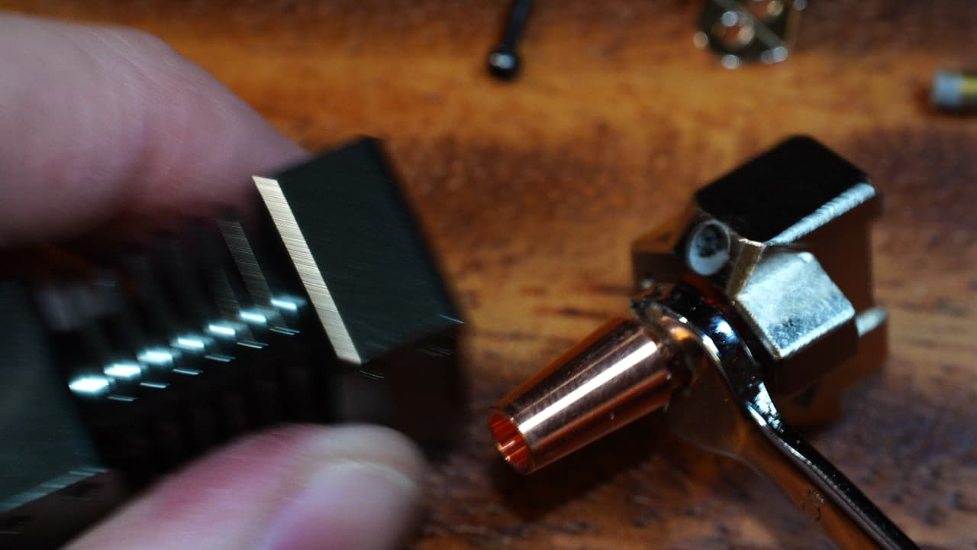
assets/guide/hotend---remove-heat-break.jpg
