jamesloper/lemontron/assets/guide/hotend---remove-heater.jpg

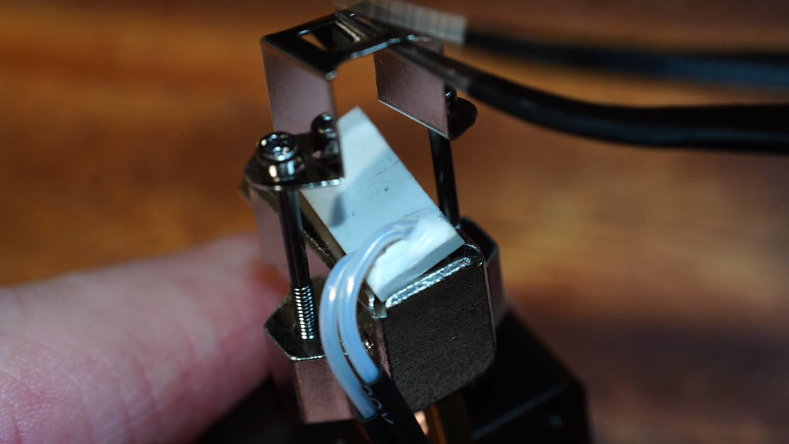
assets/guide/hotend---remove-heater.jpg
