jamesloper/lemontron/assets/guide/hotend---remove-retaining-screw.jpg

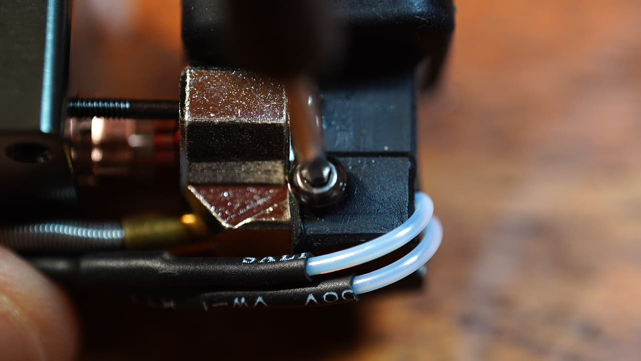
assets/guide/hotend---remove-retaining-screw.jpg
