jamesloper/lemontron/assets/guide/hotend---remove-sock.jpg

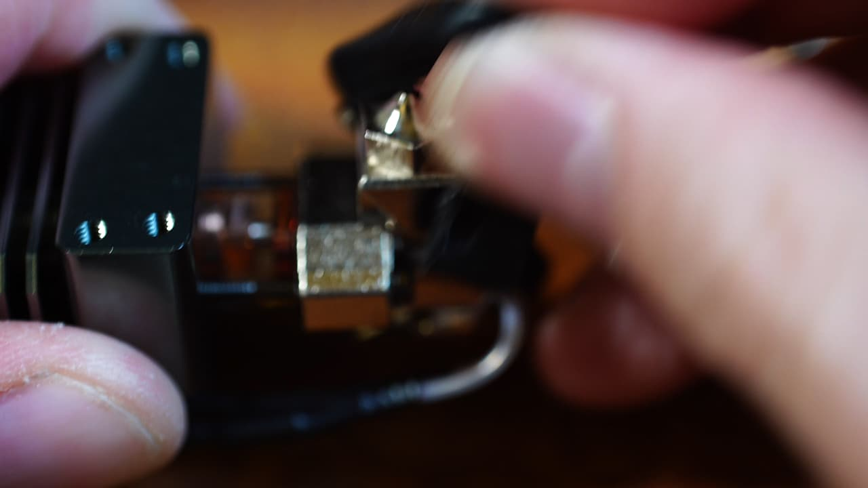
assets/guide/hotend---remove-sock.jpg
