jamesloper/lemontron/assets/guide/hotend---remove-thermistor.jpg

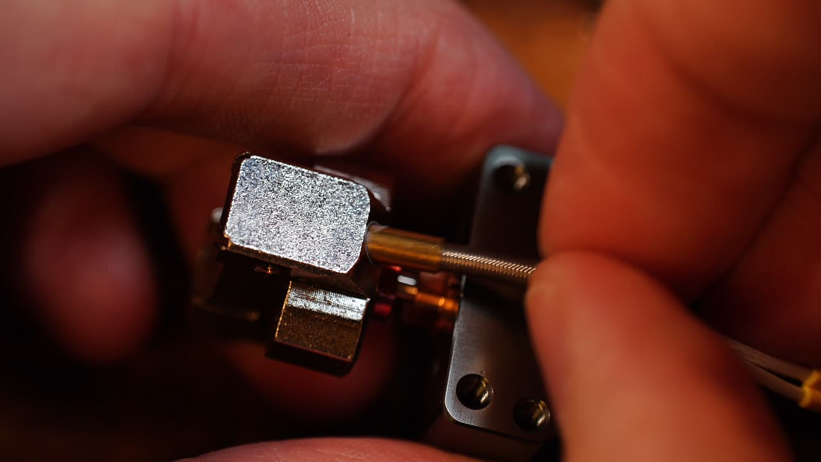
assets/guide/hotend---remove-thermistor.jpg
