jamesloper/lemontron/assets/guide/hotend---tighten-heat-break.jpg

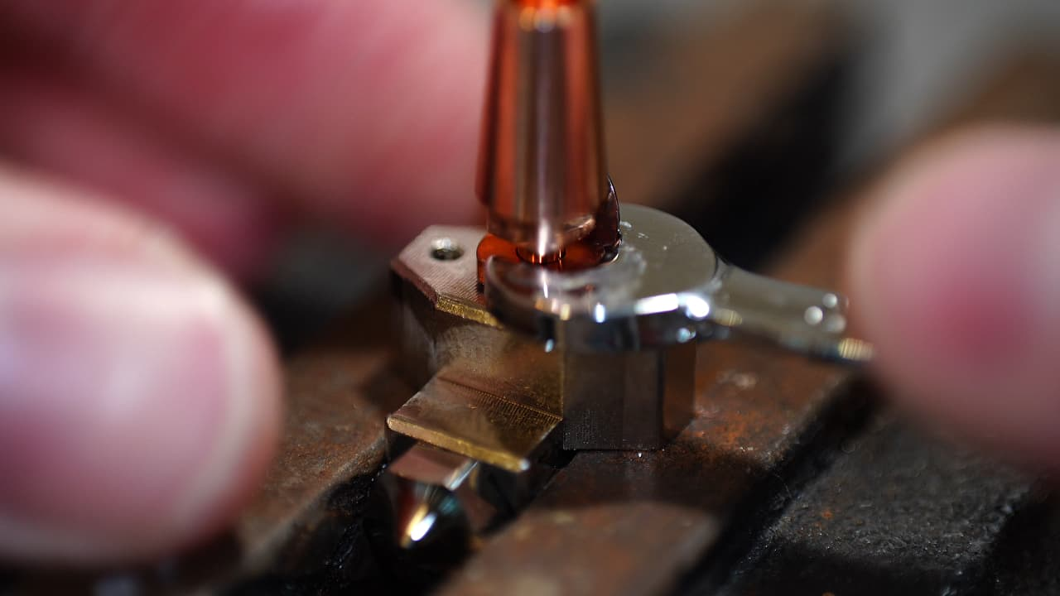
assets/guide/hotend---tighten-heat-break.jpg
