jamesloper/lemontron/assets/guide/hotend.jpg

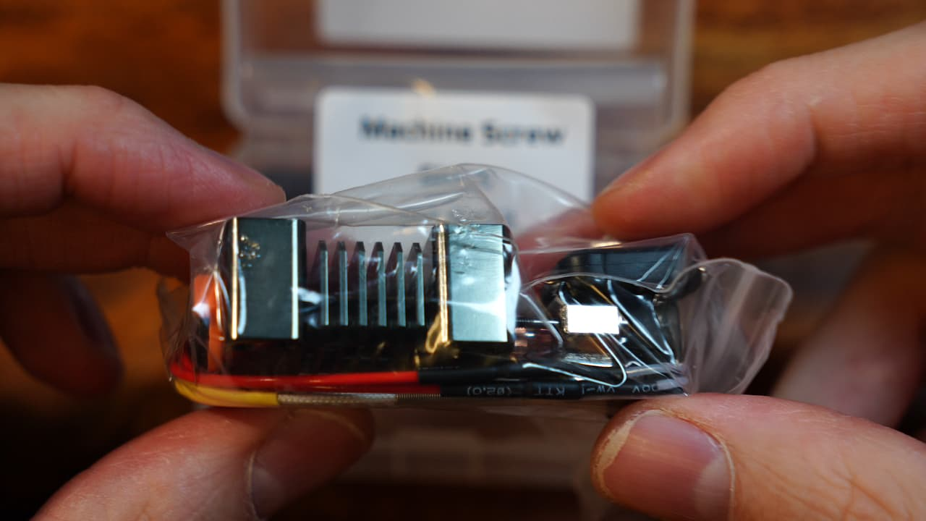
assets/guide/hotend.jpg
