jamesloper/lemontron/assets/guide/intro---sd-card.jpg

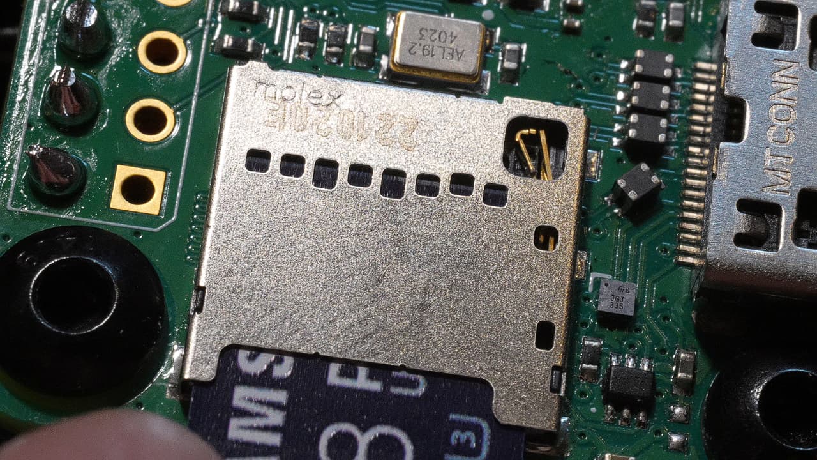
assets/guide/intro---sd-card.jpg
