jamesloper/lemontron/assets/guide/intro---slicer.png

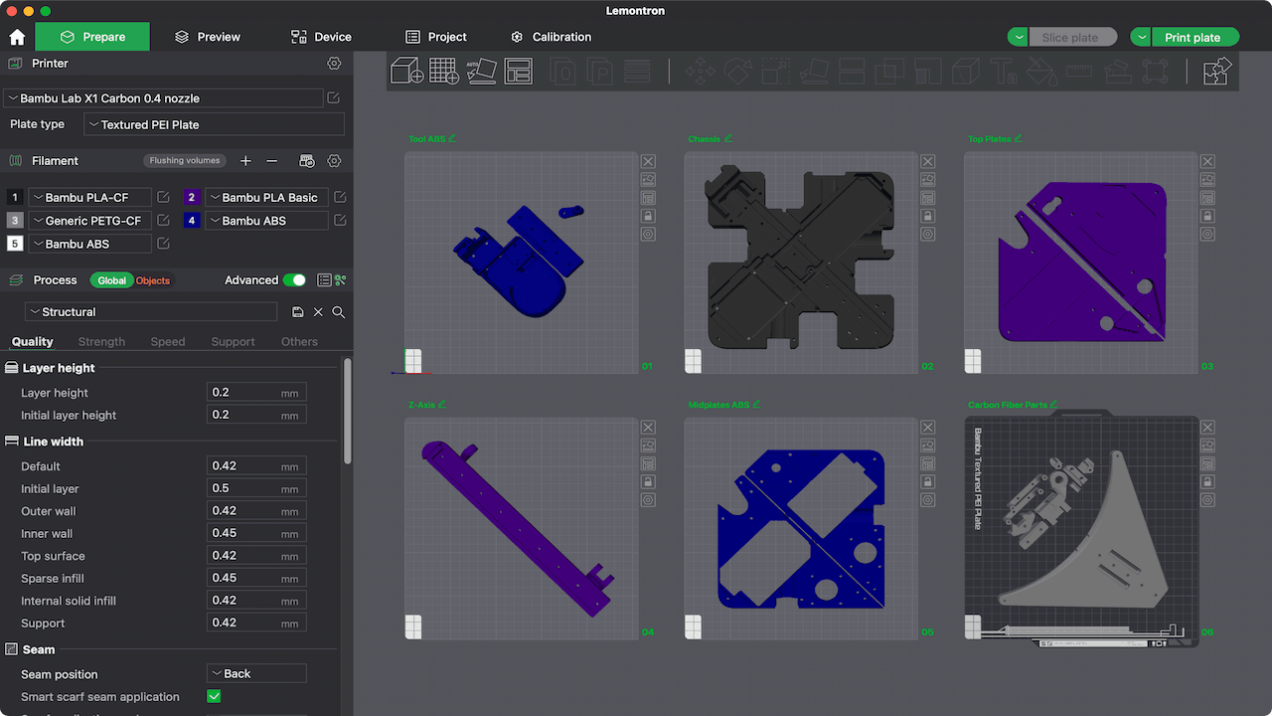
assets/guide/intro---slicer.png
