jamesloper/lemontron/assets/guide/lemonstruder---bearing.jpg

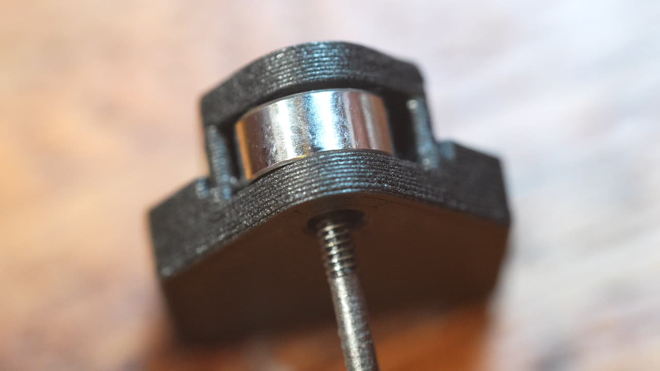
assets/guide/lemonstruder---bearing.jpg
