jamesloper/lemontron/assets/guide/lemonstruder---finished.jpg

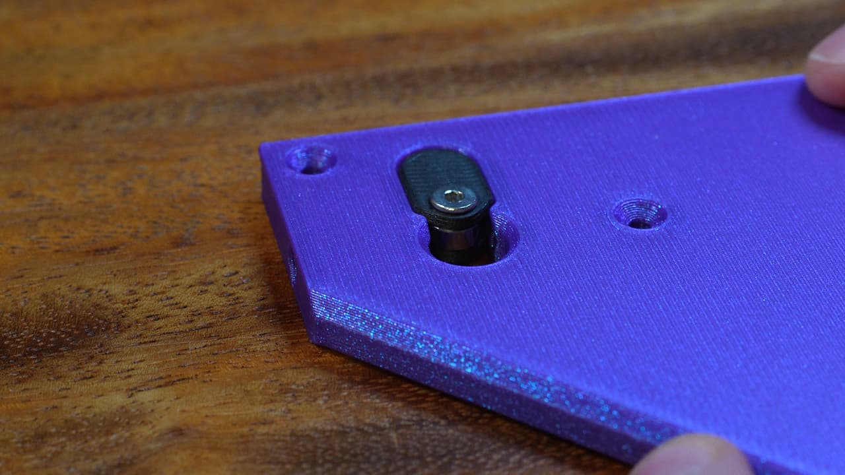
assets/guide/lemonstruder---finished.jpg
