jamesloper/lemontron/assets/guide/lemonstruder---first-shim.jpg

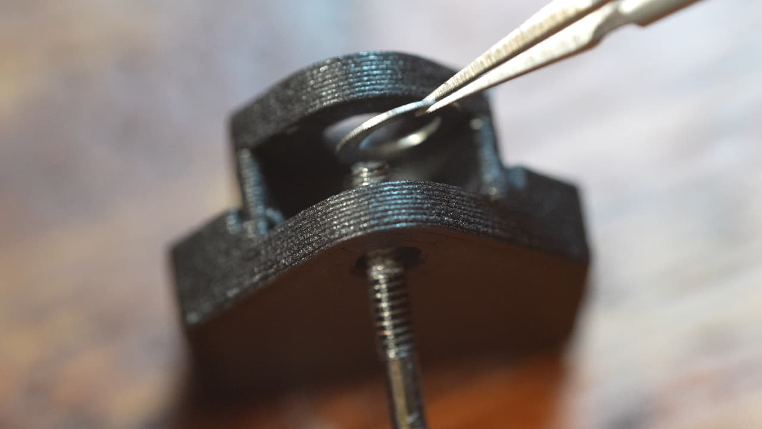
assets/guide/lemonstruder---first-shim.jpg
