jamesloper/lemontron/assets/guide/lemonstruder---glue.jpg

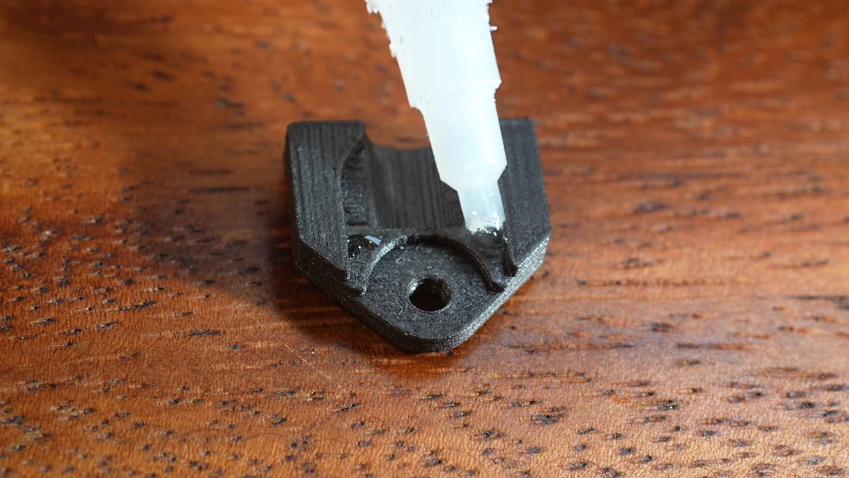
assets/guide/lemonstruder---glue.jpg
