jamesloper/lemontron/assets/guide/lemonstruder---insert-screw.jpg

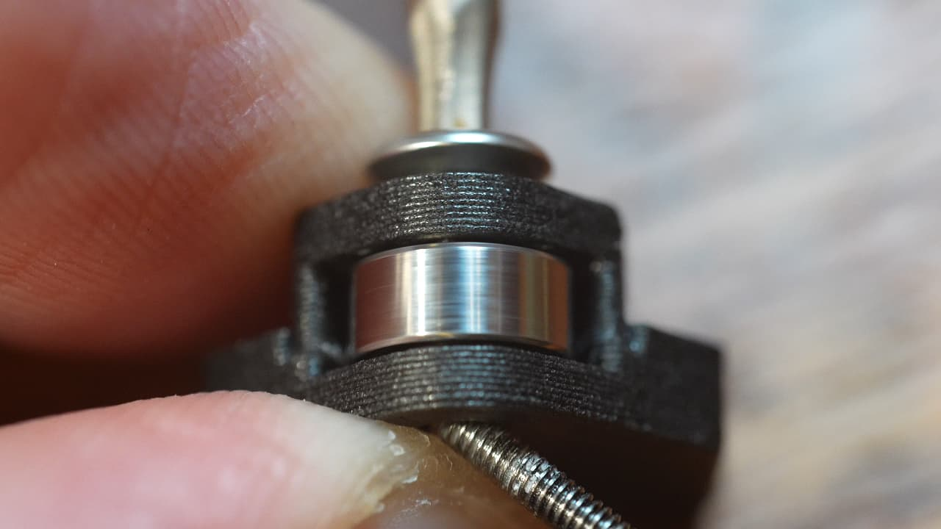
assets/guide/lemonstruder---insert-screw.jpg
