jamesloper/lemontron/assets/guide/lemonstruder---insert-spring.jpg

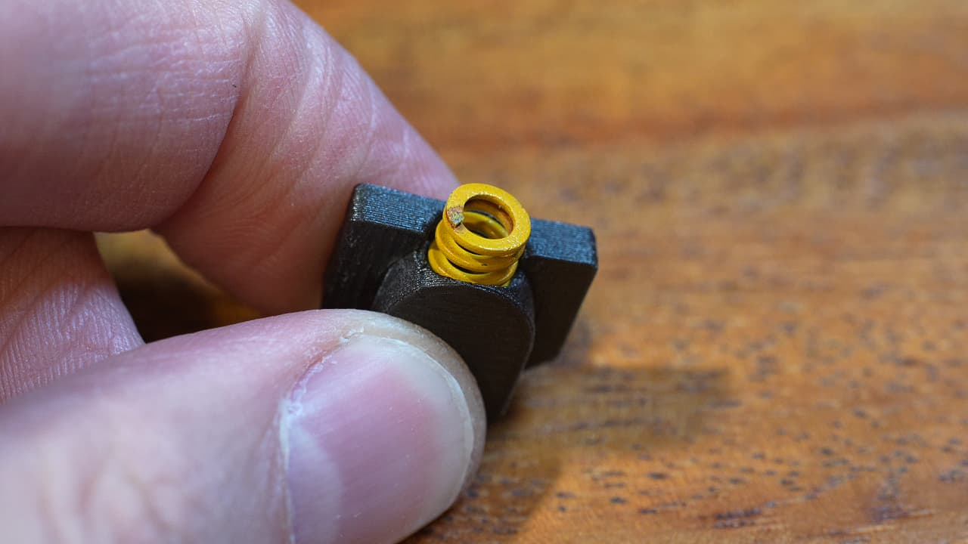
assets/guide/lemonstruder---insert-spring.jpg
