jamesloper/lemontron/assets/guide/lemonstruder---second-shim.jpg

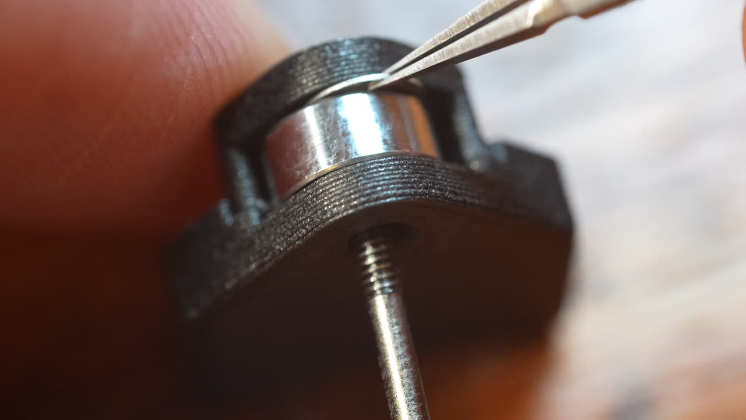
assets/guide/lemonstruder---second-shim.jpg
