jamesloper/lemontron/assets/guide/midplate---left---locator-screw.jpg

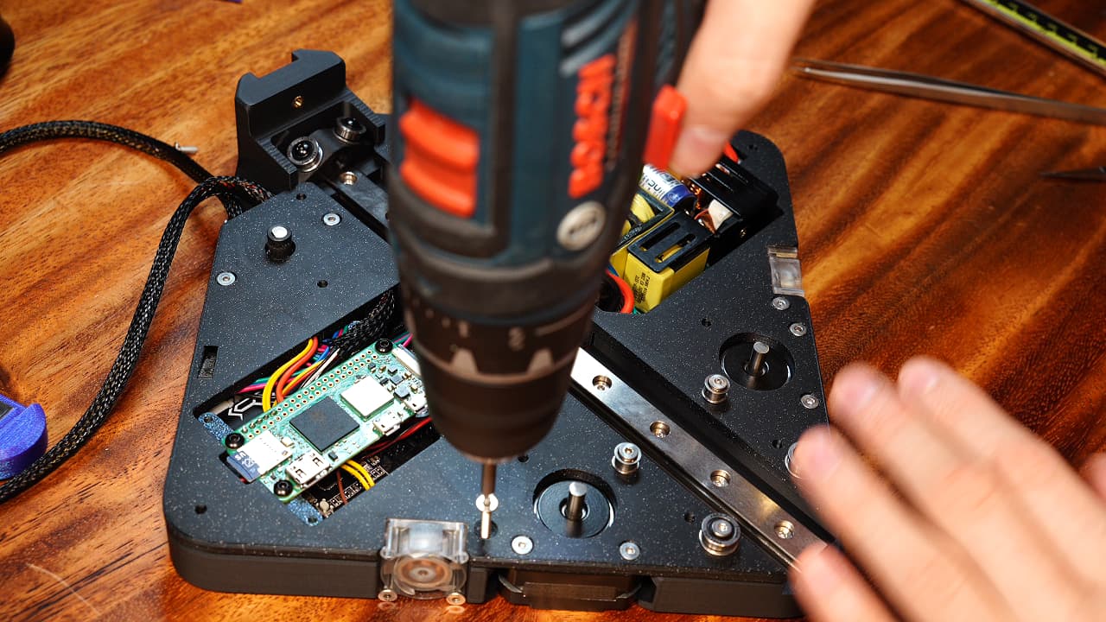
assets/guide/midplate---left---locator-screw.jpg
