jamesloper/lemontron/assets/guide/midplate---left---lower-pulley.jpg

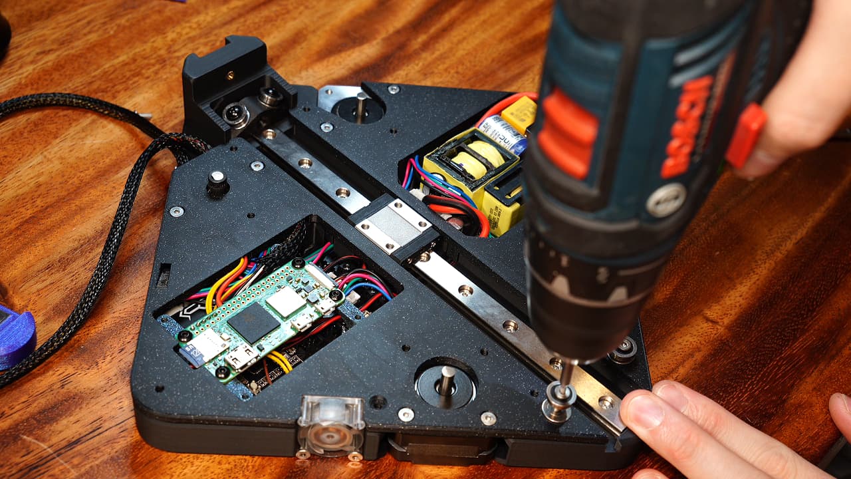
assets/guide/midplate---left---lower-pulley.jpg
