jamesloper/lemontron/assets/guide/midplate---left---motor-mounts.jpg

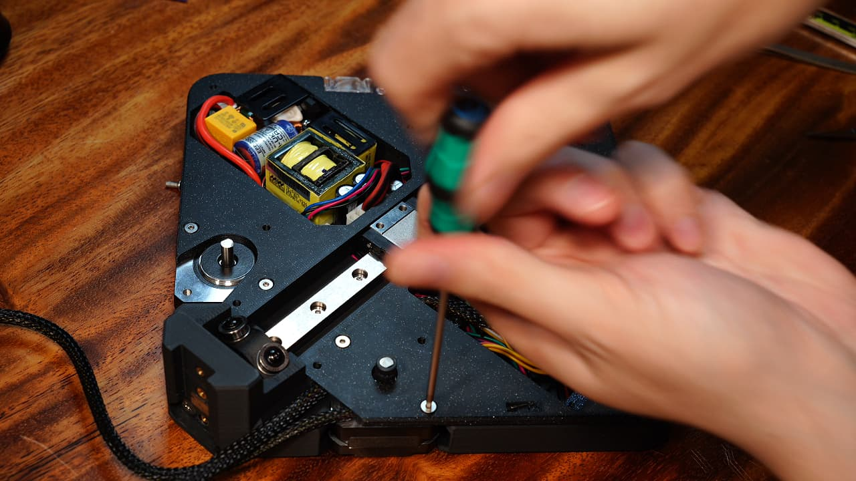
assets/guide/midplate---left---motor-mounts.jpg
