jamesloper/lemontron/assets/guide/midplate---left---upper-pulley.jpg

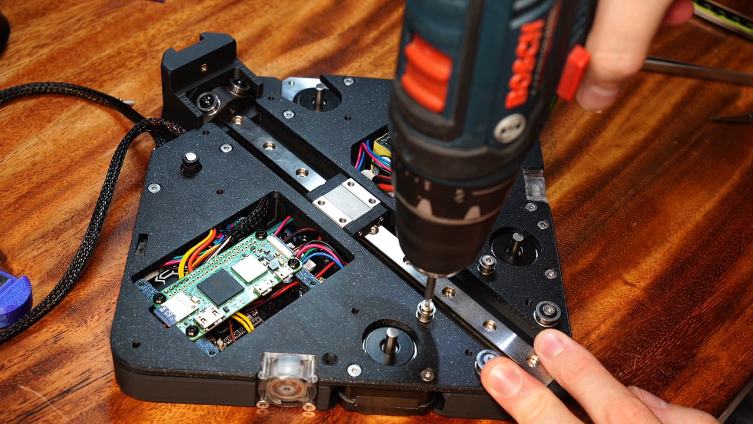
assets/guide/midplate---left---upper-pulley.jpg
