jamesloper/lemontron/assets/guide/midplate---right---locator-screw.jpg

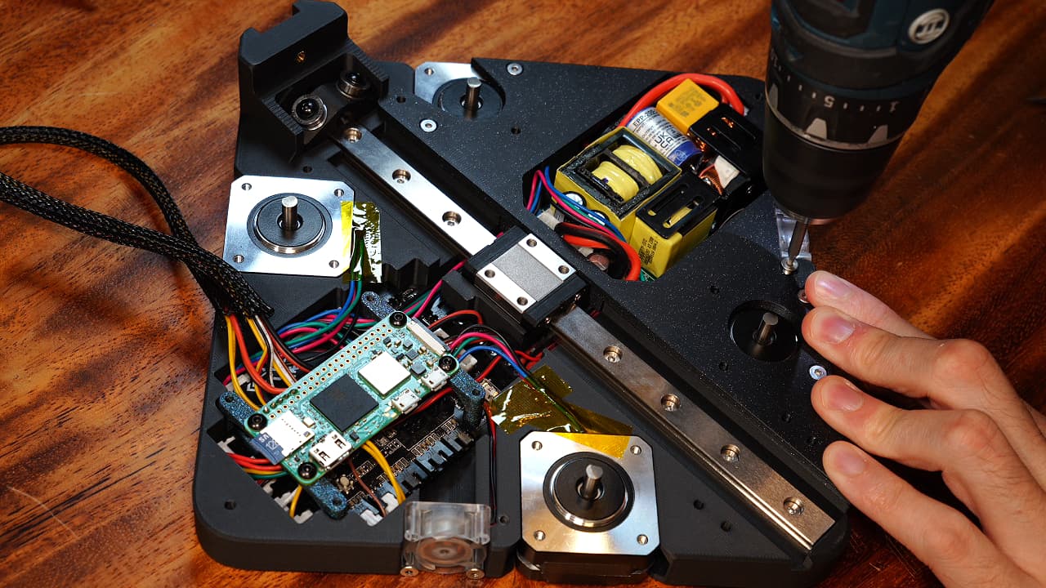
assets/guide/midplate---right---locator-screw.jpg
