jamesloper/lemontron/assets/guide/midplate---right---lower-pulley.jpg

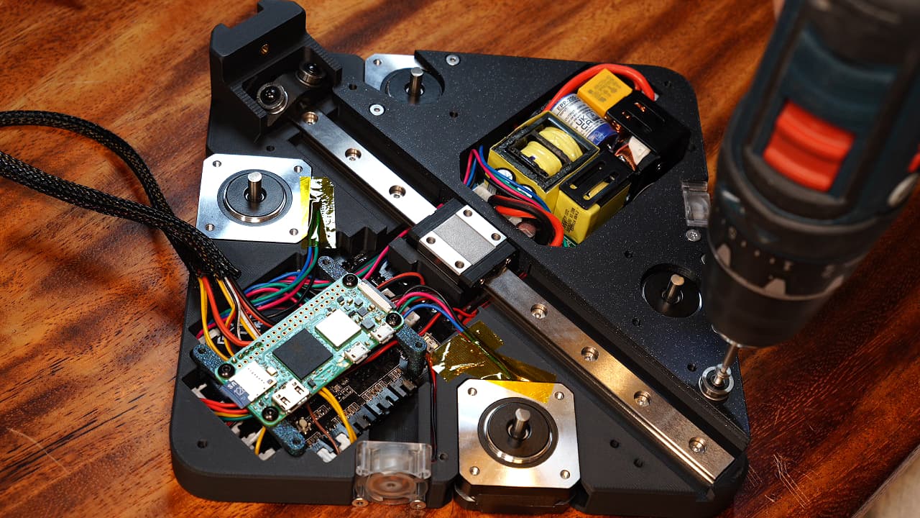
assets/guide/midplate---right---lower-pulley.jpg
