jamesloper/lemontron/assets/guide/midplate---right---motor-mounts.jpg

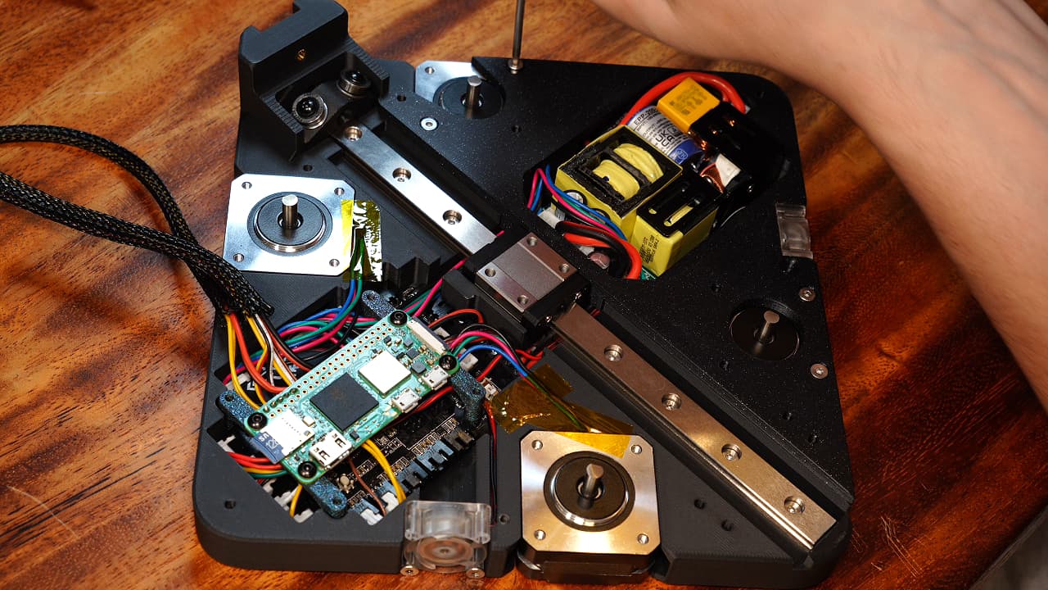
assets/guide/midplate---right---motor-mounts.jpg
