jamesloper/lemontron/assets/guide/midplate---right---upper-pulley.jpg

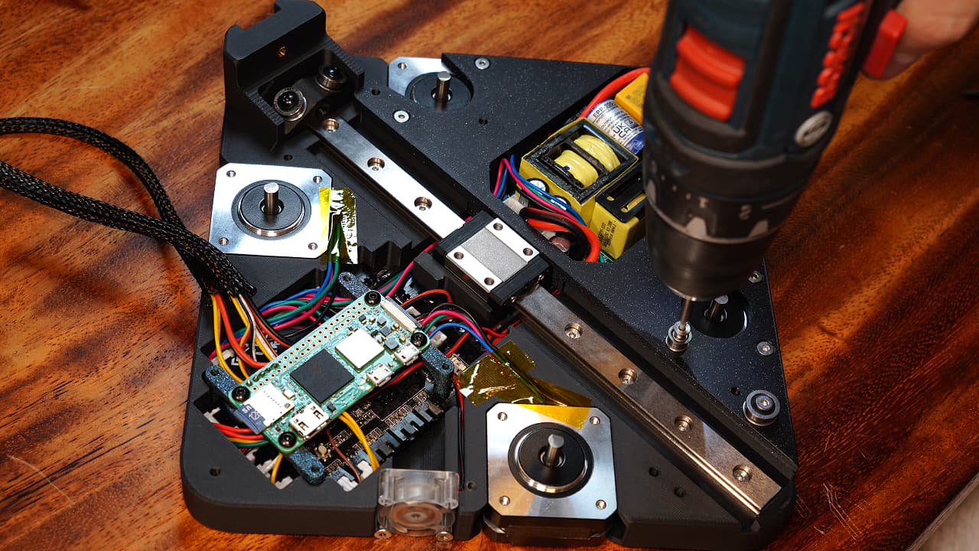
assets/guide/midplate---right---upper-pulley.jpg
