jamesloper/lemontron/assets/guide/motor---left---install-drive-pulley.jpg

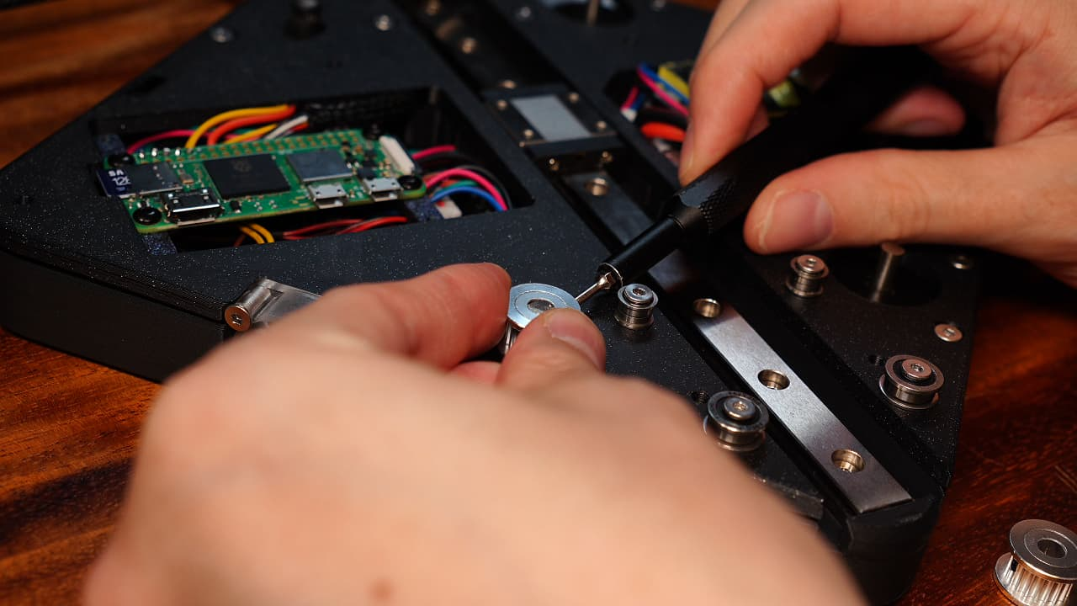
assets/guide/motor---left---install-drive-pulley.jpg
