jamesloper/lemontron/assets/guide/motor---right---install-drive-pulley.jpg

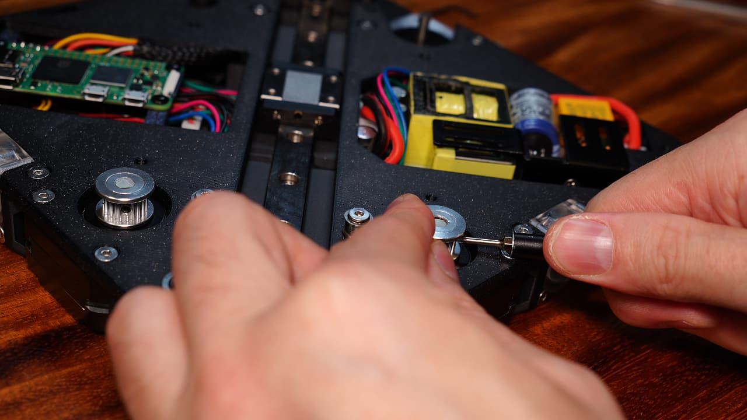
assets/guide/motor---right---install-drive-pulley.jpg
