jamesloper/lemontron/assets/guide/motors---connector.jpg

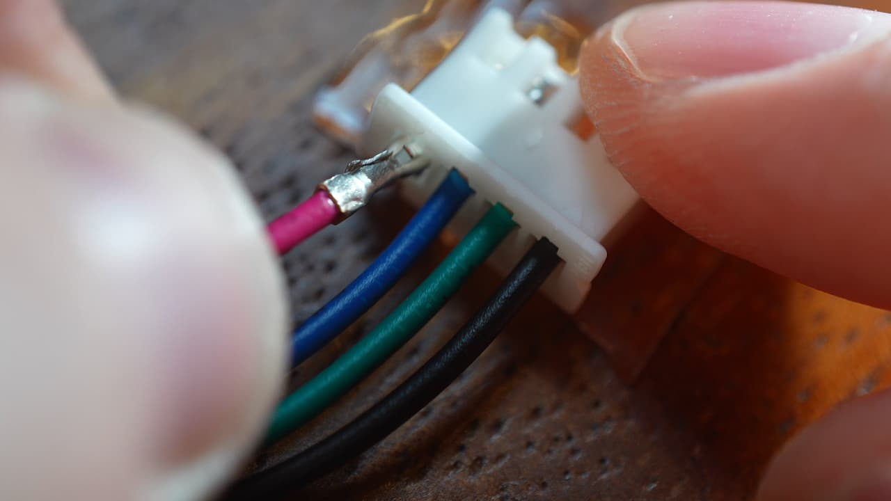
assets/guide/motors---connector.jpg
