jamesloper/lemontron/assets/guide/motors---crimping.jpg

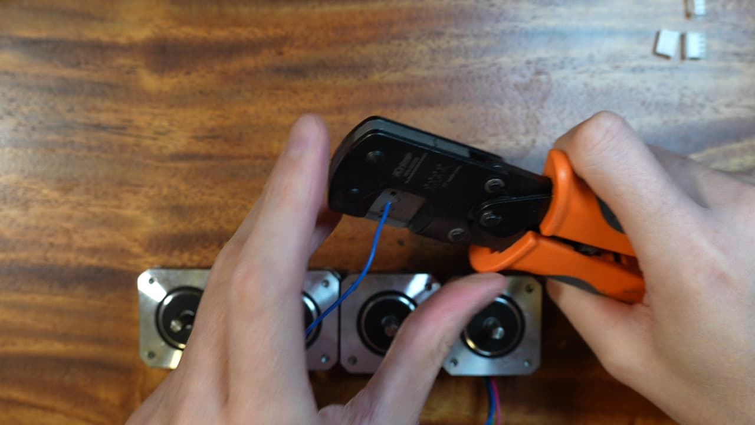
assets/guide/motors---crimping.jpg
