jamesloper/lemontron/assets/guide/motors---cut-shaft.jpg

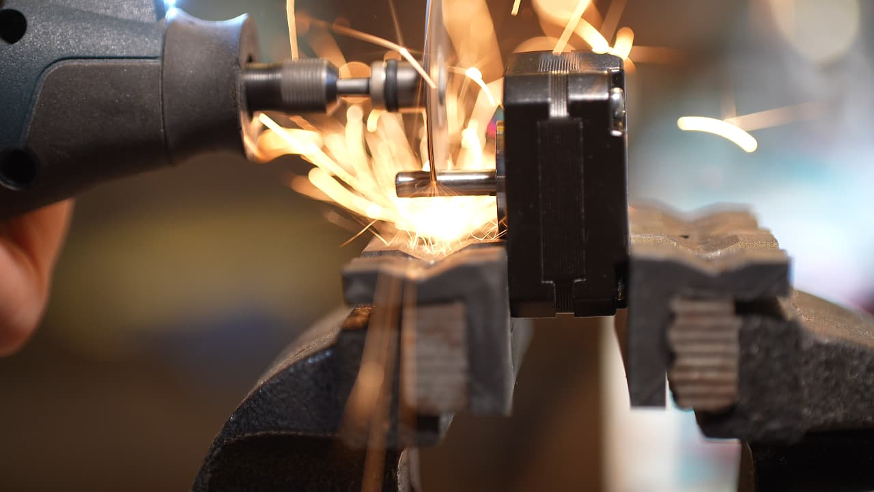
assets/guide/motors---cut-shaft.jpg
