jamesloper/lemontron/assets/guide/motors---cut-wires.jpg

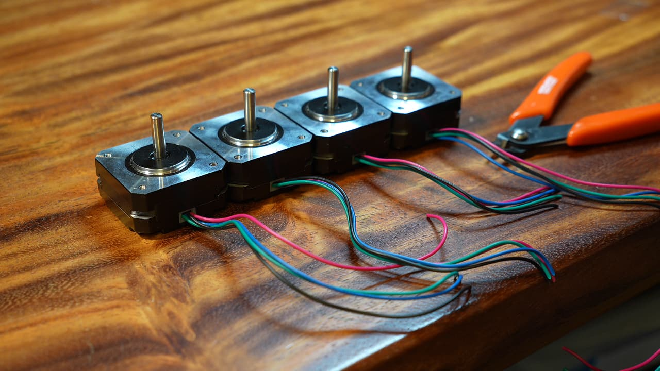
assets/guide/motors---cut-wires.jpg
