jamesloper/lemontron/assets/guide/motors---mark-shaft.jpg

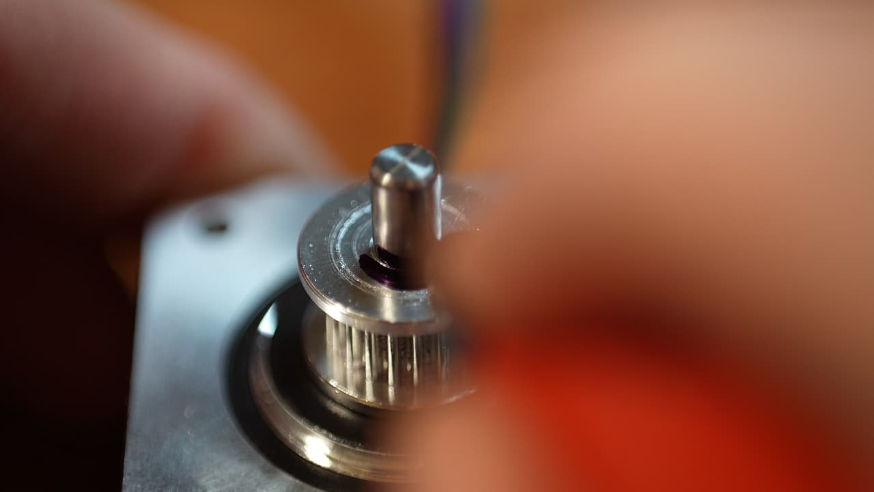
assets/guide/motors---mark-shaft.jpg
