jamesloper/lemontron/assets/guide/psu---cut.jpg

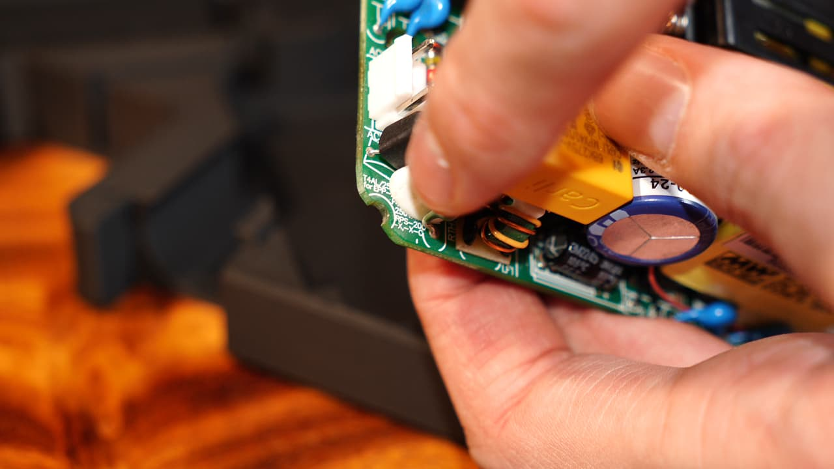
assets/guide/psu---cut.jpg
