jamesloper/lemontron/assets/guide/rail---attach-x-rail.jpg

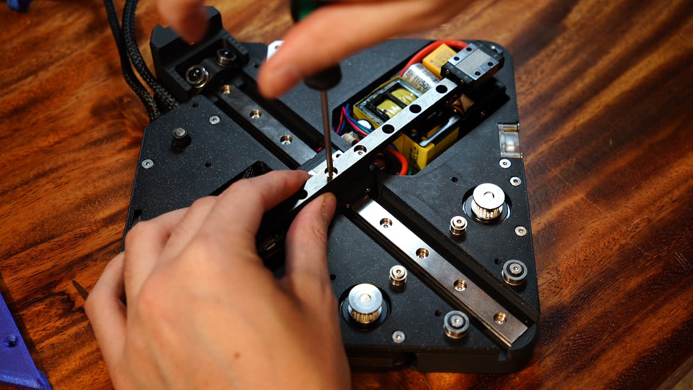
assets/guide/rail---attach-x-rail.jpg
