jamesloper/lemontron/assets/guide/rail---bearing-towers.jpg

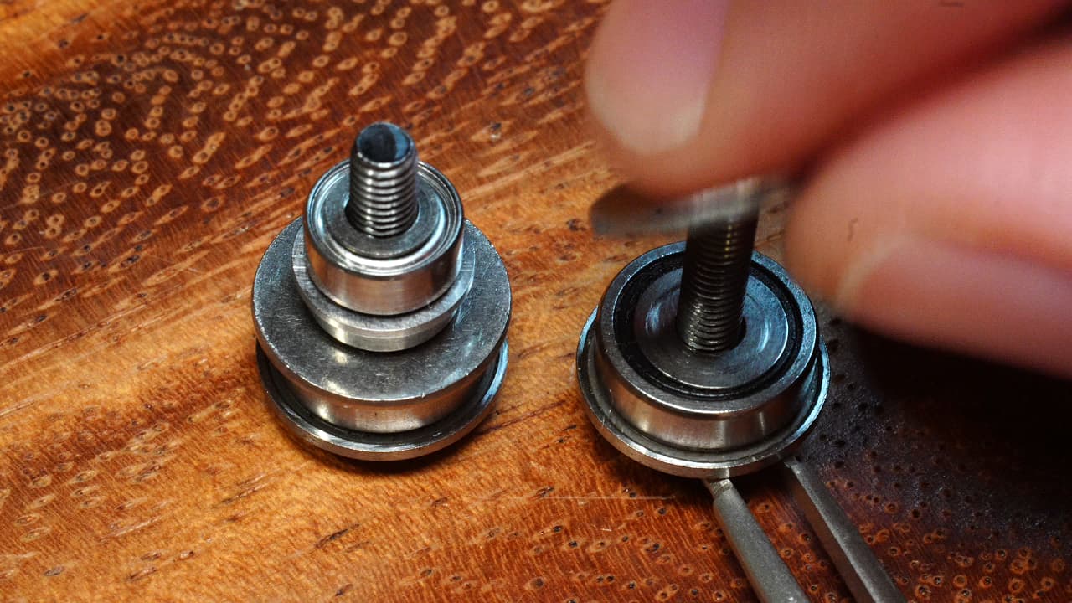
assets/guide/rail---bearing-towers.jpg
