jamesloper/lemontron/assets/guide/rail---insert-nut.jpg

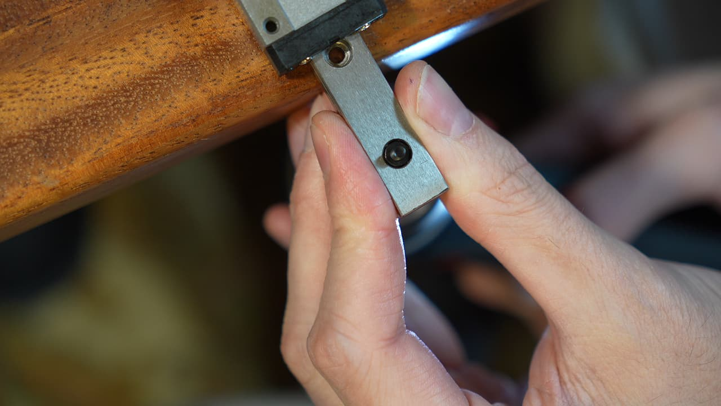
assets/guide/rail---insert-nut.jpg
