jamesloper/lemontron/assets/guide/rail---install-bearing-towers.jpg

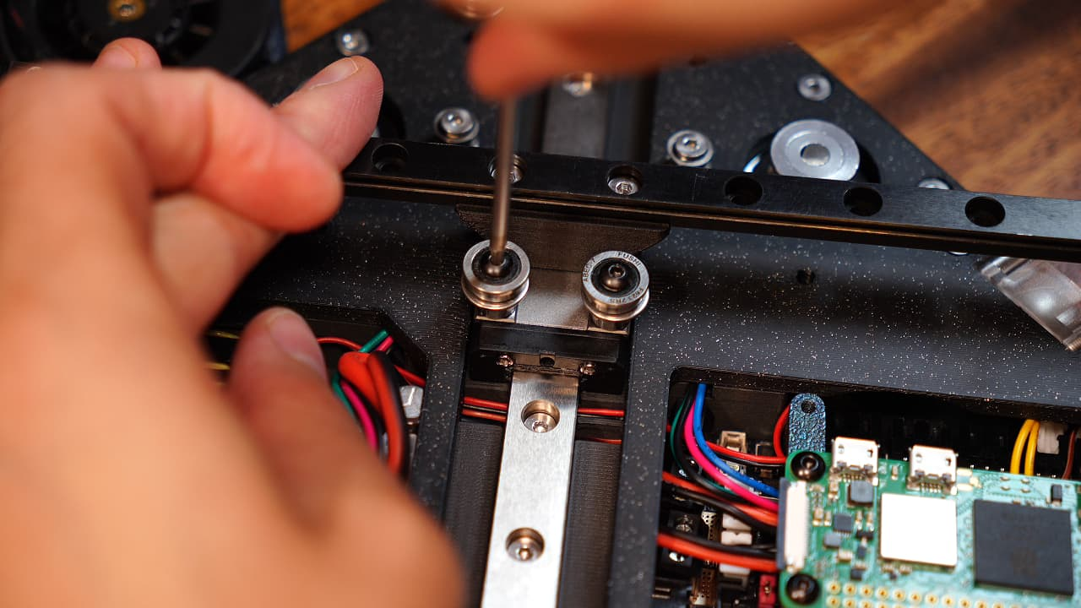
assets/guide/rail---install-bearing-towers.jpg
