jamesloper/lemontron/assets/guide/rail---install-spacer.jpg

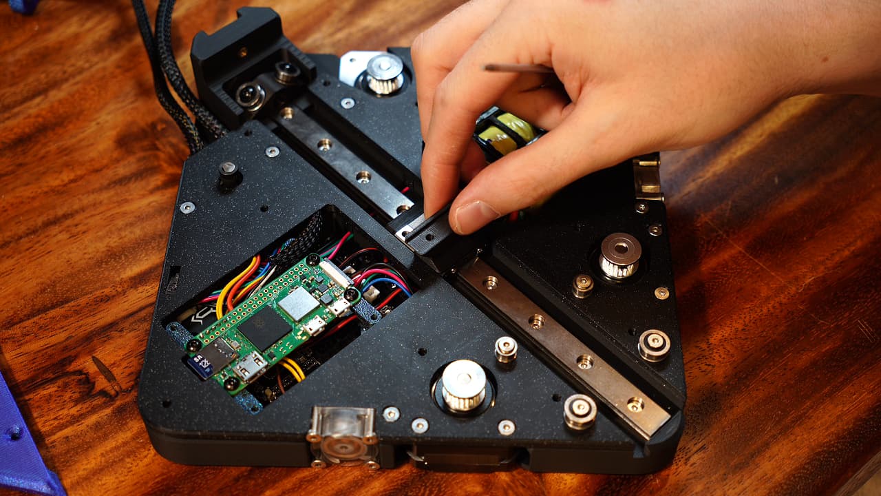
assets/guide/rail---install-spacer.jpg
