jamesloper/lemontron/assets/guide/rail---install-tensioner.jpg

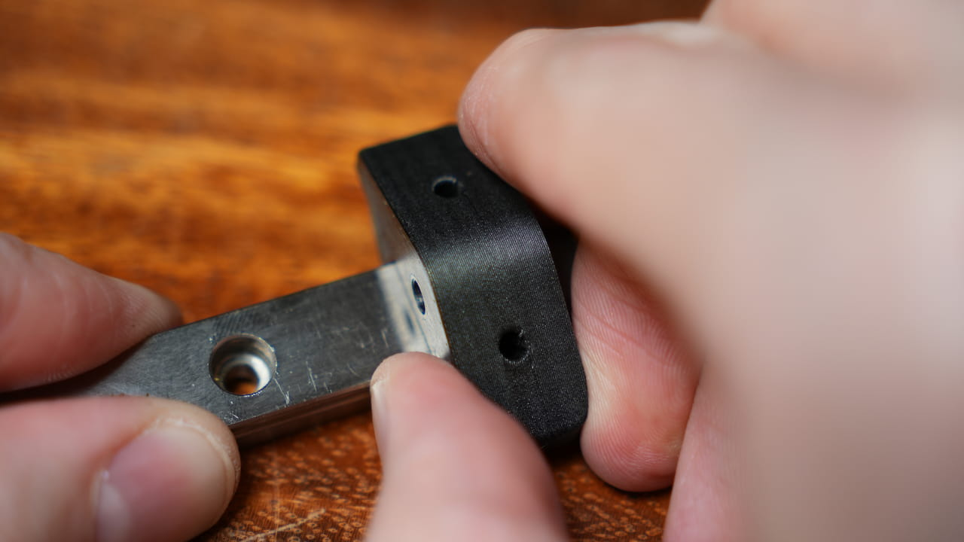
assets/guide/rail---install-tensioner.jpg
