jamesloper/lemontron/assets/guide/rail---tensioner---install-bearings.jpg

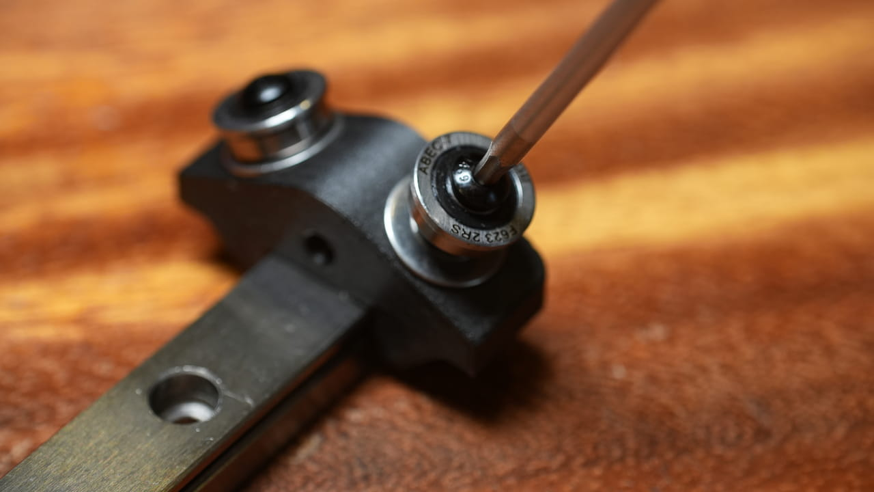
assets/guide/rail---tensioner---install-bearings.jpg
