jamesloper/lemontron/assets/guide/rail---tensioner---posts.jpg

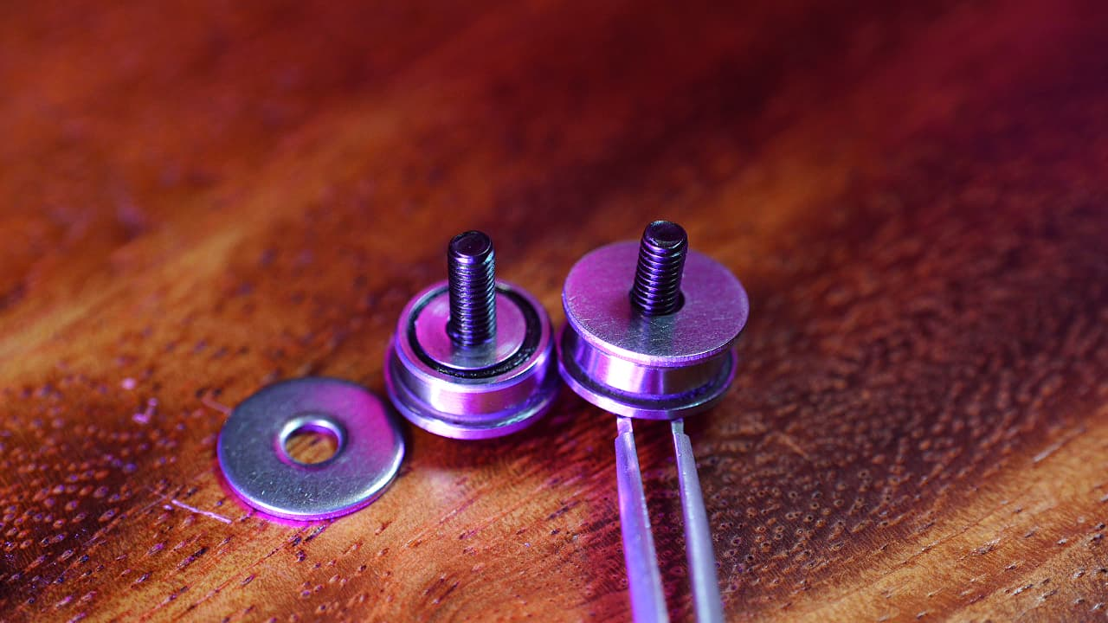
assets/guide/rail---tensioner---posts.jpg
