jamesloper/lemontron/assets/guide/rail---x---add-nuts.jpg

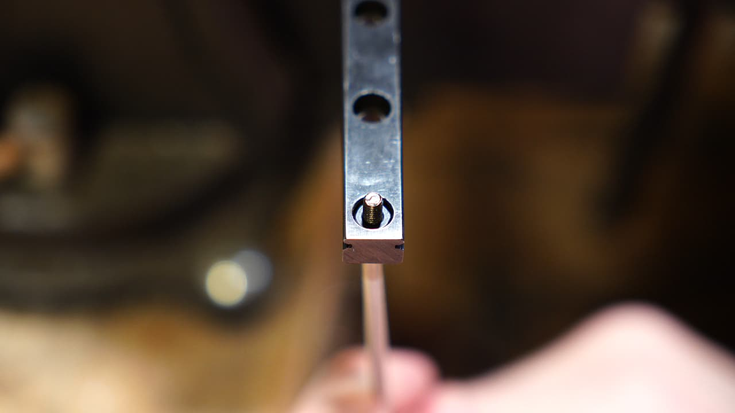
assets/guide/rail---x---add-nuts.jpg
