jamesloper/lemontron/assets/guide/rail---x---bearing-posts.jpg

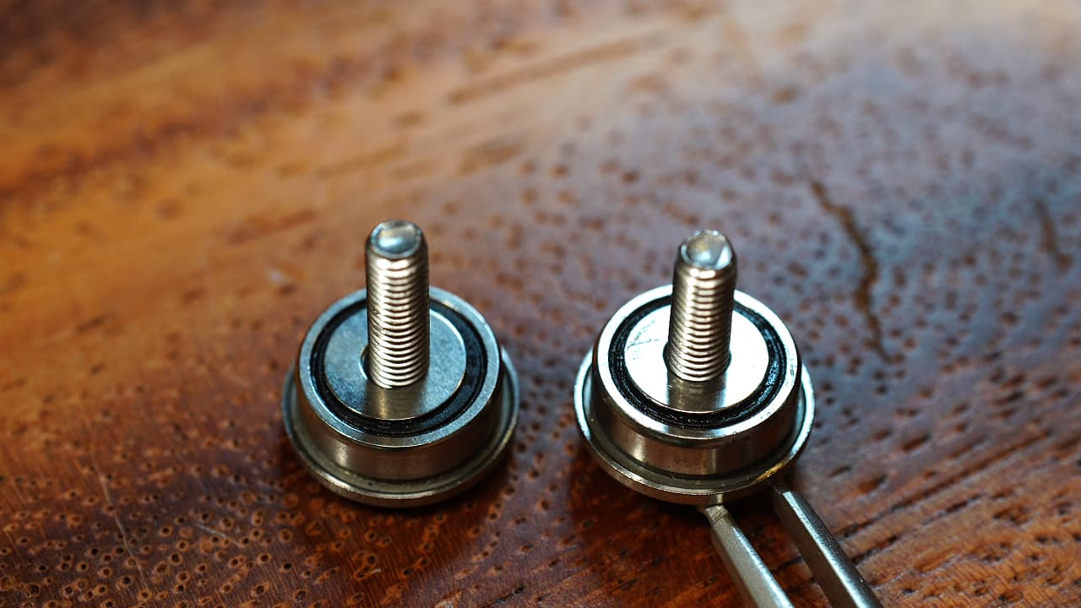
assets/guide/rail---x---bearing-posts.jpg
