jamesloper/lemontron/assets/guide/rail---x---install-bearings.jpg

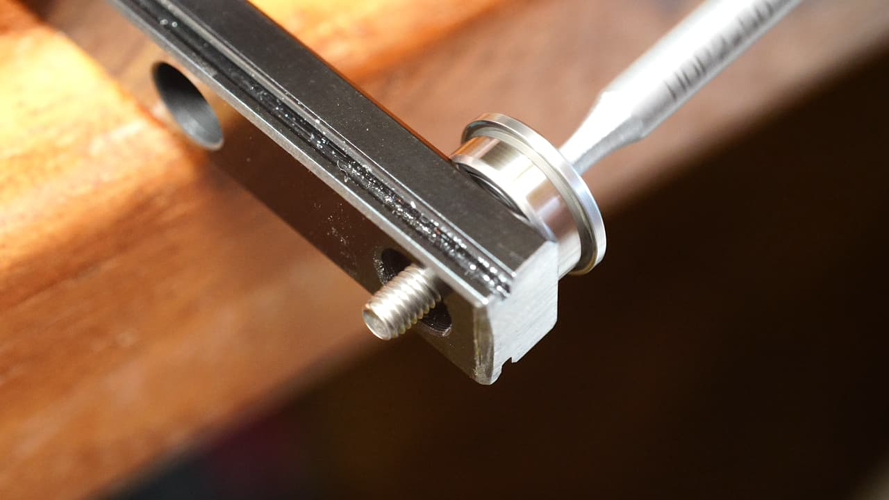
assets/guide/rail---x---install-bearings.jpg
