jamesloper/lemontron/assets/guide/raspberry-pi---solder-serial-connector.jpg

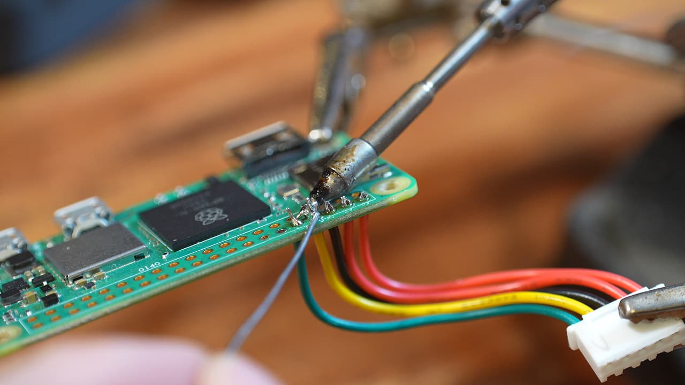
assets/guide/raspberry-pi---solder-serial-connector.jpg
