jamesloper/lemontron/assets/guide/tensioner---screw.jpg

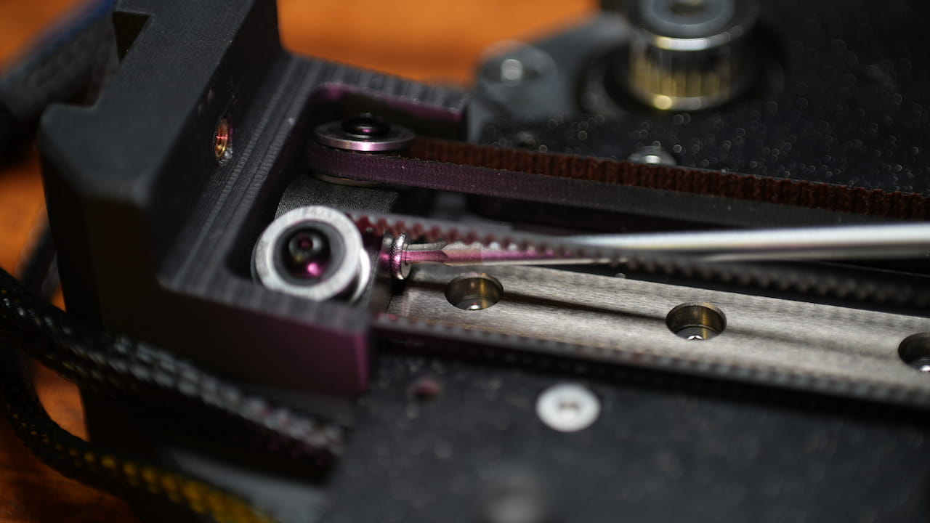
assets/guide/tensioner---screw.jpg
