jamesloper/lemontron/assets/guide/tool---clip-wires.jpg

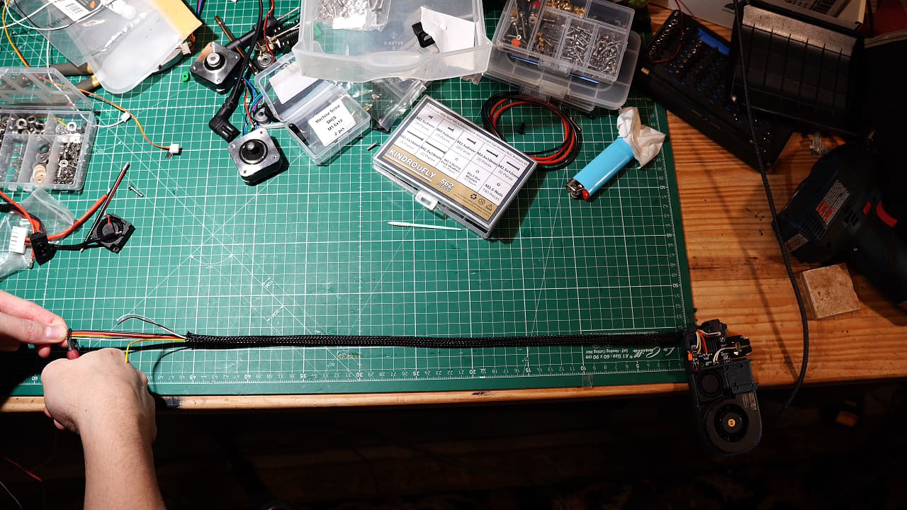
assets/guide/tool---clip-wires.jpg
