jamesloper/lemontron/assets/guide/tool---connector-hotend-fan.jpg

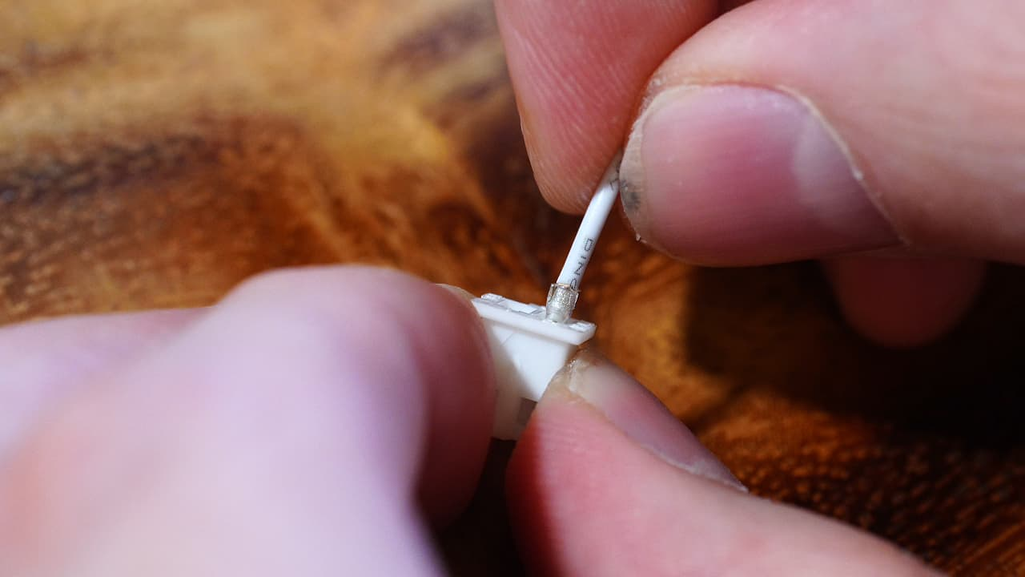
assets/guide/tool---connector-hotend-fan.jpg
