jamesloper/lemontron/assets/guide/tool---connector-part-cooling-fan.jpg

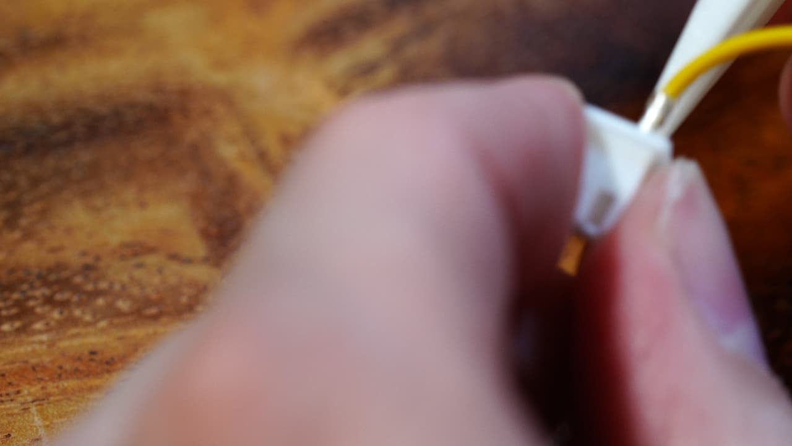
assets/guide/tool---connector-part-cooling-fan.jpg
