jamesloper/lemontron/assets/guide/tool---connector-probe-sensor.jpg

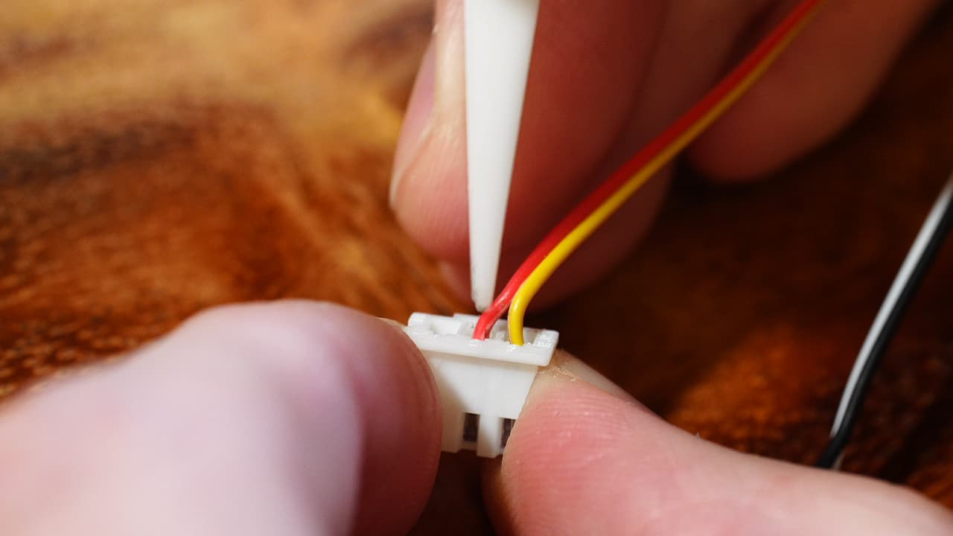
assets/guide/tool---connector-probe-sensor.jpg
