jamesloper/lemontron/assets/guide/tool---connector-probe-servo.jpg

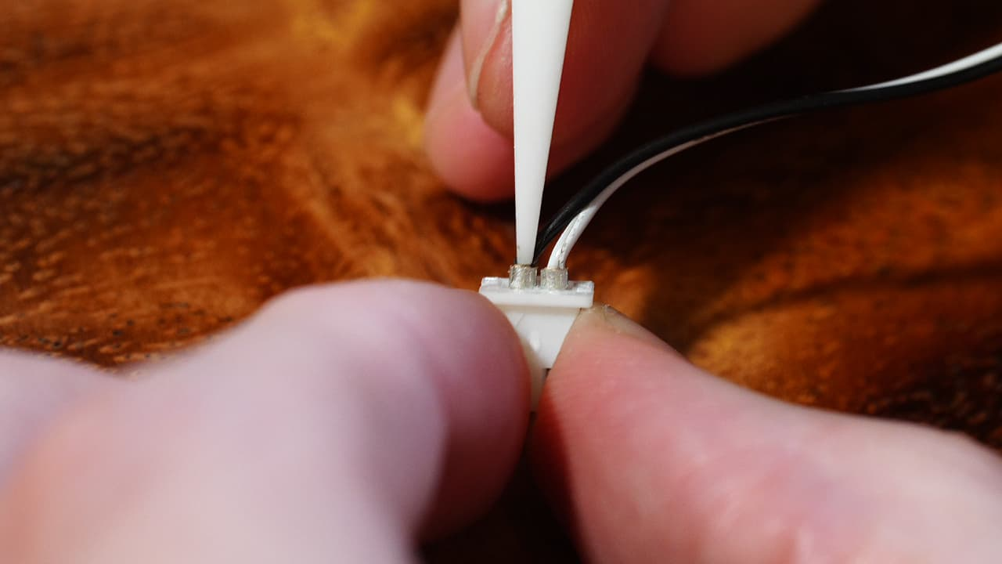
assets/guide/tool---connector-probe-servo.jpg
