jamesloper/lemontron/assets/guide/tool---connector-thermistor.jpg

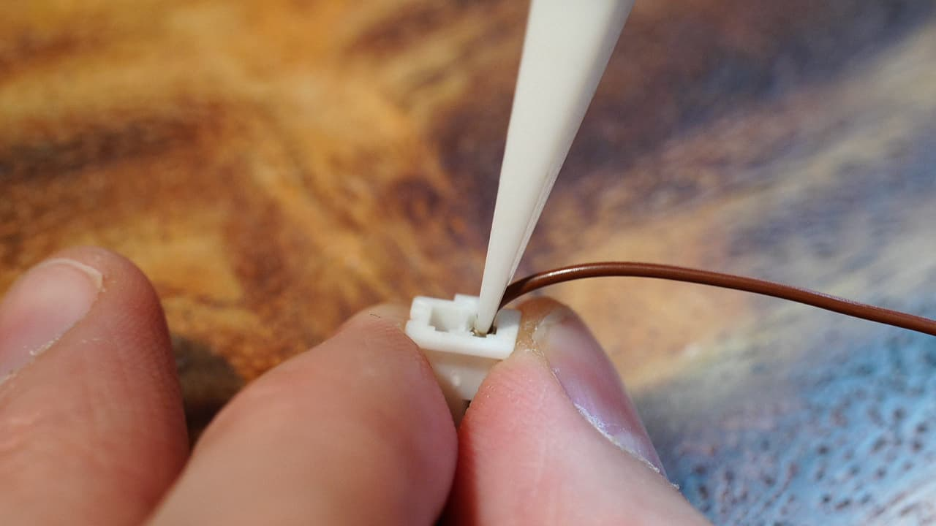
assets/guide/tool---connector-thermistor.jpg
