jamesloper/lemontron/assets/guide/tool---crimps.jpg

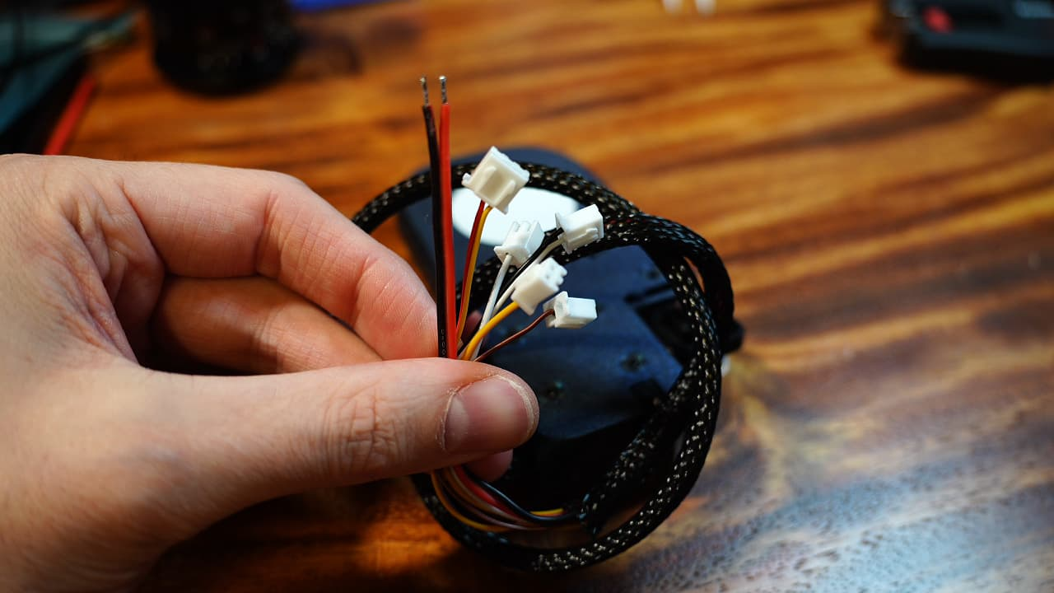
assets/guide/tool---crimps.jpg
