jamesloper/lemontron/assets/guide/tool---fasten-hotend.jpg

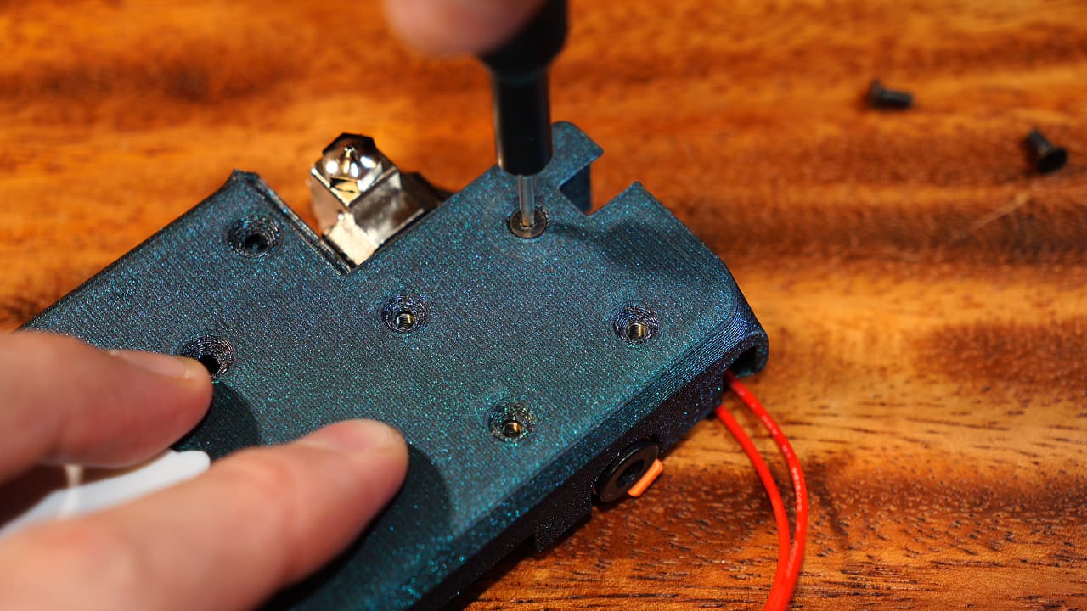
assets/guide/tool---fasten-hotend.jpg
