jamesloper/lemontron/assets/guide/tool---fasten-pcb.jpg

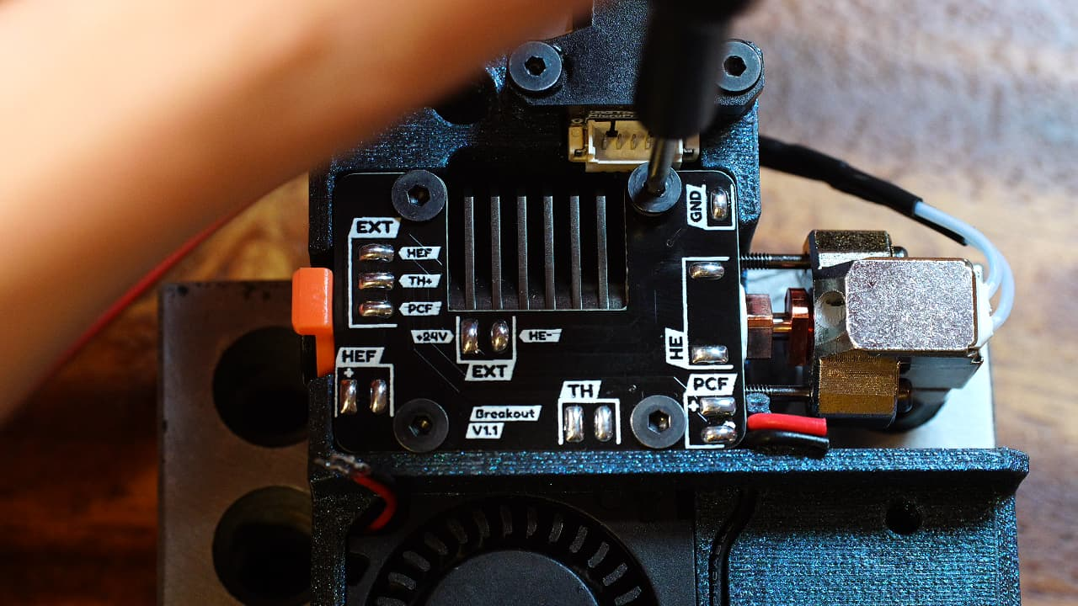
assets/guide/tool---fasten-pcb.jpg
