jamesloper/lemontron/assets/guide/tool---fasten-probe.jpg

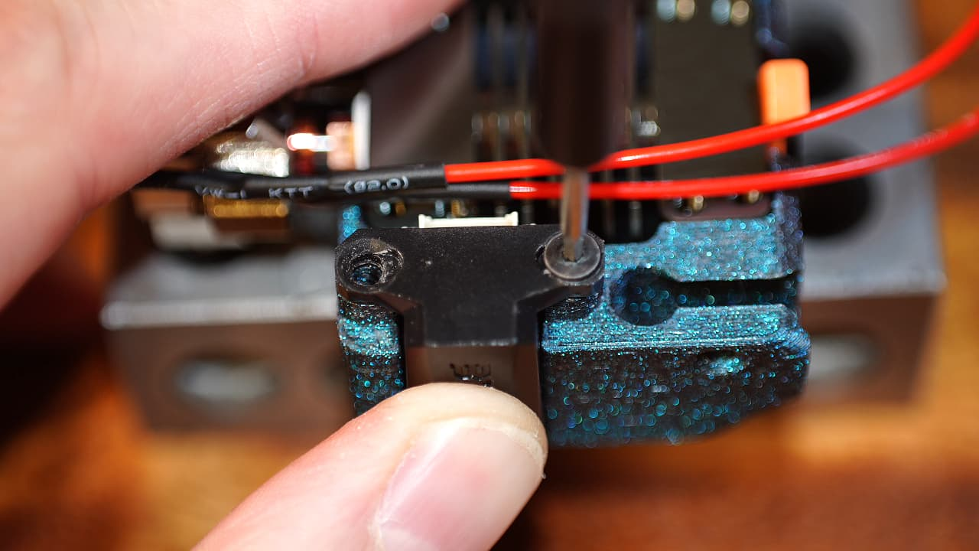
assets/guide/tool---fasten-probe.jpg
