jamesloper/lemontron/assets/guide/tool---insert-clamp.jpg

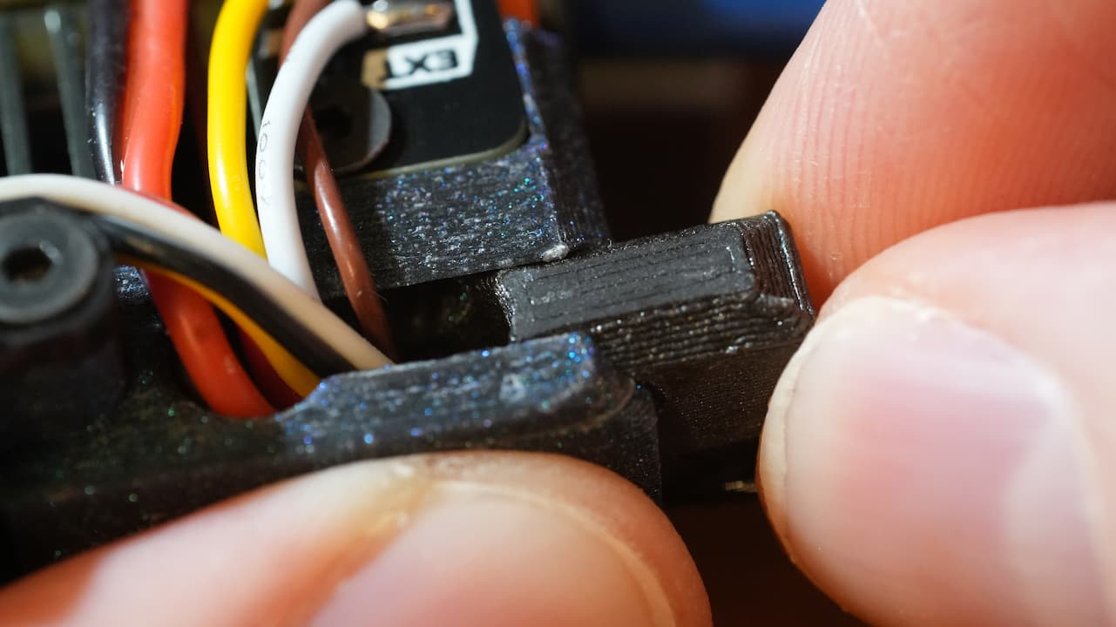
assets/guide/tool---insert-clamp.jpg
