jamesloper/lemontron/assets/guide/tool---insert-hotend.jpg

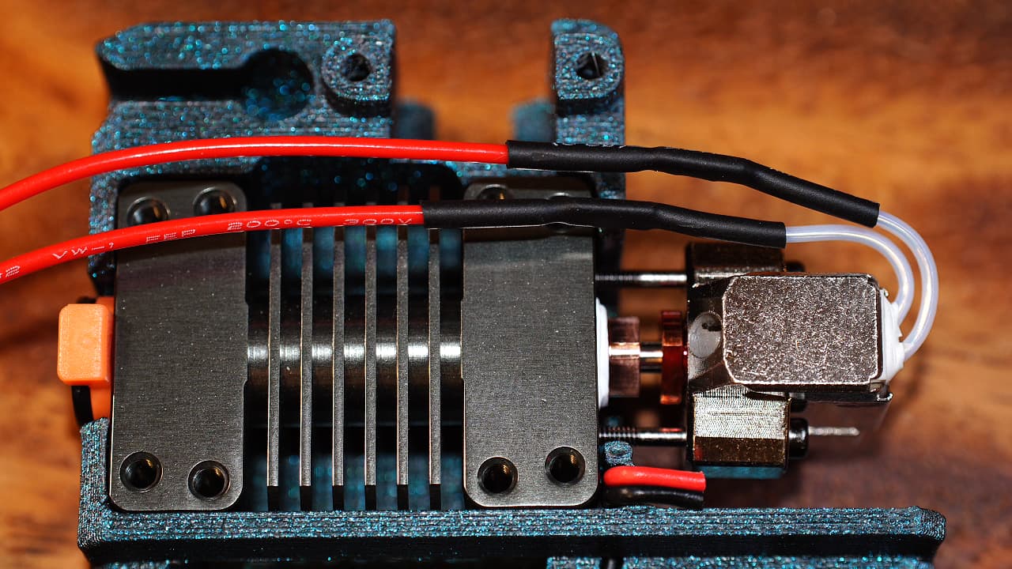
assets/guide/tool---insert-hotend.jpg
