jamesloper/lemontron/assets/guide/tool---insert-small-fan.jpg

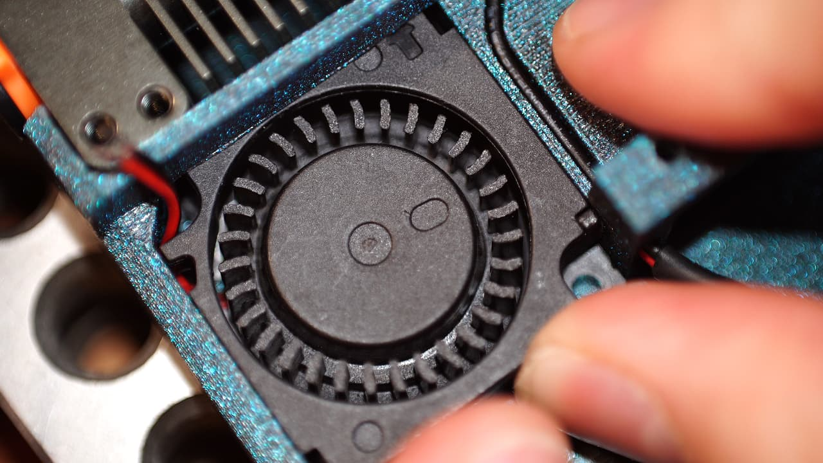
assets/guide/tool---insert-small-fan.jpg
