jamesloper/lemontron/assets/guide/tool---insert-wires.jpg

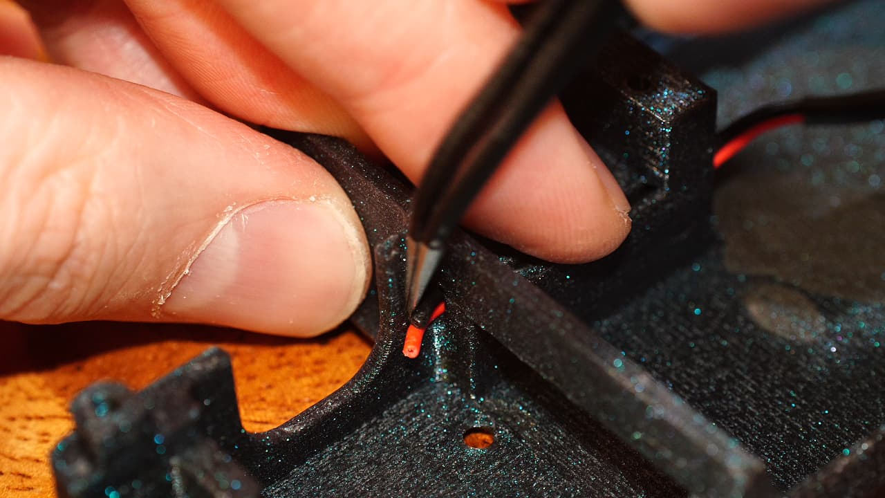
assets/guide/tool---insert-wires.jpg
