jamesloper/lemontron/assets/guide/tool---seat-part-cooling-fan.jpg

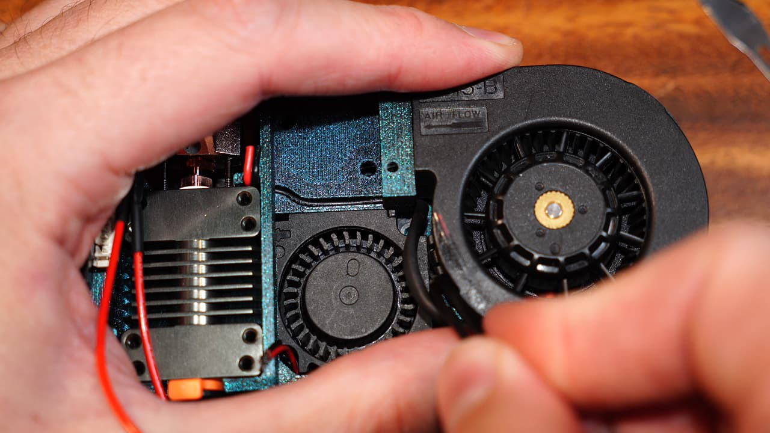
assets/guide/tool---seat-part-cooling-fan.jpg
