jamesloper/lemontron/assets/guide/tool---shorten-thermistor.jpg

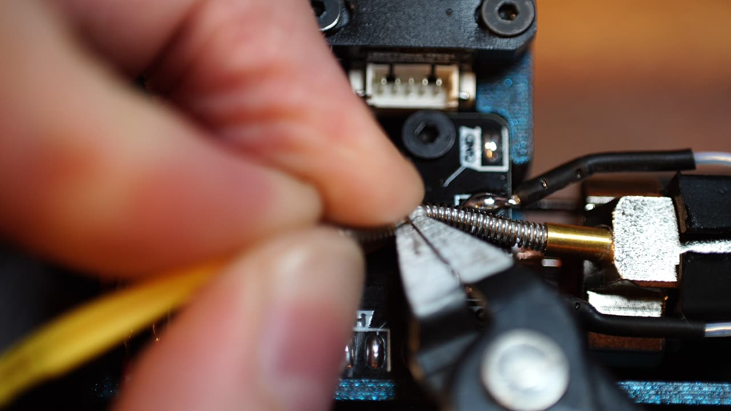
assets/guide/tool---shorten-thermistor.jpg
