jamesloper/lemontron/assets/guide/tool---solder-ext-fan-wires.jpg

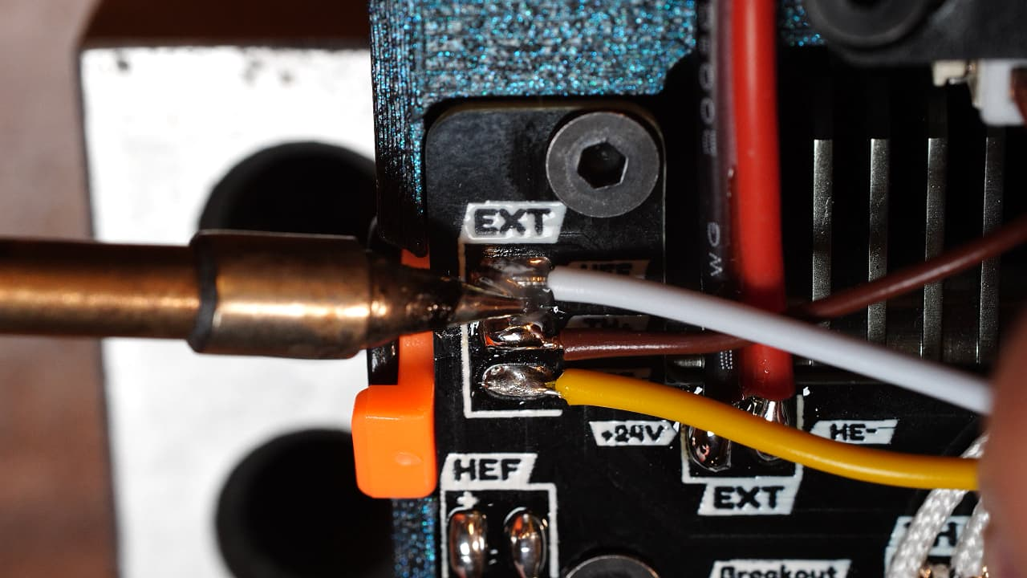
assets/guide/tool---solder-ext-fan-wires.jpg
