jamesloper/lemontron/assets/guide/tool---solder-ext-heater.jpg

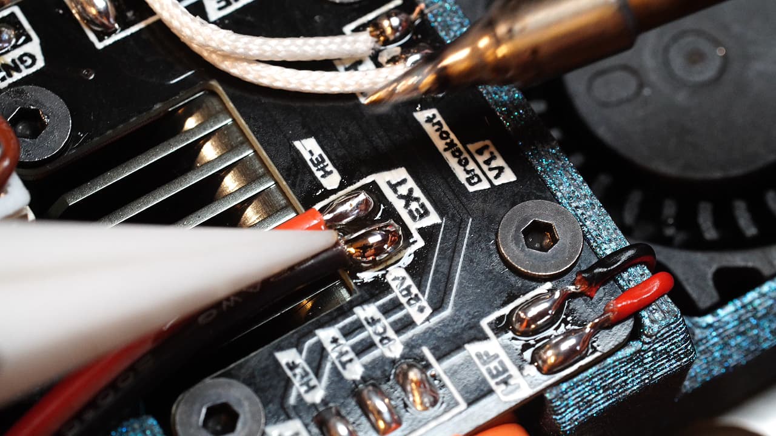
assets/guide/tool---solder-ext-heater.jpg
