jamesloper/lemontron/assets/guide/tool---solder-ext-thermistor.jpg

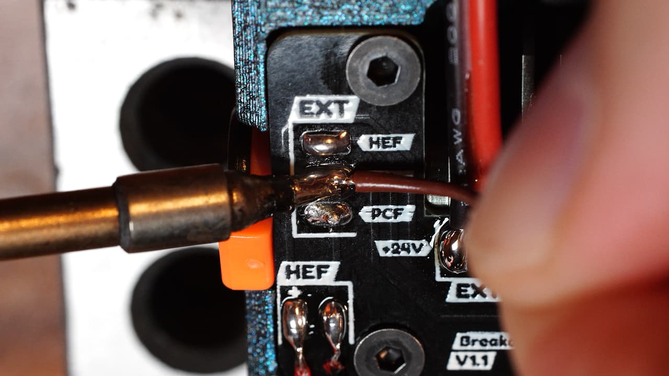
assets/guide/tool---solder-ext-thermistor.jpg
