jamesloper/lemontron/assets/guide/tool---solder-heater.jpg

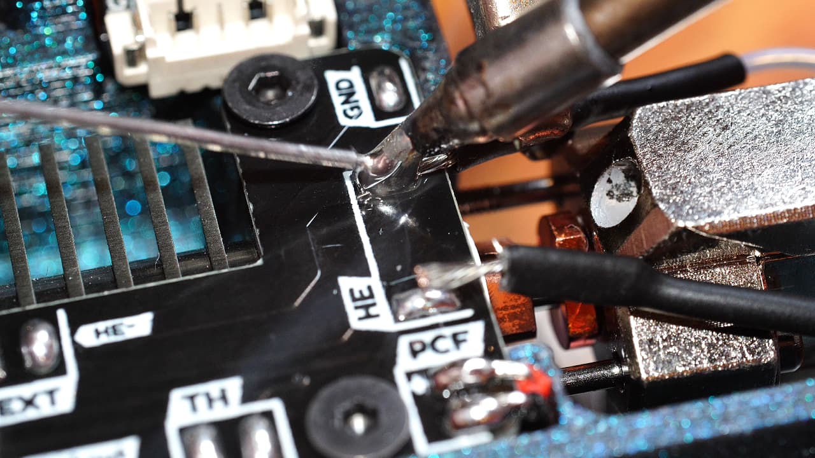
assets/guide/tool---solder-heater.jpg
