jamesloper/lemontron/assets/guide/tool---solder-hotend-fan.jpg

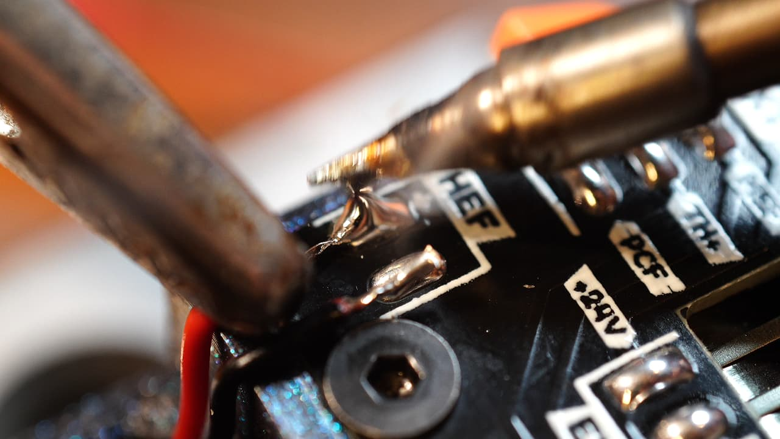
assets/guide/tool---solder-hotend-fan.jpg
