jamesloper/lemontron/assets/guide/tool---solder-part-cooling-fan.jpg

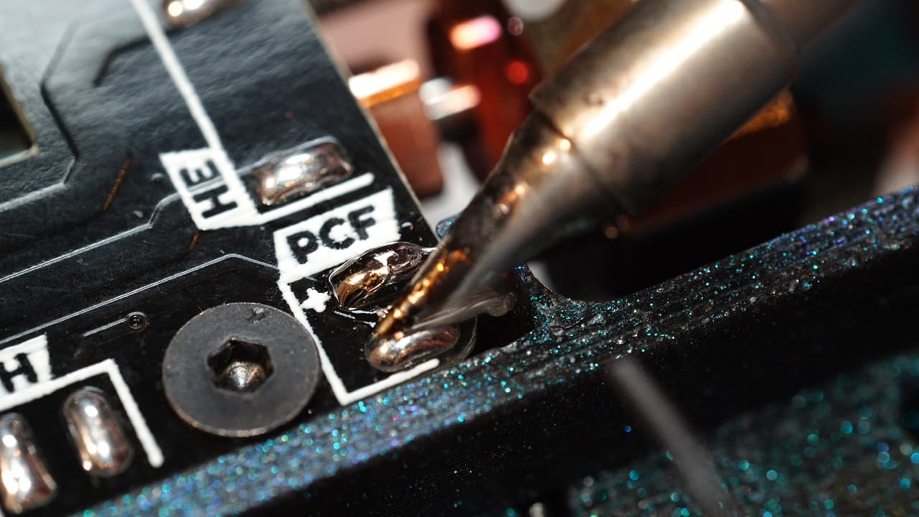
assets/guide/tool---solder-part-cooling-fan.jpg
