jamesloper/lemontron/assets/guide/tool---solder-probe-wires.jpg

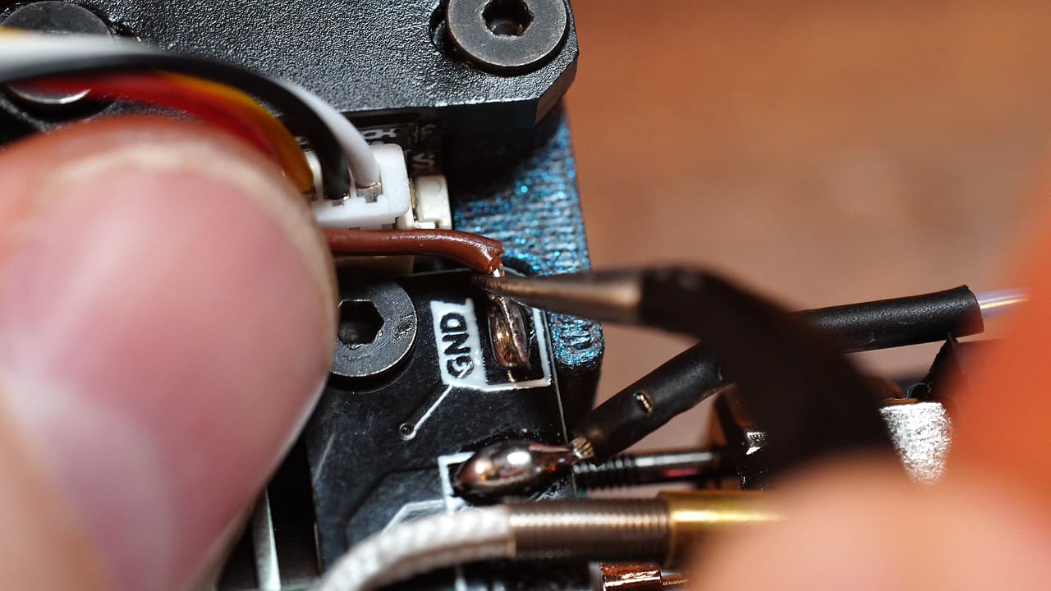
assets/guide/tool---solder-probe-wires.jpg
