jamesloper/lemontron/assets/guide/tool---solder-thermistor.jpg

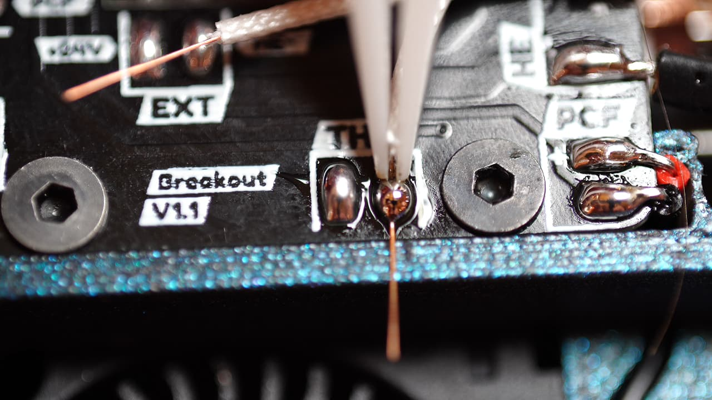
assets/guide/tool---solder-thermistor.jpg
