jamesloper/lemontron/assets/guide/tool---tin-heater-wires.jpg

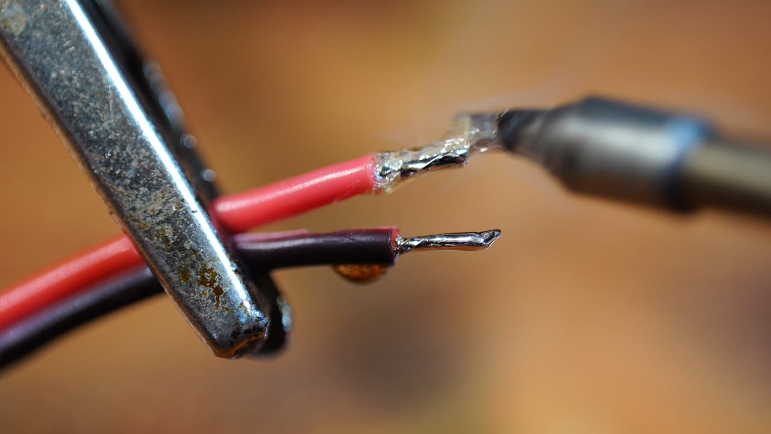
assets/guide/tool---tin-heater-wires.jpg
