jamesloper/lemontron/assets/guide/tool---tin-pcb.jpg

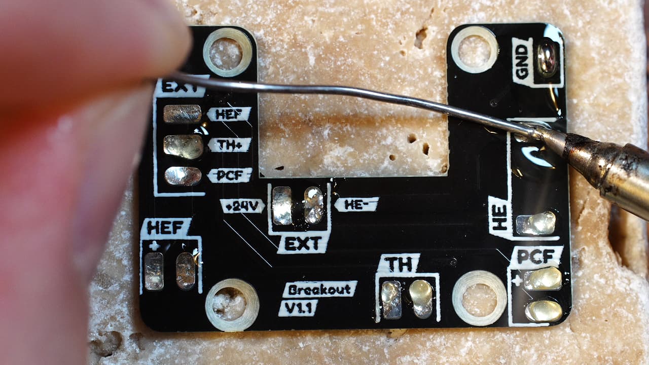
assets/guide/tool---tin-pcb.jpg
