jamesloper/lemontron/assets/guide/tool---wire-sleeve.jpg

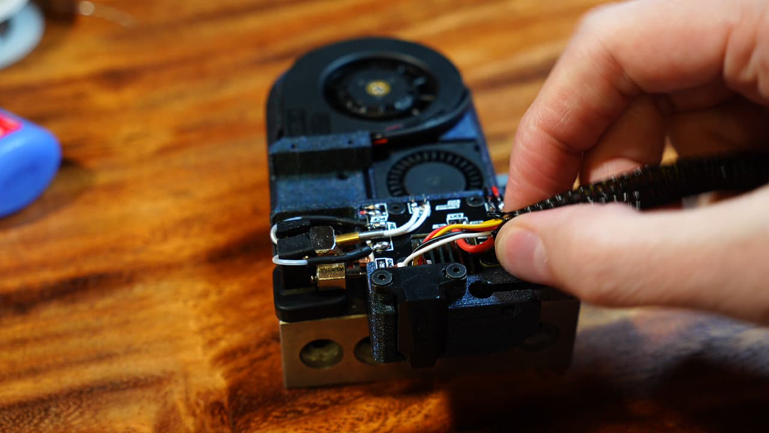
assets/guide/tool---wire-sleeve.jpg
