jamesloper/lemontron/assets/guide/tool.jpg

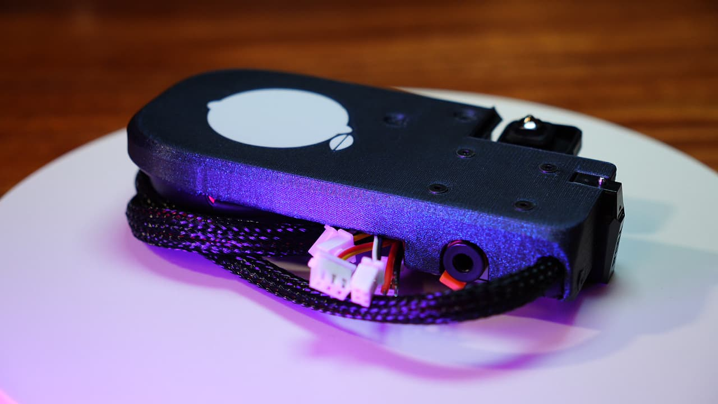
assets/guide/tool.jpg
