jamesloper/lemontron/assets/guide/top-plates---inner-screws.jpg

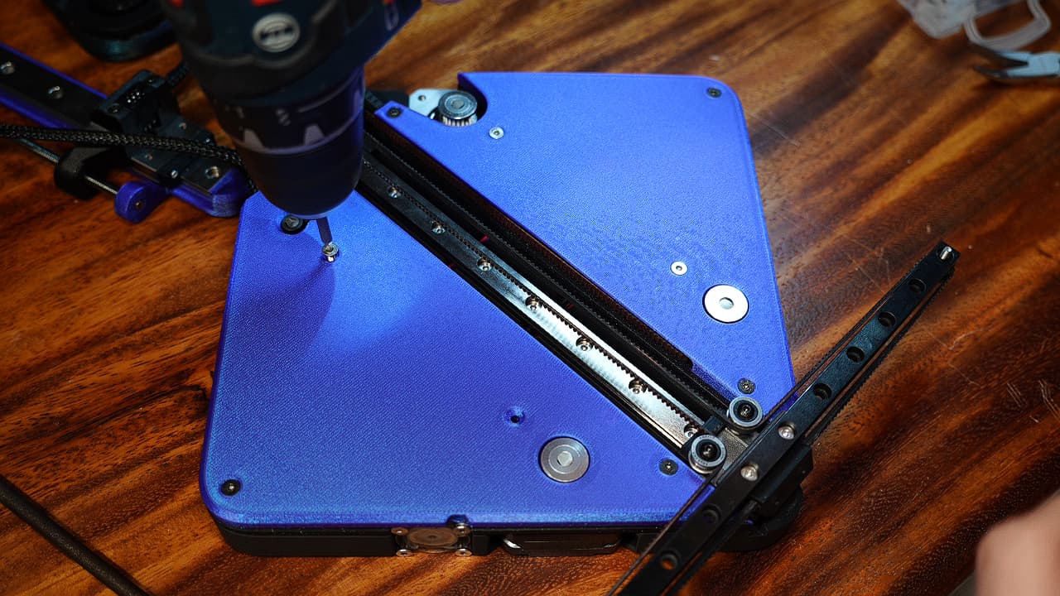
assets/guide/top-plates---inner-screws.jpg
