jamesloper/lemontron/assets/guide/top-plates---install.jpg

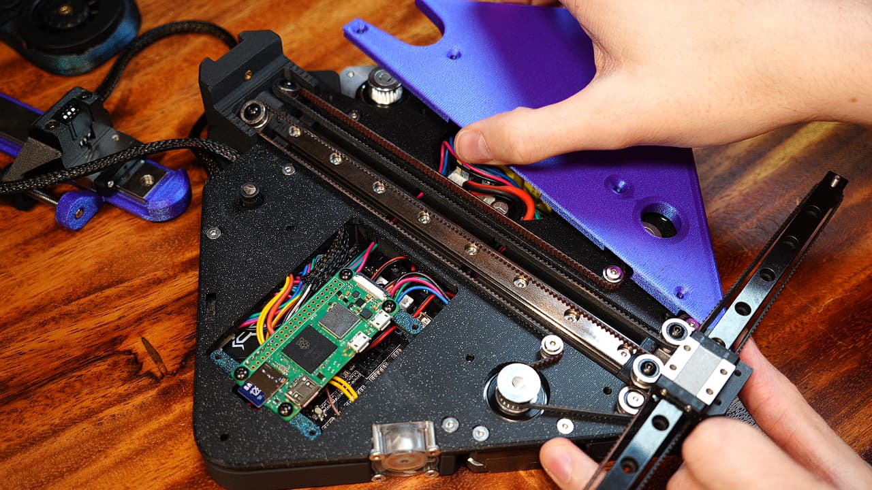
assets/guide/top-plates---install.jpg
