jamesloper/lemontron/assets/guide/top-plates---outer-screws.jpg

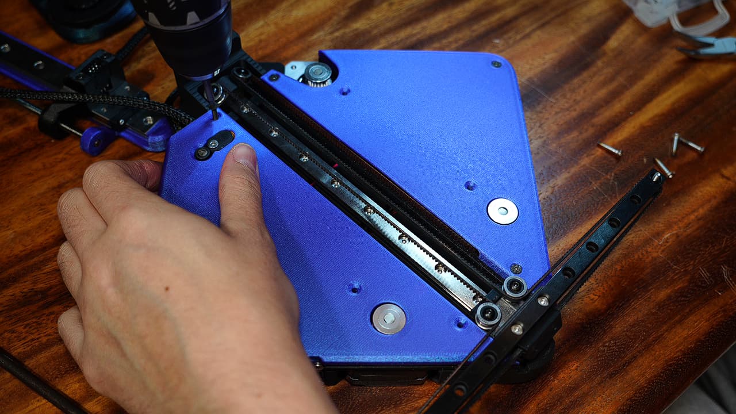
assets/guide/top-plates---outer-screws.jpg
