jamesloper/lemontron/assets/guide/z-axis---add-bracket.jpg

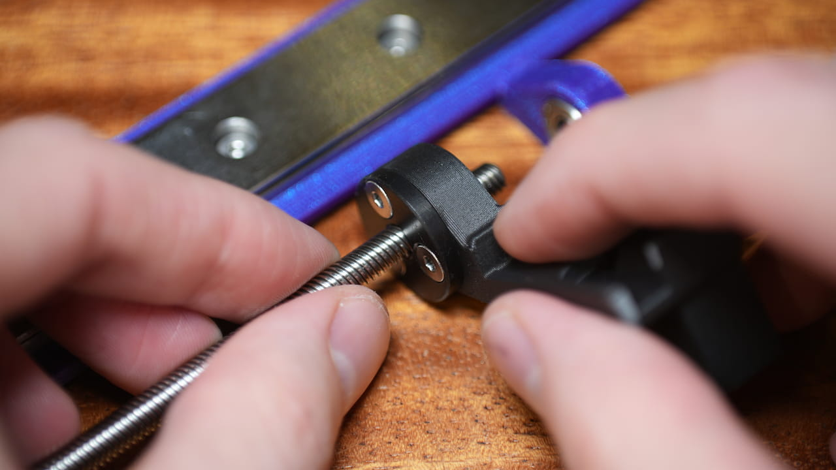
assets/guide/z-axis---add-bracket.jpg
