jamesloper/lemontron/assets/guide/z-axis---bracket---glue.jpg

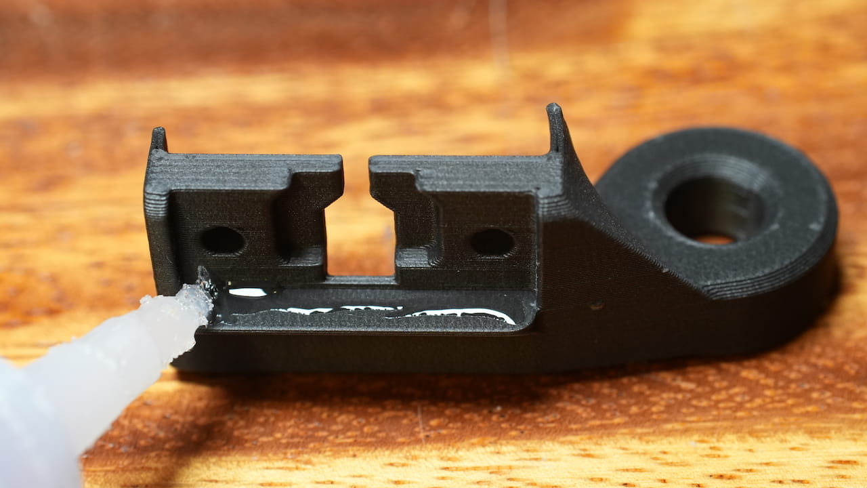
assets/guide/z-axis---bracket---glue.jpg
