jamesloper/lemontron/assets/guide/z-axis---bracket---press.jpg

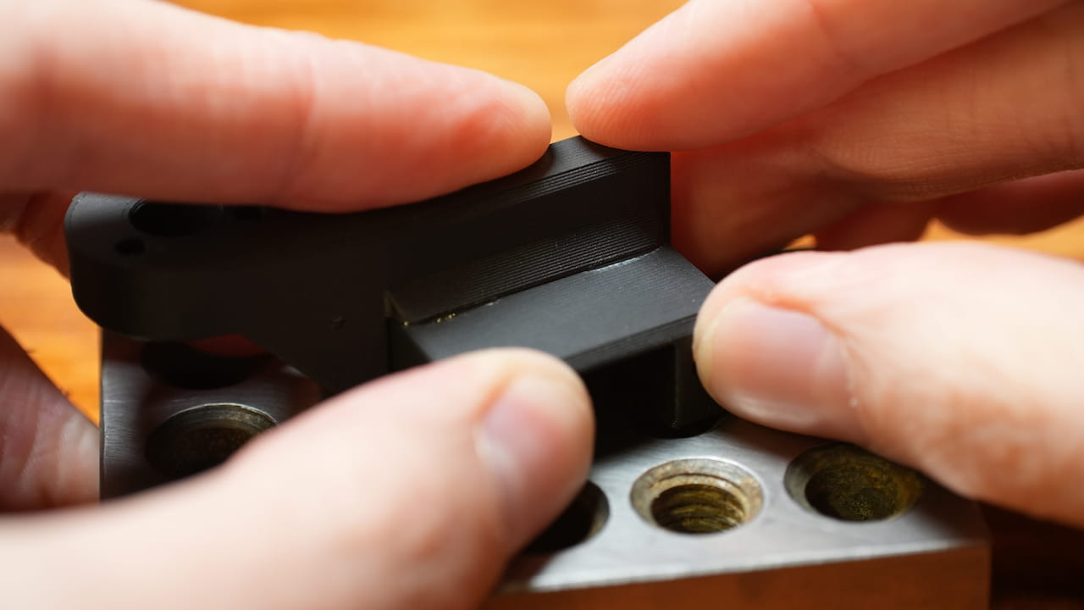
assets/guide/z-axis---bracket---press.jpg
