jamesloper/lemontron/assets/guide/z-axis---bracket---remove-support.jpg

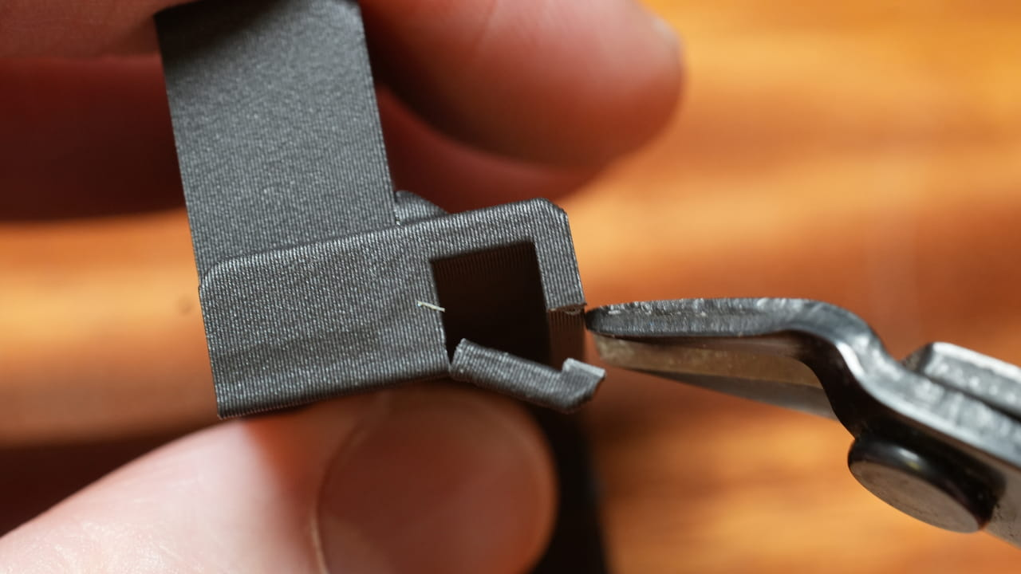
assets/guide/z-axis---bracket---remove-support.jpg
