jamesloper/lemontron/assets/guide/z-axis---cut-lead-screw.jpg

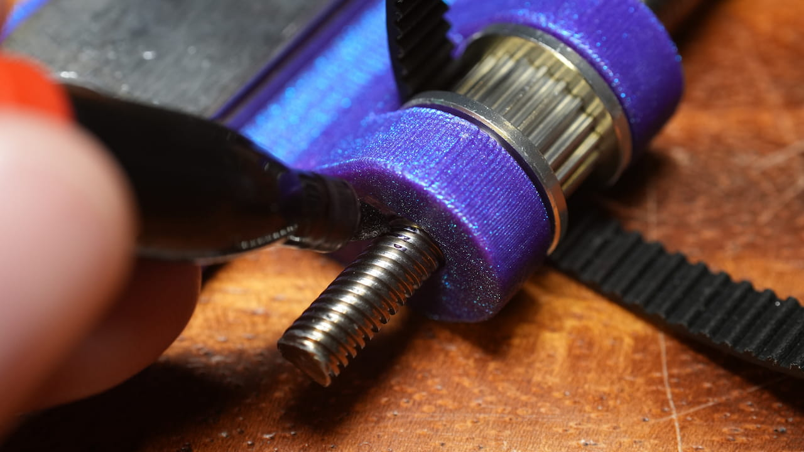
assets/guide/z-axis---cut-lead-screw.jpg
