jamesloper/lemontron/assets/guide/z-axis---drive-pulley.jpg

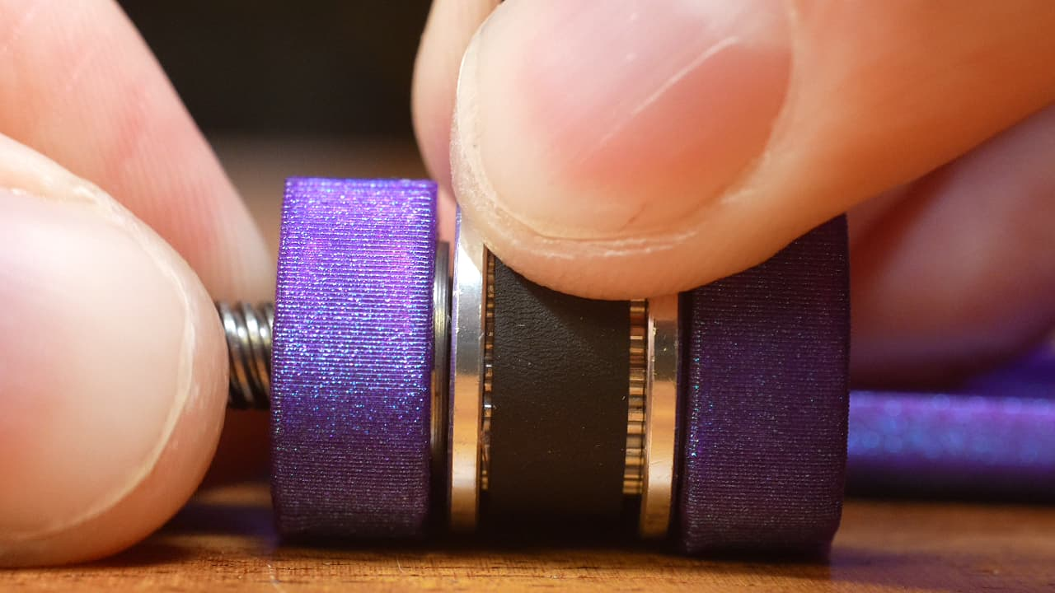
assets/guide/z-axis---drive-pulley.jpg
