jamesloper/lemontron/assets/guide/z-axis---edge-connector---crimp-signal-wires.jpg

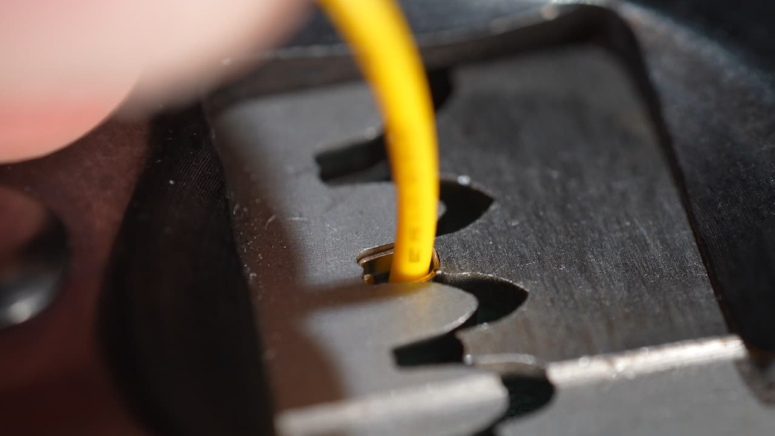
assets/guide/z-axis---edge-connector---crimp-signal-wires.jpg
