jamesloper/lemontron/assets/guide/z-axis---edge-connector---cut-wires.jpg

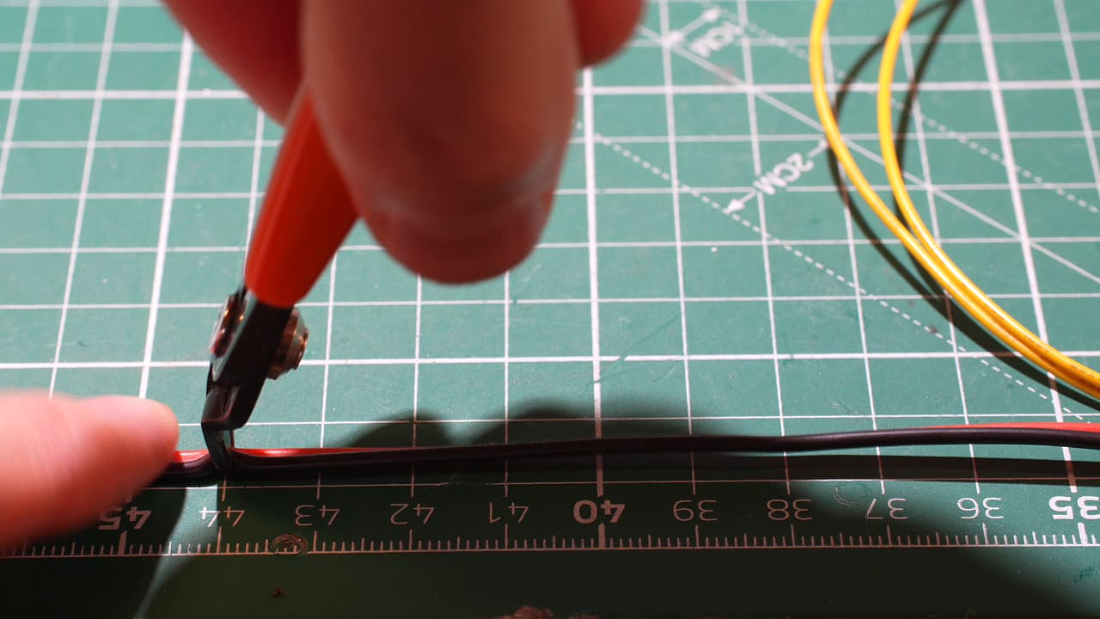
assets/guide/z-axis---edge-connector---cut-wires.jpg
