jamesloper/lemontron/assets/guide/z-axis---edge-connector---insert-connector.jpg

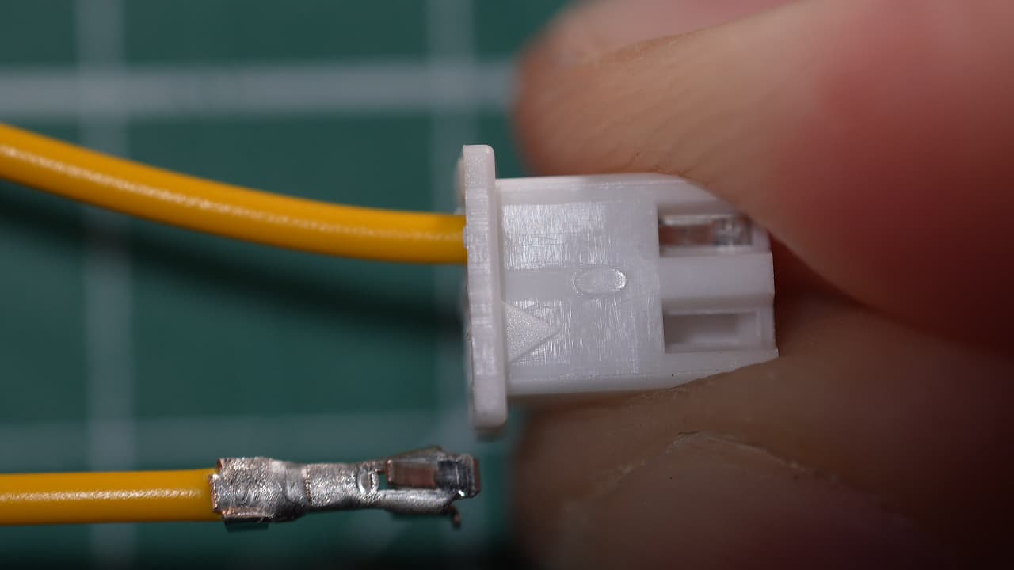
assets/guide/z-axis---edge-connector---insert-connector.jpg
