jamesloper/lemontron/assets/guide/z-axis---edge-connector---power-wires.jpg

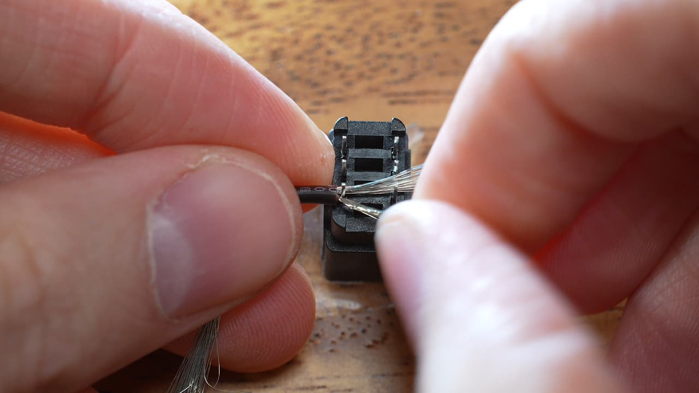
assets/guide/z-axis---edge-connector---power-wires.jpg
