jamesloper/lemontron/assets/guide/z-axis---edge-connector---signal-wires.jpg

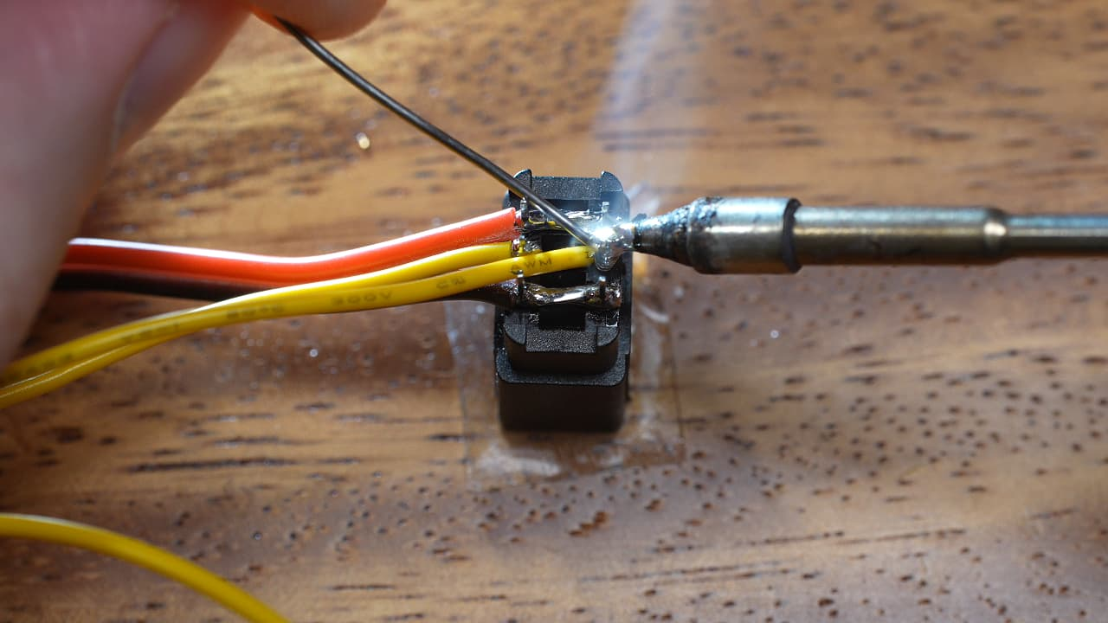
assets/guide/z-axis---edge-connector---signal-wires.jpg
