jamesloper/lemontron/assets/guide/z-axis---edge-connector---sleeve.jpg

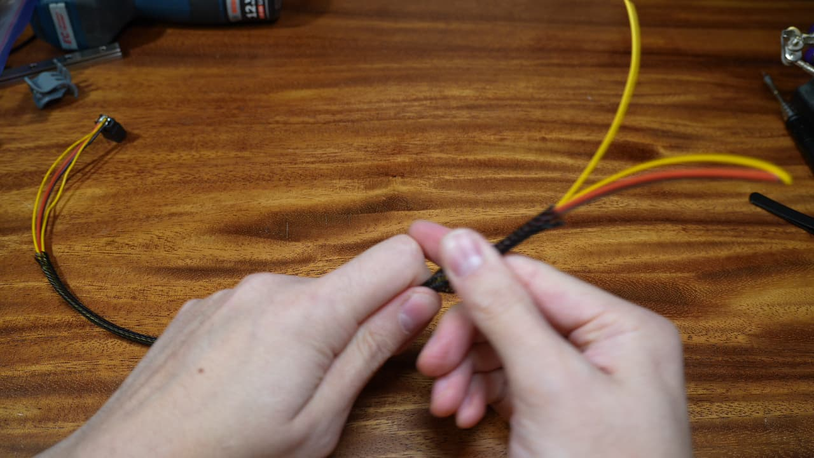
assets/guide/z-axis---edge-connector---sleeve.jpg
