jamesloper/lemontron/assets/guide/z-axis---edge-connector---strip-power-wires.jpg

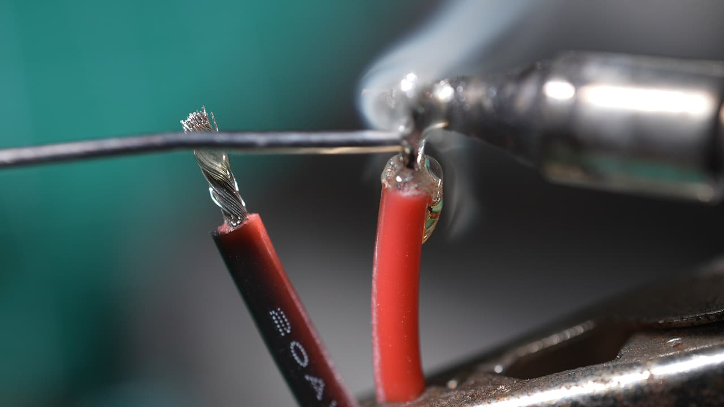
assets/guide/z-axis---edge-connector---strip-power-wires.jpg
