jamesloper/lemontron/assets/guide/z-axis---edge-connector.jpg

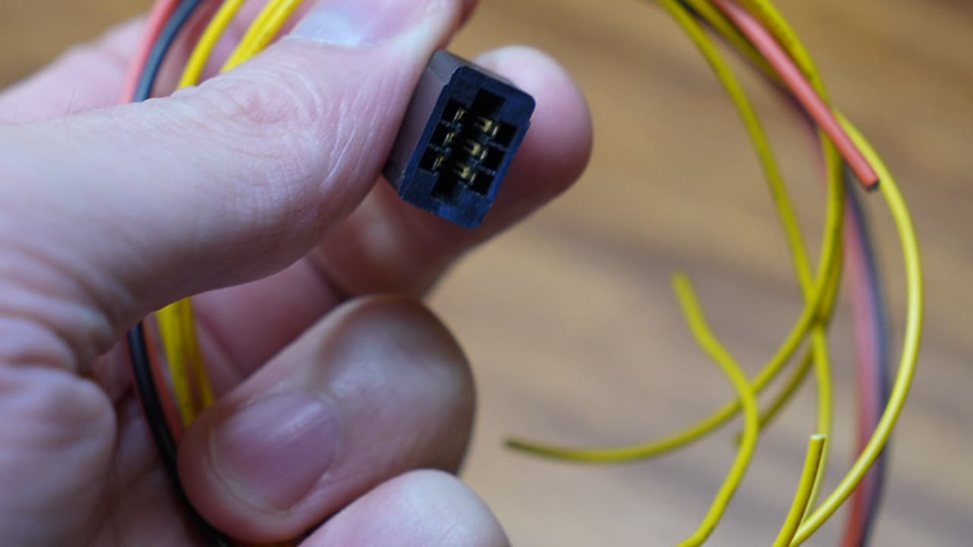
assets/guide/z-axis---edge-connector.jpg
