jamesloper/lemontron/assets/guide/z-axis---first-shim.jpg

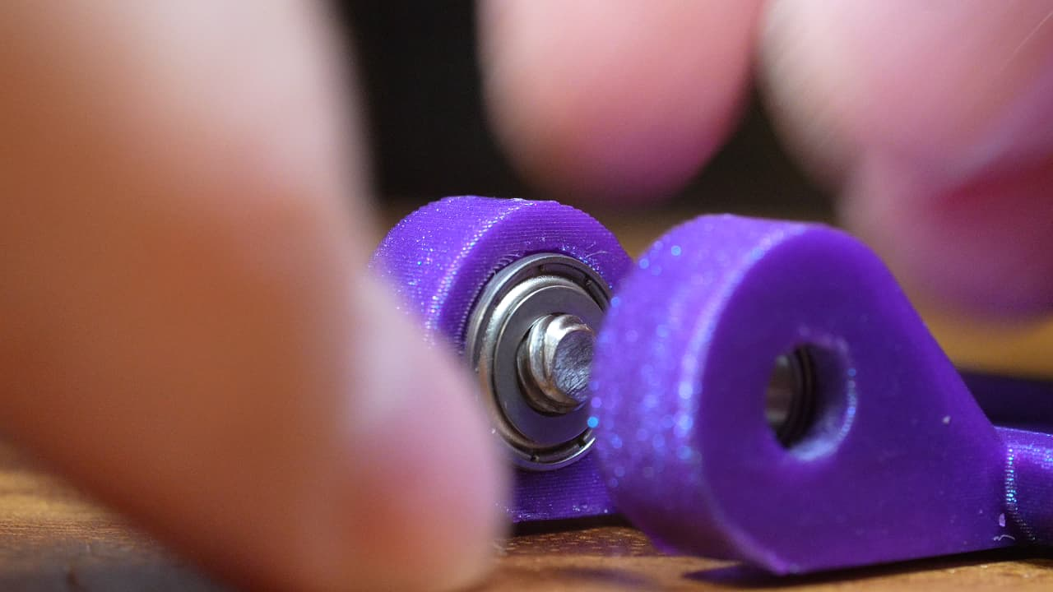
assets/guide/z-axis---first-shim.jpg
