jamesloper/lemontron/assets/guide/z-axis---insert-bearings.jpg

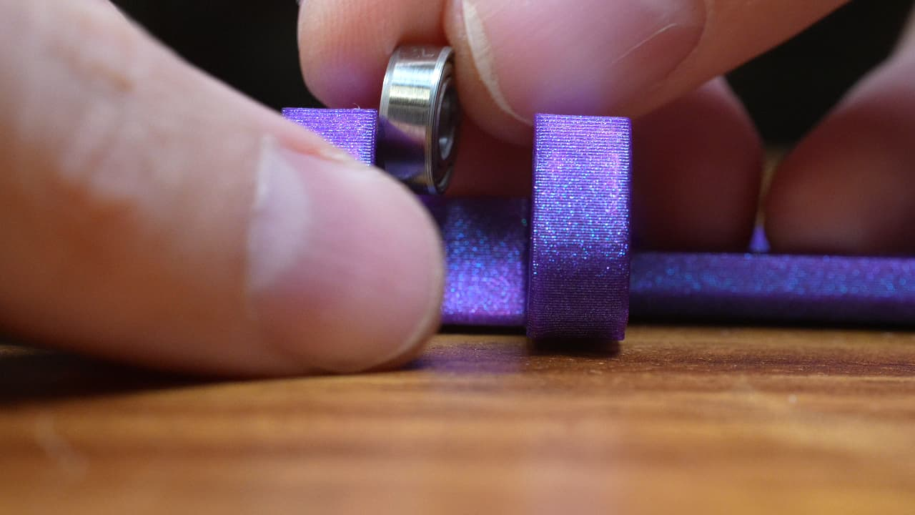
assets/guide/z-axis---insert-bearings.jpg
