jamesloper/lemontron/assets/guide/z-axis---insert-lead-nut.jpg

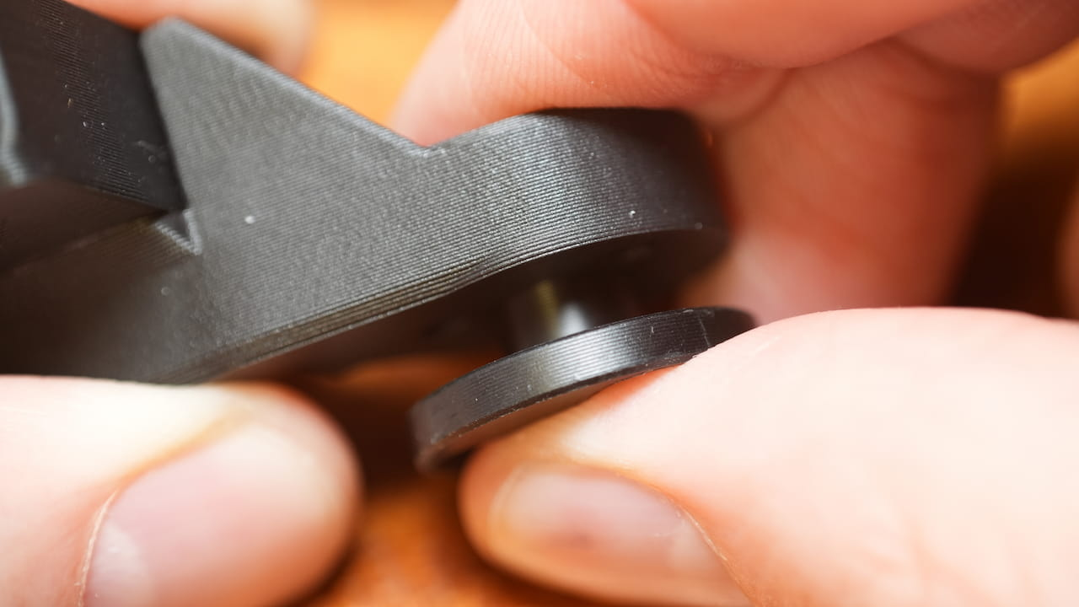
assets/guide/z-axis---insert-lead-nut.jpg
