jamesloper/lemontron/assets/guide/z-axis---install-edge-connector.jpg

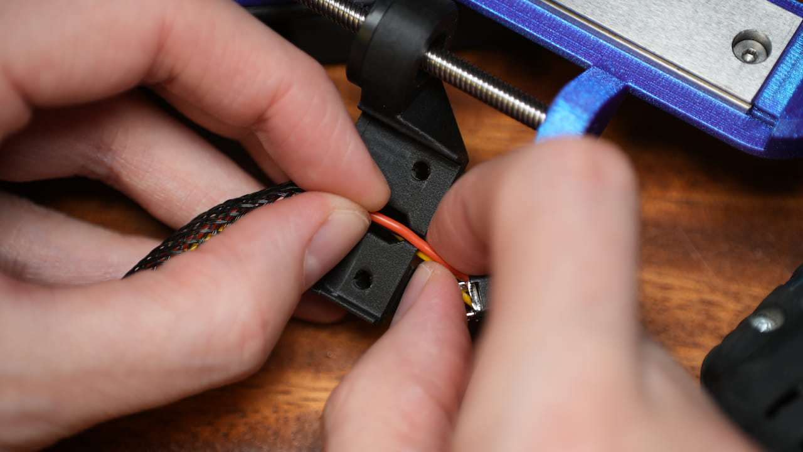
assets/guide/z-axis---install-edge-connector.jpg
