jamesloper/lemontron/assets/guide/z-axis---install-rail.jpg

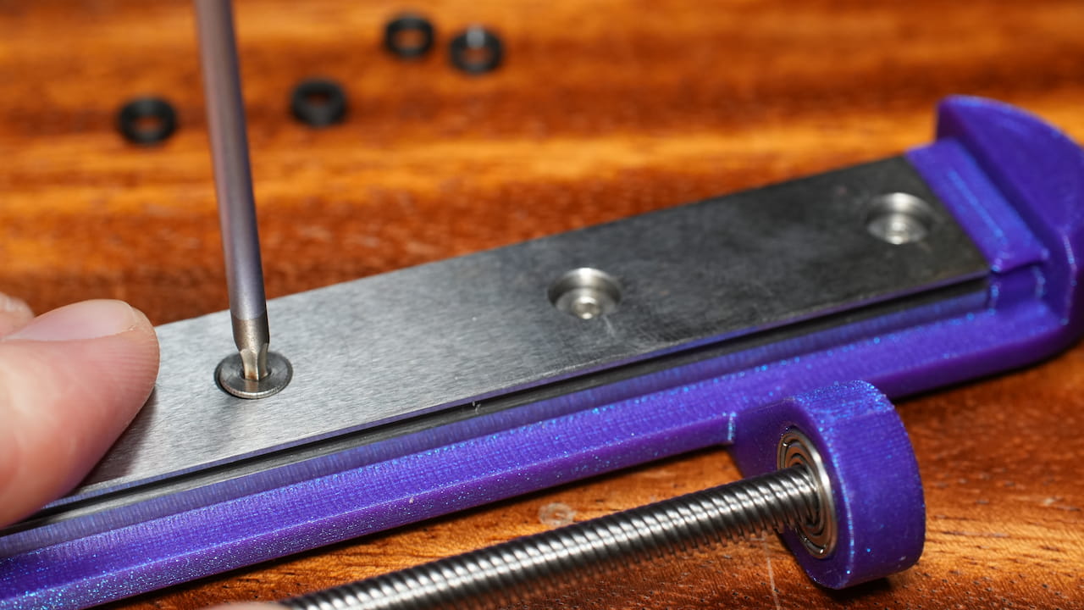
assets/guide/z-axis---install-rail.jpg
