jamesloper/lemontron/assets/guide/z-axis---lead-screw.jpg

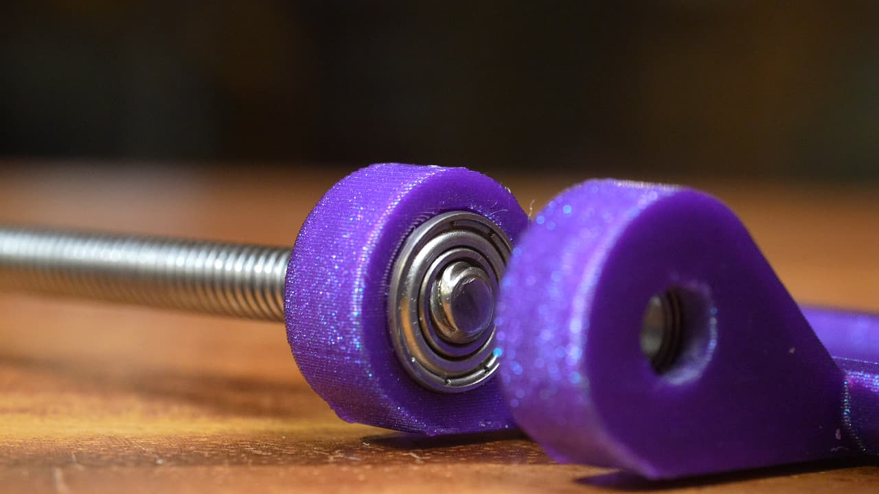
assets/guide/z-axis---lead-screw.jpg
