jamesloper/lemontron/assets/guide/z-axis---screw-lead-nut.jpg

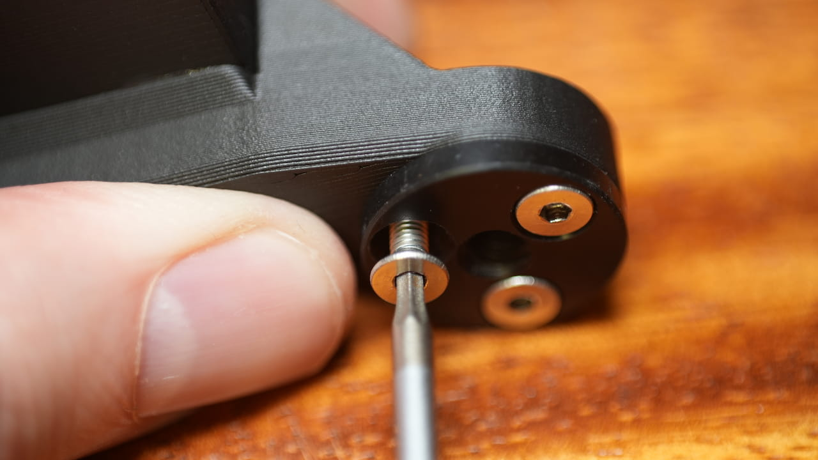
assets/guide/z-axis---screw-lead-nut.jpg
