jamesloper/lemontron/assets/guide/z-axis---second-shim.jpg

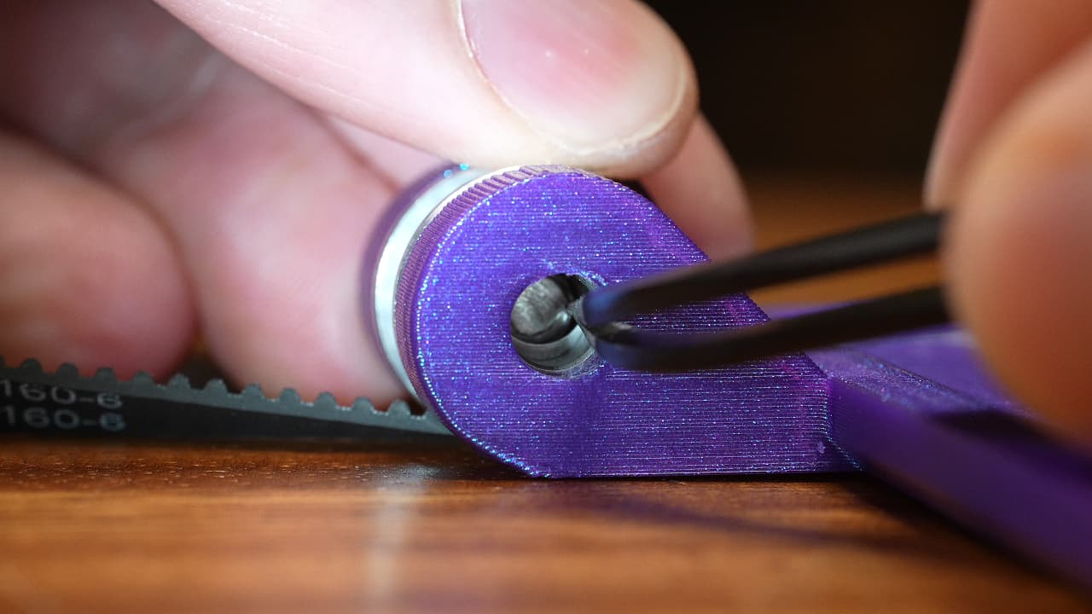
assets/guide/z-axis---second-shim.jpg
