jamesloper/lemontron/assets/guide/z-axis---spacers.jpg

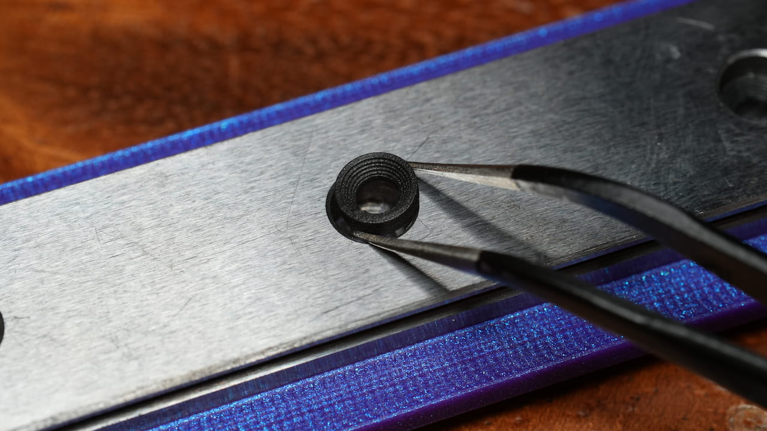
assets/guide/z-axis---spacers.jpg
