jamesloper/lemontron/assets/guide/z-axis---tighten-bracket.jpg

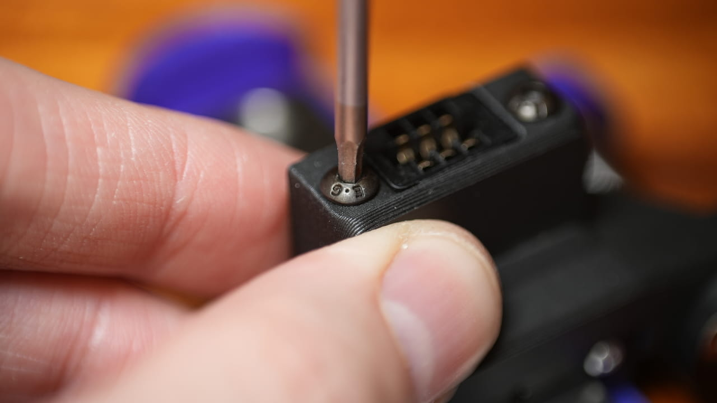
assets/guide/z-axis---tighten-bracket.jpg
