jamesloper/lemontron/assets/guide/z-axis---tighten-grub-screws.jpg

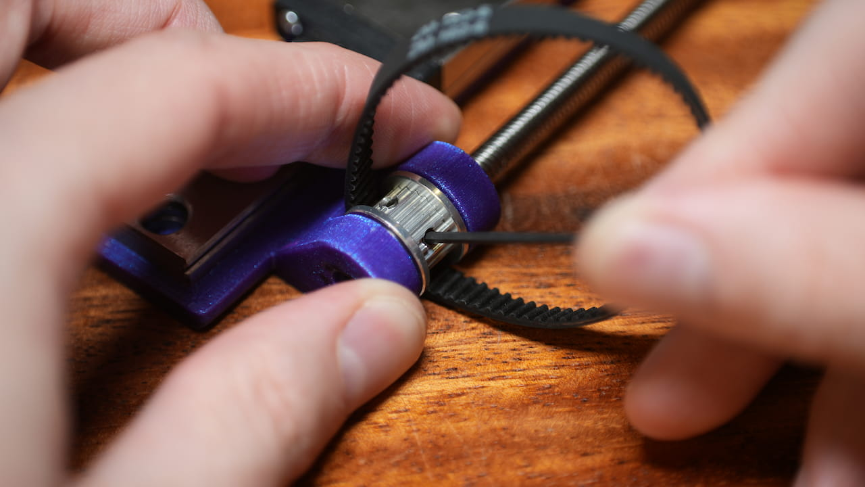
assets/guide/z-axis---tighten-grub-screws.jpg
