jamesloper/lemontron/assets/guide/belt-route---test.jpg

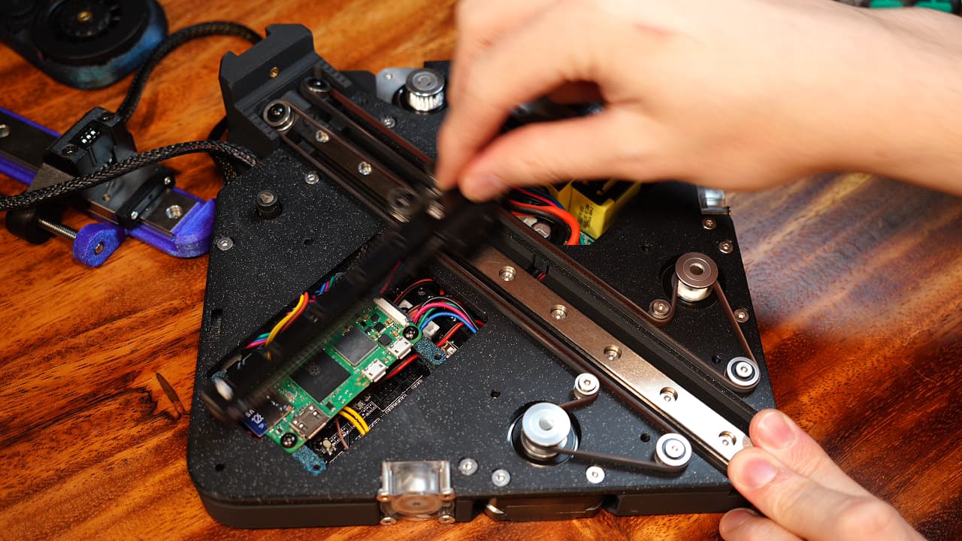
assets/guide/belt-route---test.jpg
