jamesloper/lemontron/assets/guide/calibration---adjust-screw.jpg

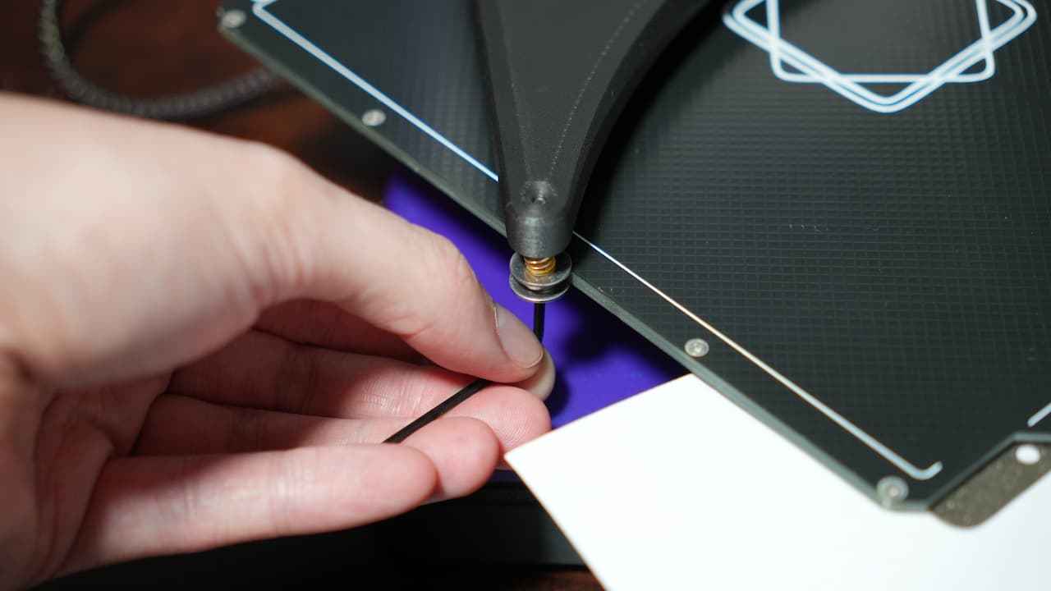
assets/guide/calibration---adjust-screw.jpg
