jamesloper/lemontron/assets/guide/calibration---disengage.png

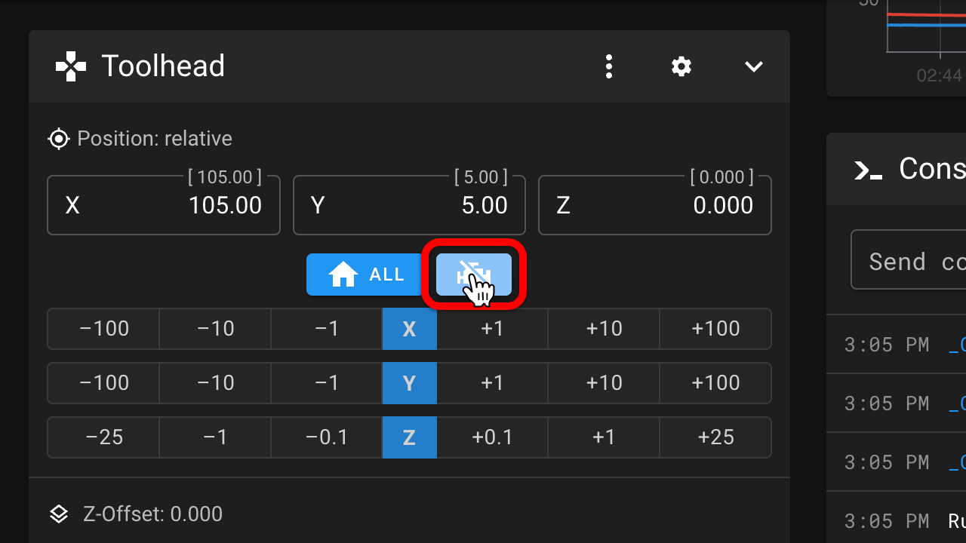
assets/guide/calibration---disengage.png
