jamesloper/lemontron/assets/guide/calibration---insert-paper.jpg

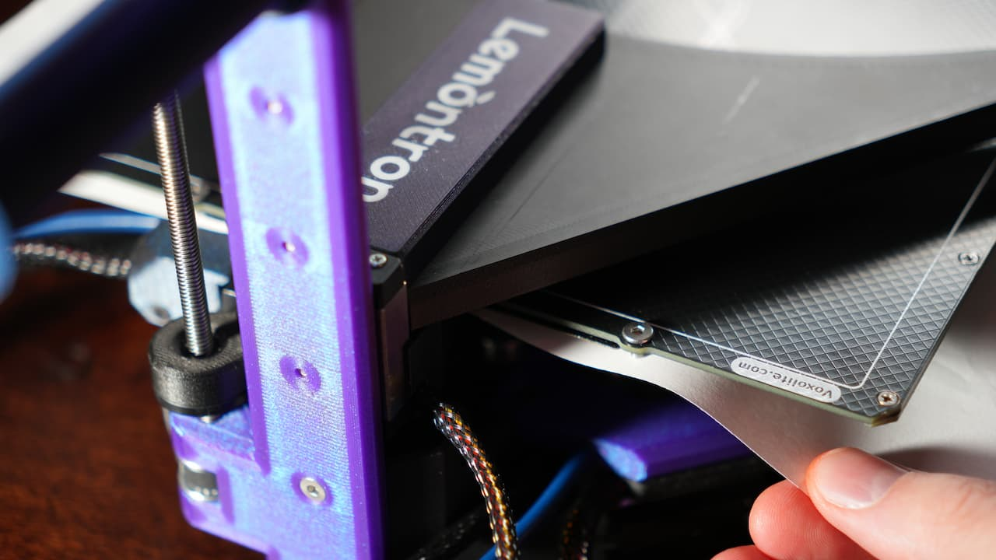
assets/guide/calibration---insert-paper.jpg
