jamesloper/lemontron/assets/guide/calibration---move-front-left.jpg

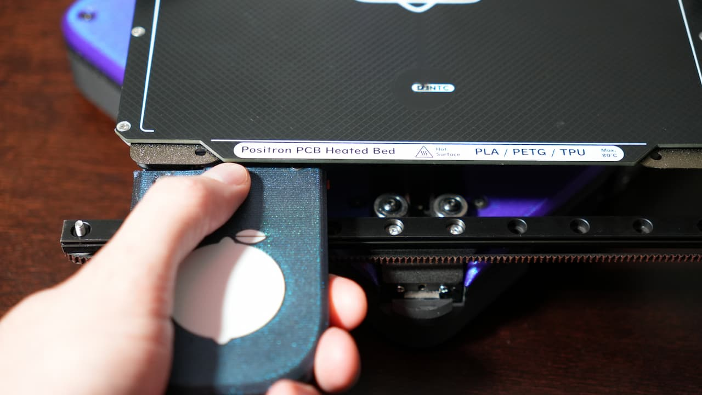
assets/guide/calibration---move-front-left.jpg
