jamesloper/lemontron/assets/guide/calibration---paper-front.jpg

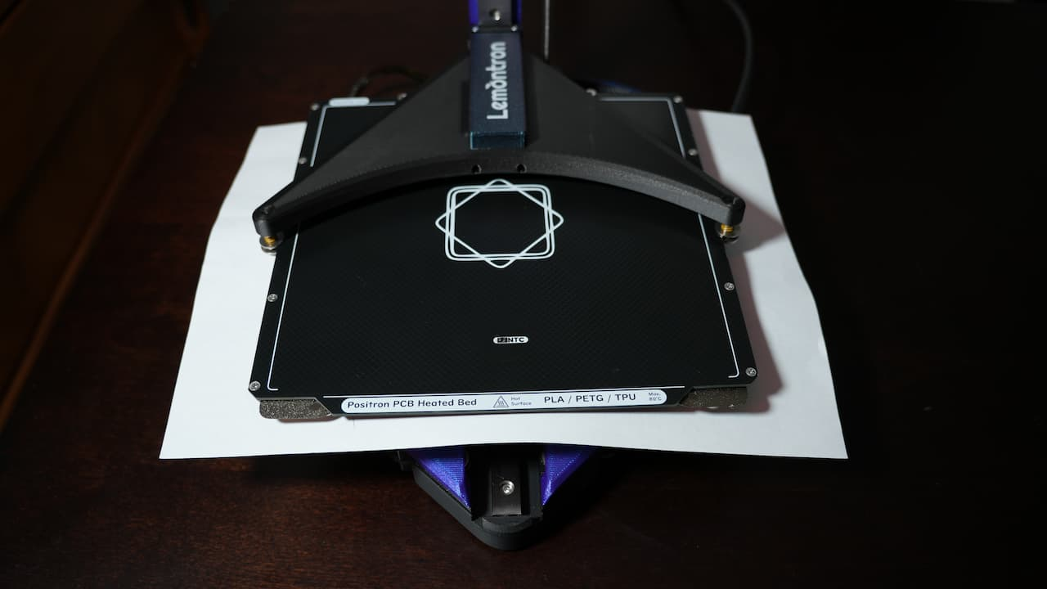
assets/guide/calibration---paper-front.jpg
