jamesloper/lemontron/assets/guide/calibration---repeat-right.jpg

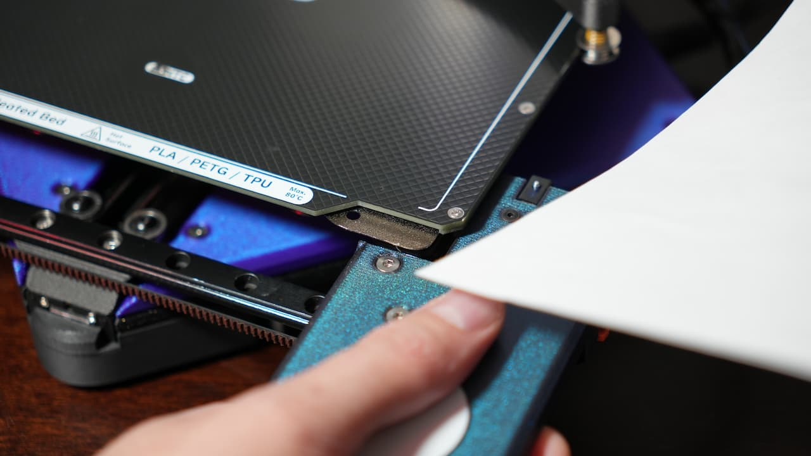
assets/guide/calibration---repeat-right.jpg
