jamesloper/lemontron/assets/guide/calibration---save.png

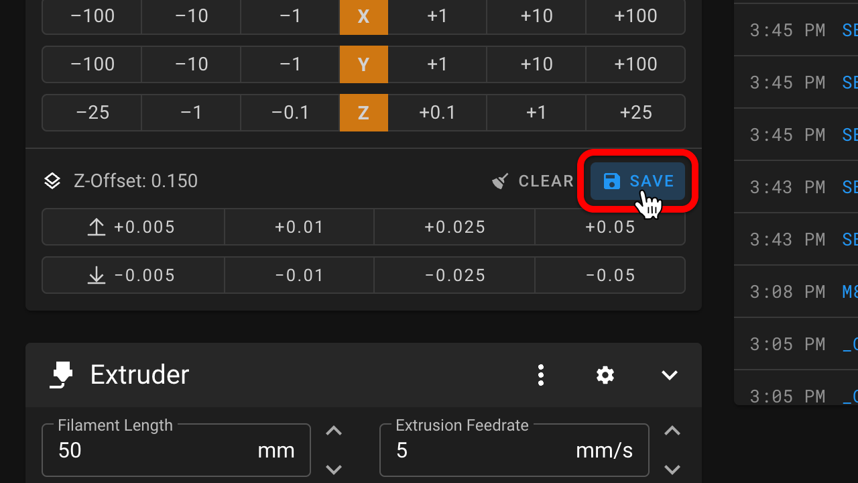
assets/guide/calibration---save.png
