jamesloper/lemontron/assets/guide/calibration---twist-lead-screw.jpg

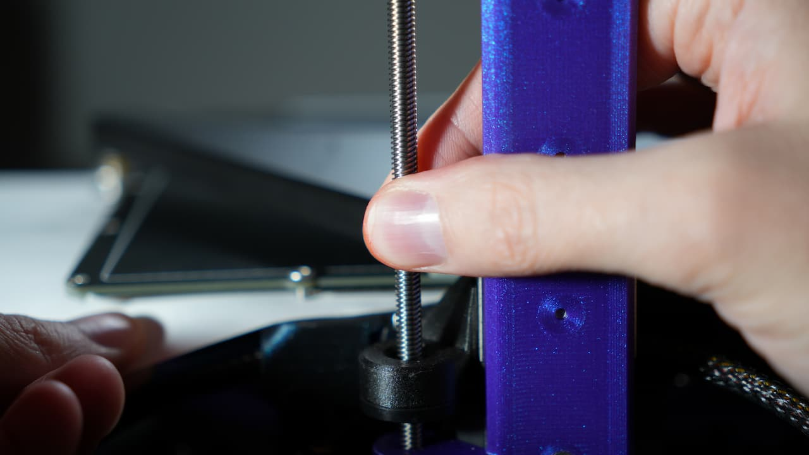
assets/guide/calibration---twist-lead-screw.jpg
