jamesloper/lemontron/assets/guide/calibration---z-offset.png

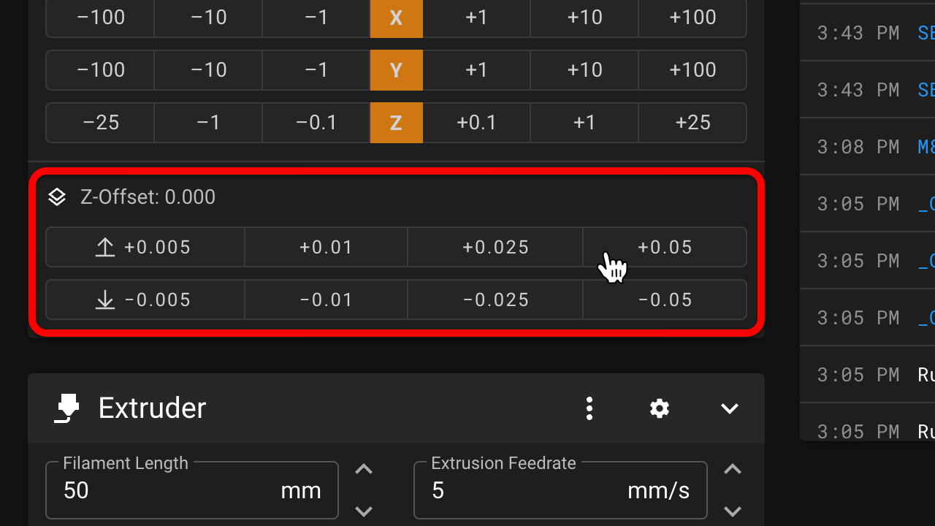
assets/guide/calibration---z-offset.png
