jamesloper/lemontron/(threads)

Thread 1 (2024-04-03):

unibody chassis

jamesloper, 2024-04-03:

Thread 2 (2024-04-03):

transparent build plate insulation

jamesloper, 2024-04-03:
- use lexel??!
