jamesloper/lemontron/(commit log)

2024-08-06 use jekyll
    [chassis.step, washer_shaper.step]
2024-08-13 new site
    [chassis.step, printer.cfg, washer-dishing-tool.step]
2024-10-10 kofi, new home page, new logo, new content
    [printer.cfg, screws.csv]
2024-10-12 update navigation
    [screws.csv]
2024-10-15 update printed parts guide
2024-10-21 add stepper motor cutting guide
    [stepper-cutting-guide.stl]
2024-10-21 add downloadable klipper config
2024-10-29 Add LDO PCB Bed and credit Sample Name
2024-11-04 Add comparison table to home page
    [positrons.csv]
2024-11-11 new video
    [positrons.csv]
2024-11-16 update home page
    [positrons.csv]
2024-11-16 remove voxolite store links, add rails tip
2024-11-16 update bom
2024-11-21 add rail lubrication video
2024-11-22 forgot ac socket
2024-11-23 remove useless idler
2024-11-26 update screws and washers
    [screws.csv]
2024-12-31 work on guide
    [screws.csv]
2025-01-03 Rev B update
    [screws.csv]
2025-01-05 Fix wrong insert diameter
2025-01-10 make /lemontron/ a directory
    [bom.csv]
2025-01-11 remove reference to 4.5mm inserts
2025-01-12 update screws, update links, home page
    [screws.csv]
2025-01-13 fix screws
2025-01-14 correct screw for lemonstruder, update home page
    [screws.csv]
2025-01-15 calibration article
2025-01-17 fix number of inserts, update image
2025-01-19 move to printables
2025-01-19 fix missing instructions for the upper pulley
2025-01-19 printables article
2025-01-20 eliminate 10mm m2.5 screws
    [screws.csv]
2025-01-27 clean up
    [bom.csv, screws.csv]
2025-02-12 explain silkscreen mistake
2025-02-17 update 3d printed parts descriptions
